tritone4801/chipathon-2026-A44-SAR-ADC/README.md

# Chipathon 2026 Team A44 8-bit SAR ADC

This repository contains the Team A44 8-bit, 2 MS/s, 3.3 V fully differential
capacitive SAR ADC design, its layouts, and its simulation results.

## DEF-aligned layout integration

The repository-root layout selected by `info.yaml` and `lvs_config.json` is
the `A44_A` project-slot top:

- [A44_A GDSII layout](gds/A44_A.gds)
- [A44_A integrated DEF](layout/def/A44_A.def)
- [A44_A LEF abstract](layout/lef/A44_A.lef)
- [Current layout files and physical checks](verification/a44_current_driven_pg_20260908)
- [Layout update record](layout/CHANGELOG.md)
- [Component layouts](gds/components)
- [Machine-readable current layout bindings](layout/CURRENT_LAYOUT.json)
- [Layout catalog and integration views](layout/README.md)

`A44_A` uses the official DEF origin `(0, 0)` and 1110-by-1110 um outline. Its
89 logical pins and 127 Metal2 pin shapes retain the official DEF locations:
85 logical pins are on the west edge and the four analog pins are on the north
edge. The 1000-by-1000 um SAR ADC CORE remains a child at `(55, 55)`.

## Current DRIVER_R2 layout implementation

The selected files are the local `DRIVER_R2` current-driven PG repair built on
the published VMP3/Q2 analog-ESD snapshot. It retains the MIM M5 coverFT and
earlier parent PG changes, then adds 209 metal rectangles and 1,924 ordinary
via cuts at the TOP, CORE and comparator owner levels. The interface, circuit
reference, DEF and LEF are unchanged. Current GDS files and saved views are
listed in [CURRENT_LAYOUT.json](layout/CURRENT_LAYOUT.json).

The [current publication and physical-check records](verification/a44_current_driven_pg_20260908),
[preserved VMP3 records](verification/a44_mslot_pg_20260905),
[Q2 analog ESD circuit](verification/a44_q2_analog_esd) and
[layout update record](layout/CHANGELOG.md) provide the corresponding files.

## Preserved earlier cap x1/3 baseline

The earlier cap x1/3 engineering baseline is preserved in the
[cap x1/3 CDAC package](verification/a44_cdac_cap_x1div3). It changes the C1
and dummy MIM multiplier from 18 to 6 while retaining the multiplier-18
reference switches, multiplier-8 sampling TG, comparator,
drivers, and SAR logic inherited from the W5P29 circuit.

The earlier package contains:

- [the cap x1/3 circuit delta](verification/a44_cdac_cap_x1div3/01_CURRENT_CIRCUIT_FILES);
- [R8/M6 east and west CDAC layouts](verification/a44_cdac_cap_x1div3/02_LAYOUT);
- [the earlier final-integration GDS and DRC/LVS records](verification/a44_cdac_cap_x1div3/02_LAYOUT/final_integration);
- [the official-DEF-aligned A44_A top and interface records](verification/a44_def_alignment);
- [structured acquisition, offset, and conversion results](verification/a44_cdac_cap_x1div3/03_RESULTS); and
- [the earlier package status](verification/a44_cdac_cap_x1div3/STATUS.json).

The CDAC component layout has zero native and GDS-readback DRC
errors on both sides and unique results for all 12 recorded LVS comparisons.
For the selected final-integration CORE cell, Magic full DRC reports zero
errors and all three hierarchical/flat full-transistor LVS views are unique.
The unified-TOP conversion records include `FAIL_FORMAL_MIN2`, where the second
MIN2 frame resolves to 0x00 in PEX while ideal and matching schematic resolve
to 0x01. The MIN-MAX-MIN and 0x7F-0x80-0x7F records contain the corresponding
three-frame codes and settling data.

## Preserved W5P29 schematic baseline

The previously published transistor-level schematic baseline is the
[W5P29 unit-transmission-gate-driver schematic package](verification/a44_w5p29_trans_driver/01_CURRENT_CIRCUIT_FILES).
It is additive; the
[original GitHub schematic](verification/a44_r2/01_CURRENT_CIRCUIT_FILES)
remains unchanged. Relative to that original schematic, the current baseline
changes only the following published components, bindings, and sizes:

- **StrongARM comparator:** the input pair changes from M3/M4 at
  W/L = 3.51/0.28 µm, `m=4`, to CMP55_A XCOMP_INPUT_P/N at
  W/L = 55.8/0.28 µm, `m=4`. The published M5/M6 width of 8.2524 µm and
  M7/M11 width of 16.8587 µm are retained.
- **CDAC:** the monolithic `CDAC`, whose
  capacitor multipliers are 1/2/4/8/16/32/64, changes to
  `A44_CDAC_UNIT_TRANS_DRIVER` with explicit
  `A44_C1_SWITCH`/C2/C4/C8/C16/C32/C64 unit hierarchy. Each C1 unit uses the
  6.855-by-6.855 µm MIM capacitor with multiplier 18 and N/P reference
  switches at W/L = 1.56/0.28 µm, `m=18`. Each side has 127 switched units
  plus one dummy unit, approximately 230.72 pF per side.
- **Sampling switch:** `SWITCH_BOOT_SP` changes to `A44_SWITCH_TRANS_TG8`;
  its N device is W/L = 3.11/0.28 µm, `m=8`, and its P device is
  W/L = 6.22/0.28 µm, `m=8`.
- **Digital-control drive:** the direct control connection changes to one
  `A44_CONVERSION_BUFFER` two-stage transistor driver per bit. INV1 N/P widths
  are 2.34/4.67 µm and INV2 N/P widths are 6.22/12.44 µm, all at L = 0.28 µm.
- **Sampling-clock drive:** direct `CLKS` distribution changes to the
  non-inverting C1 two-stage buffer and internal `CLKS_CORE`. Stage-one N/P
  widths are 0.78/1.56 µm and stage-two N/P widths are 3.11/6.22 µm, all at
  L = 0.28 µm.
- **SAR-logic binding:** the generic SS-corner PEX wrapper changes to the R1L
  true-transistor SS-corner PEX core and a header-aware 28-pin wrapper.
  The logic-to-converter/output interface changes from underscore aliases to
  `DCTRLP[7:1]`, `DCTRLN[7:1]`, and `DOUT[7:0]` bracket names.

## Preserved A44_W5P29_UNIT_TRANS_DRIVER electrical results

The following five entries and their order are preserved from the prior W5P29
publication. They describe the multiplier-18 capacitor baseline; current
multiplier-6 CDAC results are listed in the current package above.

| Simulation or execution | Completion | Result summary |
| --- | ---: | --- |
| 100-sample independent Monte Carlo mismatch dynamic simulation at the typical-typical process corner, 3.3 volts, 27 degrees Celsius, using the low differential-input band and steady-state frames 4 through 67 | **100/100** | Audit record: 100/100 hard-dynamic passes and 100/100 SNR-budget passes, with zero protocol, Parseval, or clipping failures; minimum/mean/maximum SNDR is 47.993/48.927/49.890 dB and ENOB is 7.680/7.835/7.995 bit |
| Full 255-transition static transfer-curve simulation | **255/255** | Representative preselected TT seed 98 passed all 255 transitions, with zero missing codes and zero nonmonotonic transitions; maximum absolute DNL is 0.109557 LSB and maximum absolute endpoint-fit INL is 0.133033 LSB |
| Three-corner process-voltage-temperature dynamic simulation using 20 selected Monte Carlo mismatch samples per corner | **60/60** | All 60 paired TT, SS, and FF records passed the system specification with zero protocol failures; mean SNDR is 48.928/46.270/48.760 dB, respectively, with SS as the limiting corner. The selected campaign uses fixed TT behavioral SAR timing |
| Circuit Automatic Characterization Engine package preflight | **Planned** | No CACE package preflight result is included in `PEX_GOLDEN_BASELINE`; the available preflight records describe individual simulation campaigns |
| Quick result-reproduction run | **Planned** | No quick result-reproduction run corresponding to this entry is included in `PEX_GOLDEN_BASELINE`; the folder instead contains audited 100-sample dynamic, full-static, selected three-corner 20-sample, and 100-sample offset packages |

Historical typical-corner results reproduce exactly when their historical
electrical inputs are restored. The current C18 unit converter, TG8 switch,
CMP55_A input pair, control drivers, and C1 clock buffer form a different
electrical baseline with its own result package.

## Preserved revision 2 package and electrical results

The preserved [revision 2 resized-circuit simulation package](verification/a44_r2)
contains:

- its revision 2 Xschem, SPICE, and RTL circuit files;
- completed dynamic, static, and PVT simulation
  results;
- CACE and simulation tooling;
- one-click launchers and method documentation.

All simulations planned for that preserved revision 2 package were executed;
the hard-dynamic results record failures at seeds 65, 68, and 141.

See [Team A44 revision 2 progress and performance](docs/A44_SAR_ADC_R2_PROGRESS_AND_PERFORMANCE.md)
for the complete methods, numerical results, and result locations.

The current project tracker is available at
[Team A44 project tracker, revision 2](docs/A44_SAR_ADC_Project_Tracker_20260728_R2.xlsx).

| Simulation or execution | Completion | Result summary |
| --- | ---: | --- |
| 200-sample Monte Carlo mismatch dynamic simulation at the typical-typical process corner, 3.3 volts, 27 degrees Celsius, using the low differential-input band and steady-state frames 4 through 67 | 200/200 | 197 hard-dynamic passes; failures at seeds 65, 68, and 141 |
| Full 255-transition static transfer-curve simulation | 6 unique curves | Pass based only on seed 44 at TT, 3.3 V, and 27 °C |
| Three-corner process-voltage-temperature dynamic simulation using 20 selected Monte Carlo mismatch samples per corner | 60/60 | Selected three-corner diagnostic campaign |
| Circuit Automatic Characterization Engine package preflight | 1/1 | Pass; final voltage is 1.250 V |
| Quick result-reproduction run | 130/130 | Pass |

For the full static transfer curve, seed 44 at TT, 3.3 V, and 27 °C is the
reported case. Its maximum
absolute DNL is 0.610351 LSB, its maximum absolute INL is 0.686645 LSB, and it
has no missing codes or reversals. Other TT seeds and the seed-44 SS and FF
corner curves are diagnostic only.

## One-click package entry points

From `verification/a44_r2` on Windows, run the quick result-reproduction flow:

```powershell
.\RUN_QUICK_VERIFY.ps1
```

The full campaign launcher executes every planned dynamic and static
simulation and can be long-running:

```powershell
.\RUN_FULL_CAMPAIGN.ps1
```

To stage and validate the full campaign without dispatching the complete
matrix:

```powershell
docker exec iic-osic-tools_a44_xvnc bash --noprofile --norc -lc "cd /foss/designs/chipathon-2026-A44-SAR-ADC/verification/a44_r2 && make -C 03_CACE_AND_SIMULATION_TOOLS full-dry-run"
```

## Ideal reference model

The earlier ideal SAR ADC flow remains available under
[the ideal reference model](verification/ideal_sar). It provides the ideal
system-level reference implementation and associated simulation flow.
