tritone4801/chipathon-2026-A44-SAR-ADC/verification/a44_r2/02_SIMULATION_RESULTS/05_CACE_GENERATED/reports/cace_job.md

# cace_job

- Description: A44 standalone package CACE 2.9 executable preflight
- PDK: gf180mcuD

## Authorship

- Designer: OpenAI Codex packaging workflow
- Company: None
- Created: 2026-07-28
- Last modified: 2026-07-28
- License: None

## Pins

## Default Conditions

## Symbol

Symbol of cace_job

## Schematic

Schematic of cace_job
