tritone4801/chipathon-2026-A44-SAR-ADC/verification/a44_r2/02_SIMULATION_RESULTS/02_PVT3_MC20_LOW_W4/reports/pvt3_mc20_report_cn.md

# StrongARM 比较器调整尺寸后的三工艺电压温度角动态仿真报告

本报告覆盖典型、慢速和快速三个工艺角；每个工艺角使用 20 个选定的
蒙特卡洛失配样本，共完成 60 个作业。

## 固定方法

- 最大瞬态步长：50 皮秒；
- 信号范围：低差分输入区间；
- 每个作业：68 帧；
- 第 0 至第 3 帧：首次转换和启动诊断；
- 第 4 至第 67 帧：正式稳态频谱统计窗口；
- 数字逻辑保持典型工艺角时序，逻辑电平和接口阈值随各工艺角电源电压缩放；
- 调整尺寸前后的比较使用相同失配种子、工艺角、电容式数模转换器失配样本和事件噪声种子。

## 各工艺角结果

### 典型工艺角、3.3 伏、27 摄氏度

- 硬动态通过数从 14/20 提高到 19/20；
- 信噪预算通过数从 10/20 提高到 18/20；
- 信号噪声失真比的配对中位数变化为正 0.922 分贝；
- 有效位数的配对中位数变化为正 0.1531 位；
- 首次转换诊断为 20/20。

### 慢速工艺角、3.0 伏、125 摄氏度

- 硬动态通过数从 18/20 提高到 20/20；
- 信噪预算通过数从 16/20 提高到 19/20；
- 信号噪声失真比的配对中位数变化为负 0.135 分贝；
- 有效位数的配对中位数变化为负 0.0224 位；
- 首次转换诊断为 20/20。

### 快速工艺角、3.6 伏、负 40 摄氏度

- 硬动态通过数从 2/20 提高到 20/20；
- 信噪预算通过数从 1/20 提高到 18/20；
- 信号噪声失真比的配对中位数变化为正 4.756 分贝；
- 有效位数的配对中位数变化为正 0.7900 位；
- 首次转换诊断为 20/20。

## 跨工艺角结果

典型工艺角有 19 个样本通过，其中 19 个样本在慢速和快速工艺角下也继续
通过。另有 1 个样本在非典型工艺角恢复，没有样本因工艺角变化而从通过
变为未通过。

## 结论边界

这 20 个样本是定向选择的尾部、边缘和机制诊断样本，不代表总体良率。
本报告只说明同一固定动态方法下的比较器尺寸变化结果，不形成 200 样本
蒙特卡洛总体、晋级或签核结论。
