tritone4801/chipathon-2026-A44-SAR-ADC/verification/a44_r2/02_SIMULATION_RESULTS/04_CROSS_CAMPAIGN_SUMMARY/reports/FINAL_REPORT_CN.md

# 当前 StrongARM 比较器调整尺寸后的动态与静态仿真汇总

## 结论

所有规定仿真均已执行。动态总体结果明显改善，但 200 样本蒙特卡洛失配
动态仿真仍有 3 个样本未通过硬动态判据，因此当前设计不晋级，也不作签核
声明。

种子 44 在慢速工艺角、3.0 伏、125 摄氏度下的完整静态传输曲线保留为
诊断结果；唯一静态资格判定依据仍是种子 44 在典型工艺角、3.3 伏、
27 摄氏度下的曲线。

## 200 样本蒙特卡洛失配动态仿真

固定条件为典型工艺角、3.3 伏、27 摄氏度、低差分输入区间、50 皮秒
最大瞬态步长，以及第 4 至第 67 帧的正式稳态统计窗口。

- 完整记录：200/200；
- 执行异常：0；
- 硬动态通过：197/200；
- 未通过种子：65、68、141；
- 信号噪声失真比第一、第五、第十百分位和中位数分别为
  46.8729、47.2961、47.4636 和 48.4065 分贝；
- 正式批次墙钟时间：77.29 分钟。

## 三工艺电压温度角动态仿真，每角 20 个选定蒙特卡洛失配样本

| 工艺角与工作条件 | 硬动态通过 | 信噪预算通过 | 信号噪声失真比中位数 | 配对中位数变化 |
| --- | ---: | ---: | ---: | ---: |
| 典型工艺角、3.3 伏、27 摄氏度 | 19/20 | 18/20 | 48.4048 分贝 | 正 0.9217 分贝 |
| 慢速工艺角、3.0 伏、125 摄氏度 | 20/20 | 19/20 | 48.3026 分贝 | 负 0.1346 分贝 |
| 快速工艺角、3.6 伏、负 40 摄氏度 | 20/20 | 18/20 | 48.6010 分贝 | 正 4.7556 分贝 |

全部 60 个作业和 60 个首次转换诊断均完成。正式批次墙钟时间为
22.01 分钟。这些样本用于工艺角诊断，不能外推生产良率。

## 完整 255 个码间转换静态传输曲线仿真

| 工艺角与工作条件 | 种子 | 状态 | 最大绝对微分非线性 | 最大绝对积分非线性 | 缺失码 | 反转 |
| --- | ---: | --- | ---: | ---: | ---: | ---: |
| 典型工艺角、3.3 伏、27 摄氏度 | 44 | 通过，唯一资格依据 | 0.6104 个最低有效位 | 0.6866 个最低有效位 | 0 | 0 |
| 典型工艺角、3.3 伏、27 摄氏度 | 116 | 仅诊断 | 0.4226 个最低有效位 | 0.3580 个最低有效位 | 0 | 0 |
| 典型工艺角、3.3 伏、27 摄氏度 | 180 | 仅诊断 | 0.4695 个最低有效位 | 0.4519 个最低有效位 | 0 | 0 |
| 典型工艺角、3.3 伏、27 摄氏度 | 106 | 仅诊断 | 0.1467 个最低有效位 | 0.0939 个最低有效位 | 0 | 0 |
| 慢速工艺角、3.0 伏、125 摄氏度 | 44 | 仅诊断 | 1.4963 个最低有效位 | 1.5726 个最低有效位 | 1 | 1 |
| 快速工艺角、3.6 伏、负 40 摄氏度 | 44 | 仅诊断 | 0.3288 个最低有效位 | 0.4168 个最低有效位 | 0 | 0 |

共计算 6 条唯一曲线和 1530 个码间转换。种子 44 的典型工艺角曲线只
计算一次，并在两个结果视图中复用。

## 声明边界

- 200 样本蒙特卡洛失配动态仿真只覆盖固定的典型工艺角和低差分输入区间；
- 三工艺电压温度角动态仿真使用定向选择的诊断样本，不能外推生产良率；
- 完整静态仿真是确定性的种子与工艺角传输曲线；
- 不作版图、寄生提取、硅片、生产良率、流片或签核声明。
