tritone4801/chipathon-2026-A44-SAR-ADC/verification/a44_r2/02_SIMULATION_RESULTS/05_CACE_GENERATED/reports/cace_job_schematic.md

# CACE Summary for cace_job

**netlist source**: schematic

| Parameter | Tool | Result | Min Limit  |  Min Value | Typ Target |  Typ Value | Max Limit  |  Max Value |  Status  |
| :--- | :--- | :--- | ---: | ---: | ---: | ---: | ---: | ---: | :---: |
| A44 package CACE and ngspice preflight | ngspice | final_v | 1.249 | 1.25 | | | 1.251 | 1.25 | Pass ✅ |

## Plots
