tritone4801/chipathon-2026-A44-SAR-ADC/verification/a44_r2/02_SIMULATION_RESULTS/01_MC200_TT_LOW_W4/source_snapshot/prior_model_audits/comparator_noise_probability_report.md

# Comparator Noise Probability Report

- Generated UTC: `2026-07-01T23:57:59+00:00`
- Production design files modified: `none`

- Imported status: `PASS_SAR_EFFECTIVE_NOISE_SENSITIVITY_NOT_NATIVE_TRANSIENT_NOISE`
- Source directory: `D:\PICO\SAR_SUM_process_typicality_20260701_initial_gate\reports`

Claim boundary: The existing noise result is SAR-effective sensitivity, not native transient-noise decision-probability signoff.
