tritone4801/chipathon-2026-A44-SAR-ADC/verification/a44_r2/02_SIMULATION_RESULTS/01_MC200_TT_LOW_W4/references/fixed50_41_compact/reports/A44_MC200_FIXED50PS_NONREPRO_SUBSET_RERUN_REPORT_CN.md

# A44 200 样本蒙特卡洛失配仿真固定 50 ps 不可复现子集复现实验报告

## 1. 任务与固定条件

本次任务只复现此前 200 样本蒙特卡洛失配仿真结果中被判定为不一致或不可复现的部分，并与后期单独 10 样本蒙特卡洛失配仿真、早期 200 样本蒙特卡洛失配仿真及第 7 版 200 样本蒙特卡洛失配仿真对照。仿真条件在执行前冻结：

- 目标并集：41 个 seed-band 记录，41 个唯一 seed
- `maxstep = 50 ps`
- `solver_profile = ROBUST_GEAR`
- `NFFT = 64`
- 每个目标独立进程运行，最多 4 个并发 ngspice

目标并集来自三类标记：

| 标记来源 | 记录数 |
|---|---:|
| 早期 200 样本蒙特卡洛失配仿真与 V7 的 LOW 输出码不一致 | 33 |
| 后期 10 样本蒙特卡洛失配仿真与 V7 输出码不一致 | 6 |
| 极低尾部历史输出码未被 V7 复现 | 17 |

三类之间有重叠，因此并集为 41，不是 56。

## 2. 执行完整性

仿真于 2026-07-25 完成，执行状态为 `PASS_FIXED50_EXECUTION`：

- 41/41 目标记录有效
- 2624/2624 帧输出码存在
- 全部记录确认为 50 ps、`ROBUST_GEAR`
- 所有噪声输入一致性状态匹配
- 无 timeout、无仿真中止
- 最大并发 ngspice 数为 4
- 实际执行时间 752.992 s，约 12 分 33 秒

执行使用固定 50 ps 和独立进程 fallback。

## 3. 与各历史结果的整记录对照

“整记录一致”要求该 seed-band 的 64 帧输出码完全相同。

| 参考数据 | 可比记录 | 整记录一致 | 整记录不同 | 相同帧 | 不同帧 |
|---|---:|---:|---:|---:|---:|
| 早期 200 样本蒙特卡洛失配仿真 | 34 | 9 | 25 | 2149 | 27 |
| version 7 200-sample Monte Carlo mismatch simulation | 41 | 24 | 17 | 2607 | 17 |
| version 10 10-sample Monte Carlo mismatch simulation | 5 | 5 | 0 | 320 | 0 |
| version 11 10-sample Monte Carlo mismatch simulation | 4 | 4 | 0 | 256 | 0 |

V10 与 V11 有 1 个重叠目标，因此后期 10 样本蒙特卡洛失配仿真实际覆盖 8 个唯一目标；这 8 个目标全部与本次固定 50 ps 结果整记录一致。

## 4. 各类争议的归类结果

### 4.1 早期 200 样本蒙特卡洛失配仿真与 V7 的 33 个 LOW 分歧

- 本次固定 50 ps 结果与早期 200 样本蒙特卡洛失配仿真一致：9
- 与第 7 版 200 样本蒙特卡洛失配仿真一致：24
- 落入第三种整记录结果：0
- 其中具有后期 10 样本蒙特卡洛失配仿真参考的 6 个，全部与后期 10 样本蒙特卡洛失配仿真一致

这说明本次结果仍在两个历史分支间分化，但没有生成第三个完整输出流。

### 4.2 后期 10 样本蒙特卡洛失配仿真与 V7 的 6 个分歧

- 与后期 10 样本蒙特卡洛失配仿真一致：6/6
- 与 V7 一致：0/6

因此，在固定 50 ps、`ROBUST_GEAR` 条件下，原先的 6 个 10 样本蒙特卡洛失配仿真/V7 分歧明确落在后期 10 样本蒙特卡洛失配仿真一侧。

### 4.3 极低尾部的 17 个历史未复现记录

- 17/17 的指定争议帧与 R1 单独回放输出码一致
- 0/17 与 V7 正式结果中对应帧一致
- 相对 V7，每个记录恰好只有 1 帧不同，共 17 个不同帧
- 其中 6 个目标没有完整的早期 200 样本蒙特卡洛失配仿真/后期 10 样本蒙特卡洛失配仿真记录可作整记录参考，但其指定帧仍与 R1 回放一致

因此，本实验确认了“R1 回放分支”可在统一固定 50 ps 条件下再次复现；它没有复现 V7 中这 17 个极低尾部正式输出码。

## 5. maxstep 与求解器配置的解释力

针对早期 200 样本蒙特卡洛失配仿真与 V7 的 33 个 LOW 分歧，按早期运行配置分组：

| 早期配置 | 记录数 | 本次匹配早期 | 本次匹配 V7 |
|---|---:|---:|---:|
| 50 ps + DEFAULT | 6 | 0 | 6 |
| 50 ps + ROBUST_GEAR | 10 | 5 | 5 |
| 100 ps + DEFAULT | 17 | 4 | 13 |

据此可得：

1. 从早期的 50 ps + DEFAULT 改为固定的 50 ps + `ROBUST_GEAR`，6 个目标全部转到 V7 侧，说明求解器配置会影响分支。
2. 从 100 ps + DEFAULT 改为固定的 50 ps + `ROBUST_GEAR`，多数目标转到 V7 侧，但仍有 4 个保持早期侧。
3. 即便早期已经是相同的 50 ps + `ROBUST_GEAR`，10 个目标仍然 5/5 分裂。

因此，`maxstep` 和求解器配置具有影响，但不足以单独解释全部历史不一致。仅把 maxstep 固定为 50 ps，不能把所有目标收敛到唯一历史结果，也不能据此指定某一份历史 200 样本蒙特卡洛失配仿真为唯一“真值”。

## 6. 结论

- 本次 41 个目标的固定 50 ps 复现执行完整、数据有效。
- 后期 10 样本蒙特卡洛失配仿真的全部 8 个唯一可比目标均被精确复现。
- 原 6 个 10 样本蒙特卡洛失配仿真/V7 分歧全部支持后期 10 样本蒙特卡洛失配仿真分支。
- 17 个极低尾部指定帧全部支持 R1 回放分支，而不支持 V7 正式分支。
- 33 个早期 200 样本蒙特卡洛失配仿真/V7 LOW 分歧仍分为 9 个早期侧和 24 个 V7 侧；固定 50 ps 不是充分归因变量。

## 7. 非声明

本实验只覆盖冻结的 41 个争议 seed-band 记录，未重跑完整 200-seed × 2-band 200 样本蒙特卡洛失配仿真。因此：

- 不声明完整 200 样本蒙特卡洛失配仿真重新完成；
- 不重算或替代完整 200 样本蒙特卡洛失配仿真的 P10/P5/P1 动态性能；
- 不声明良率、极低尾部统计或 signoff 已关闭；
- 不把本次定向复现结果外推为所有 seed、band 或仿真配置的确定性结论。
