tritone4801/chipathon-2026-A44-SAR-ADC/layout/images/A44_SAR_ADC_CDAC_E_390X399P7.png

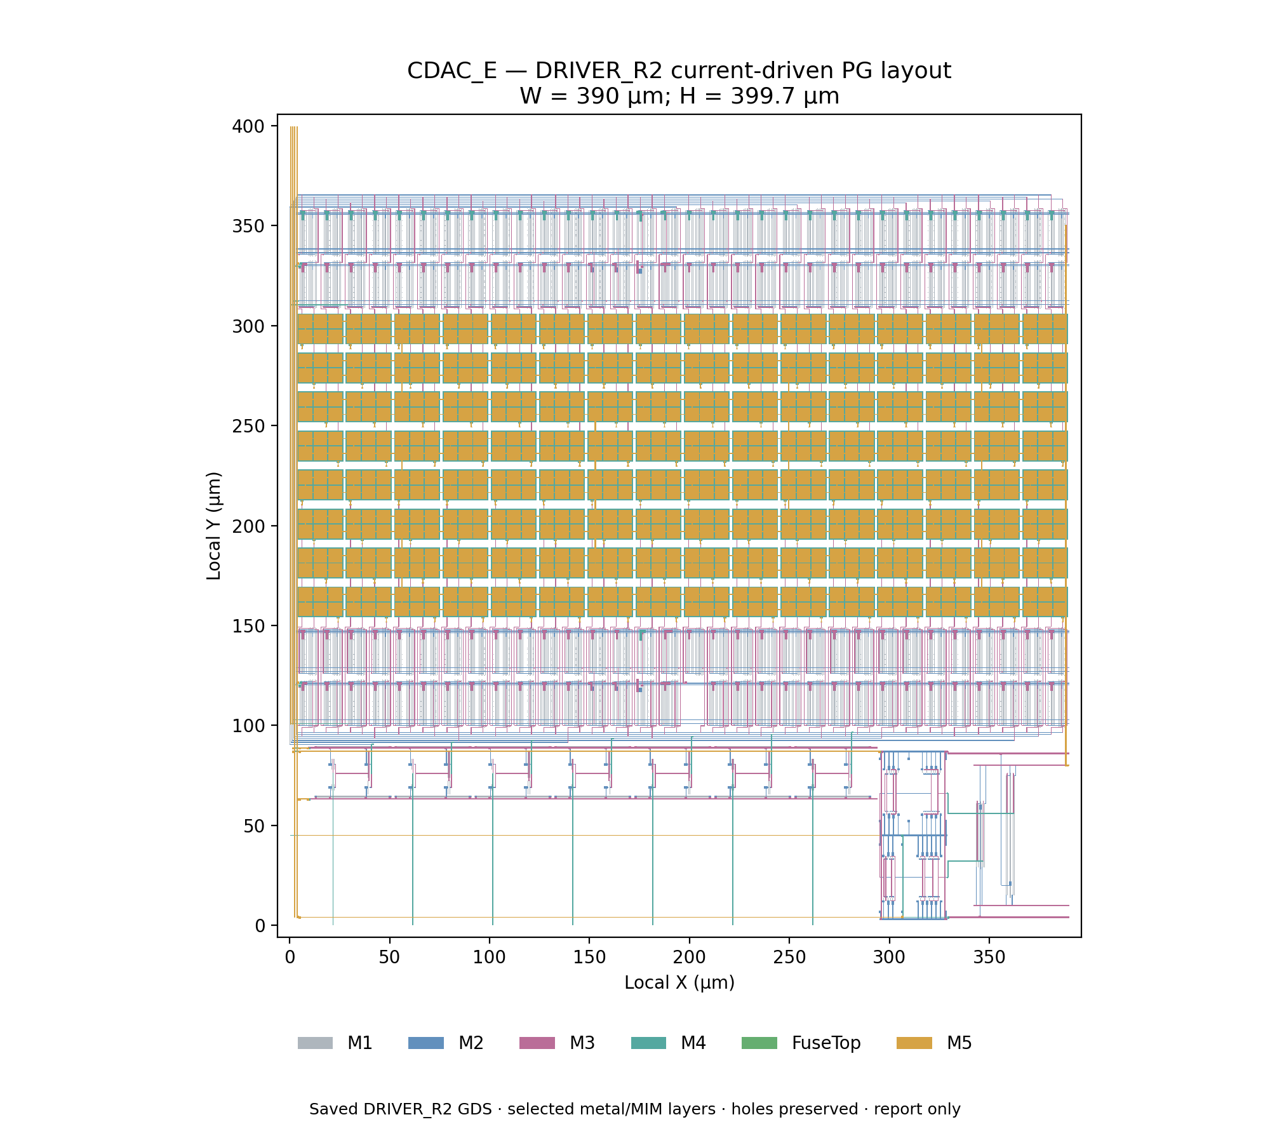
layout/images/A44_SAR_ADC_CDAC_E_390X399P7.png
