tritone4801/chipathon-2026-A44-SAR-ADC/layout/images/A44_SAR_ADC_CORE_1000.png

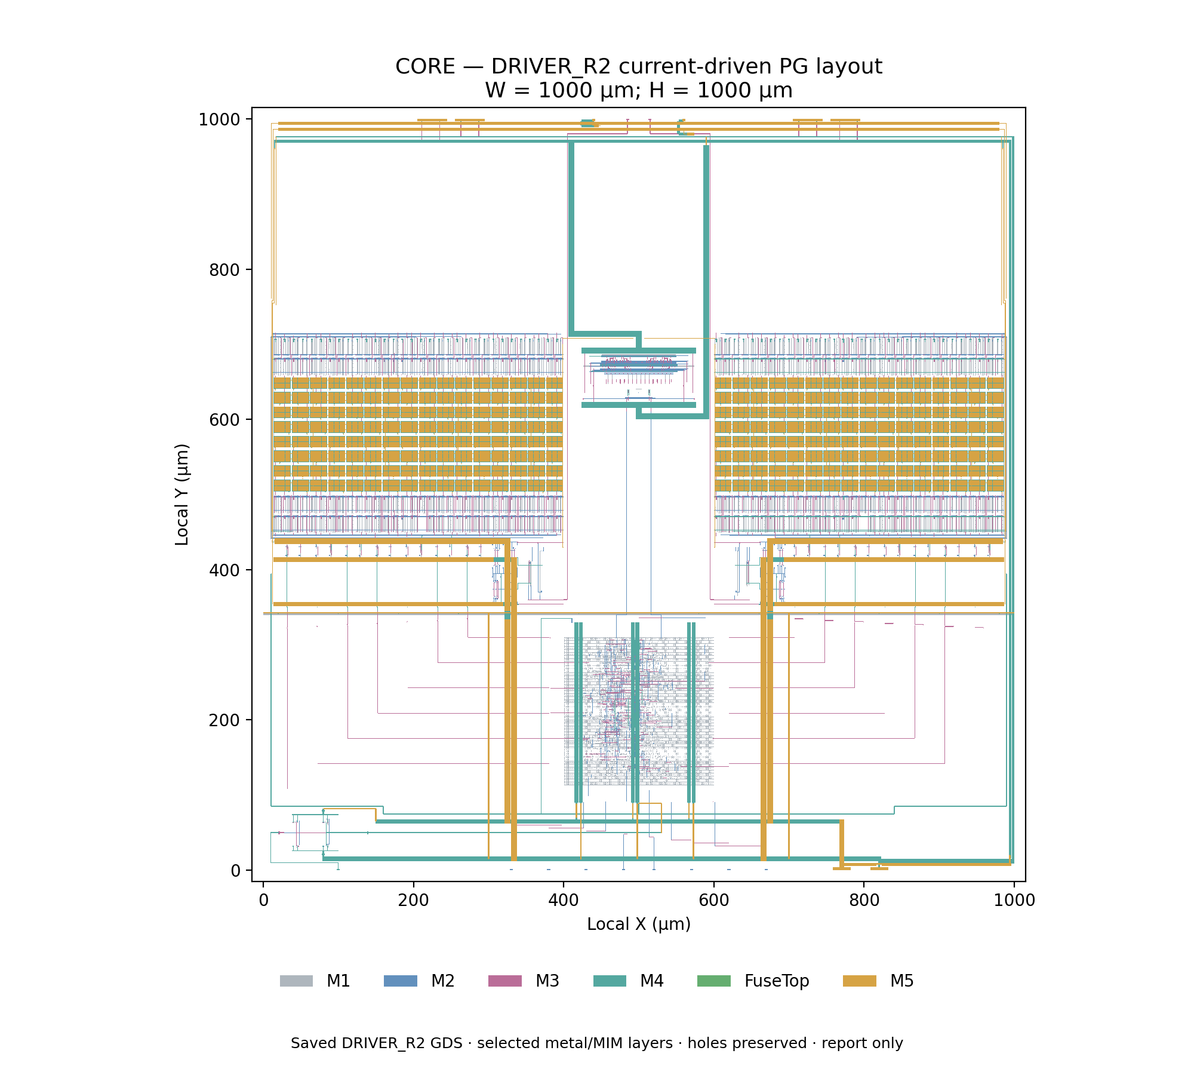
layout/images/A44_SAR_ADC_CORE_1000.png
