tritone4801/chipathon-2026-A44-SAR-ADC/layout/images/current_driven_pg_20260908/A44_SAR_ADC_CDAC_W_390X399P7.png

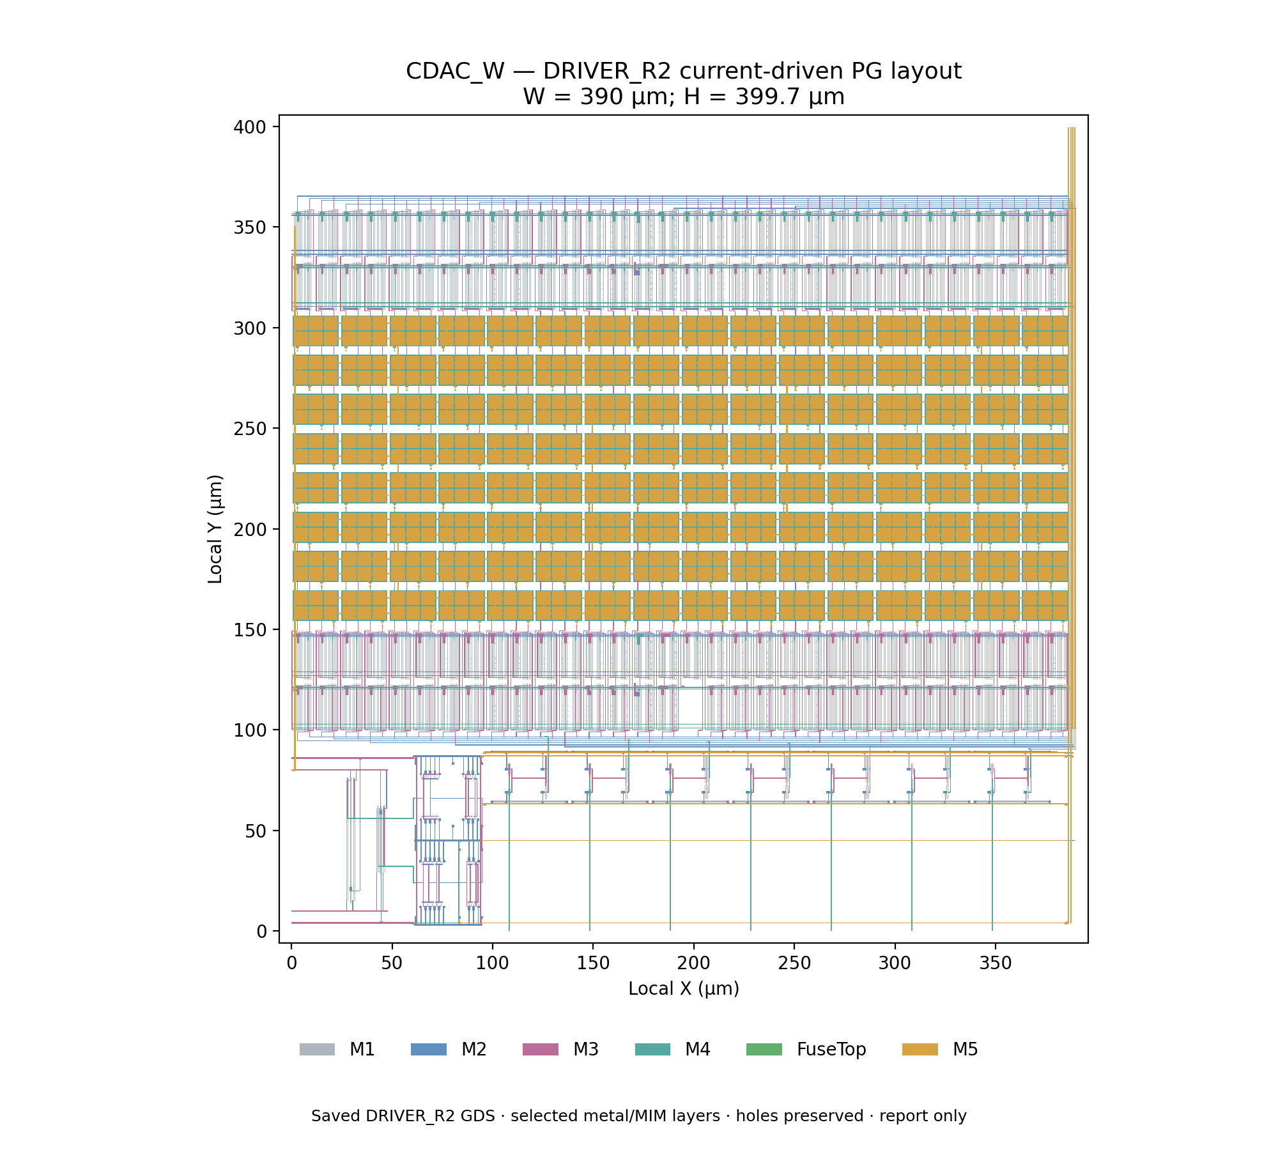
layout/images/current_driven_pg_20260908/A44_SAR_ADC_CDAC_W_390X399P7.png
