tritone4801/chipathon-2026-A44-SAR-ADC/layout/images/current_driven_pg_20260908/A44_SAR_ADC_SAR_LOGIC_240X240.png

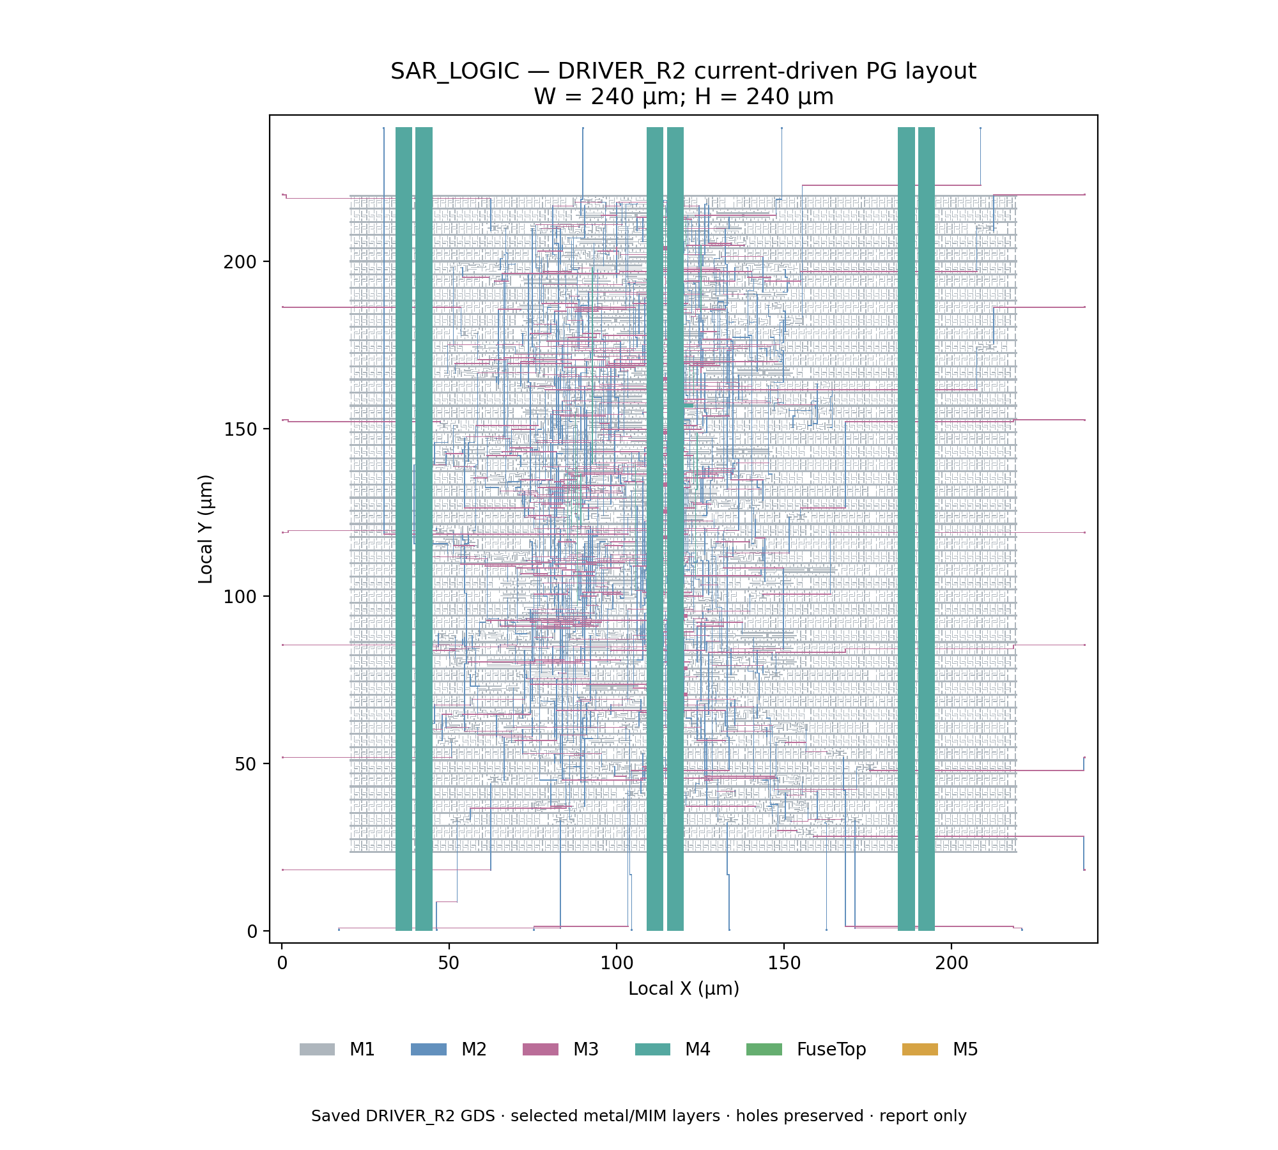
layout/images/current_driven_pg_20260908/A44_SAR_ADC_SAR_LOGIC_240X240.png
