tritone4801/chipathon-2026-A44-SAR-ADC/layout/images/mslot_pg_20260905/A44_SAR_ADC_CDAC_W_390X399P7.png

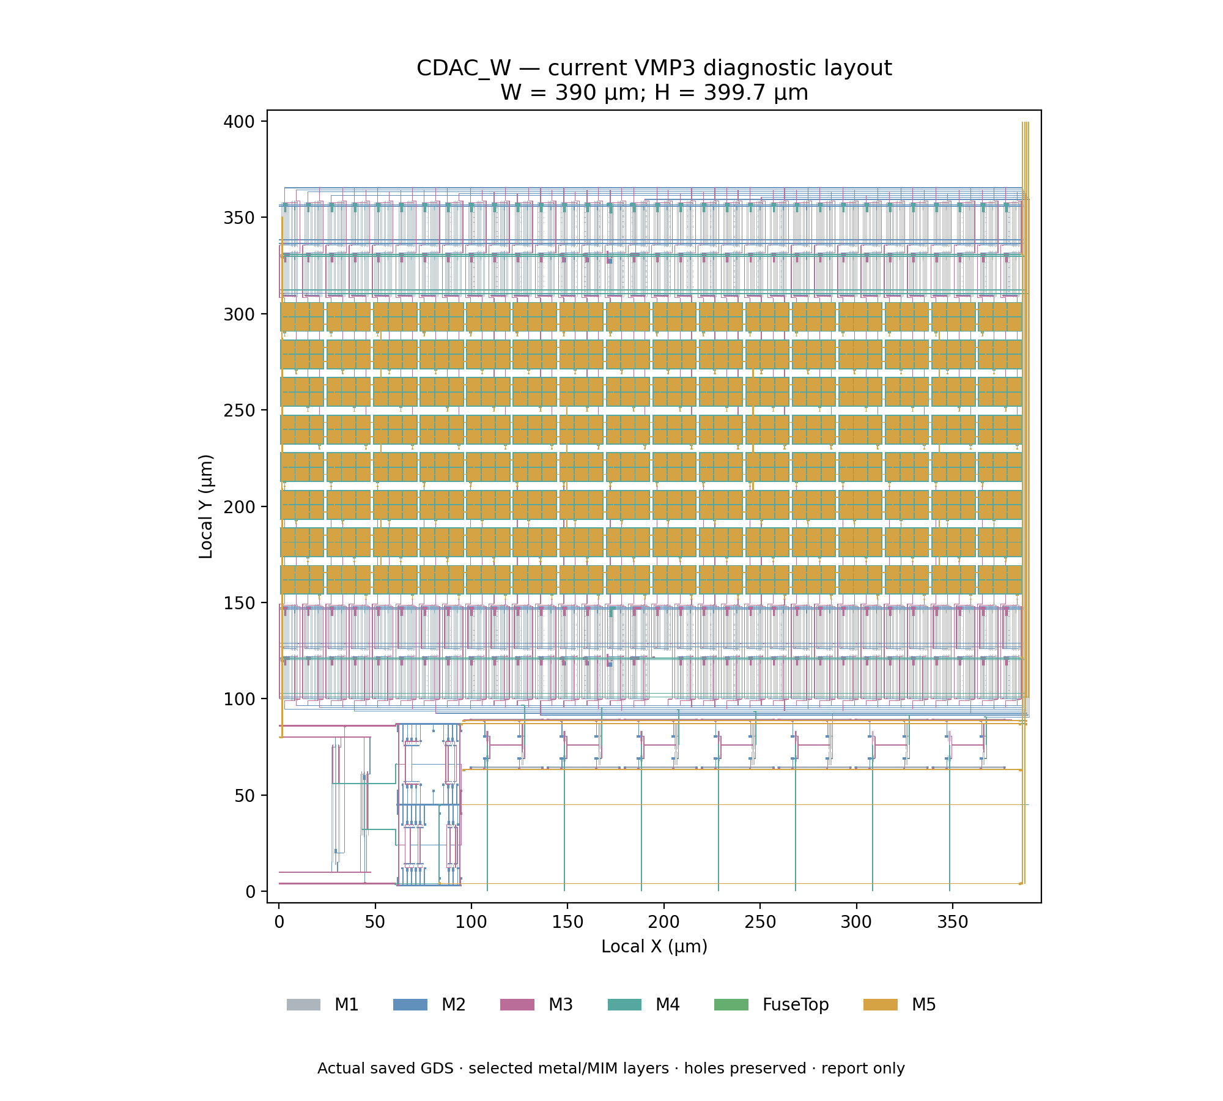
layout/images/mslot_pg_20260905/A44_SAR_ADC_CDAC_W_390X399P7.png
