tritone4801/chipathon-2026-A44-SAR-ADC/layout/images/mslot_pg_20260905/A44_SAR_ADC_CLKS_BUFFER_120X60.png

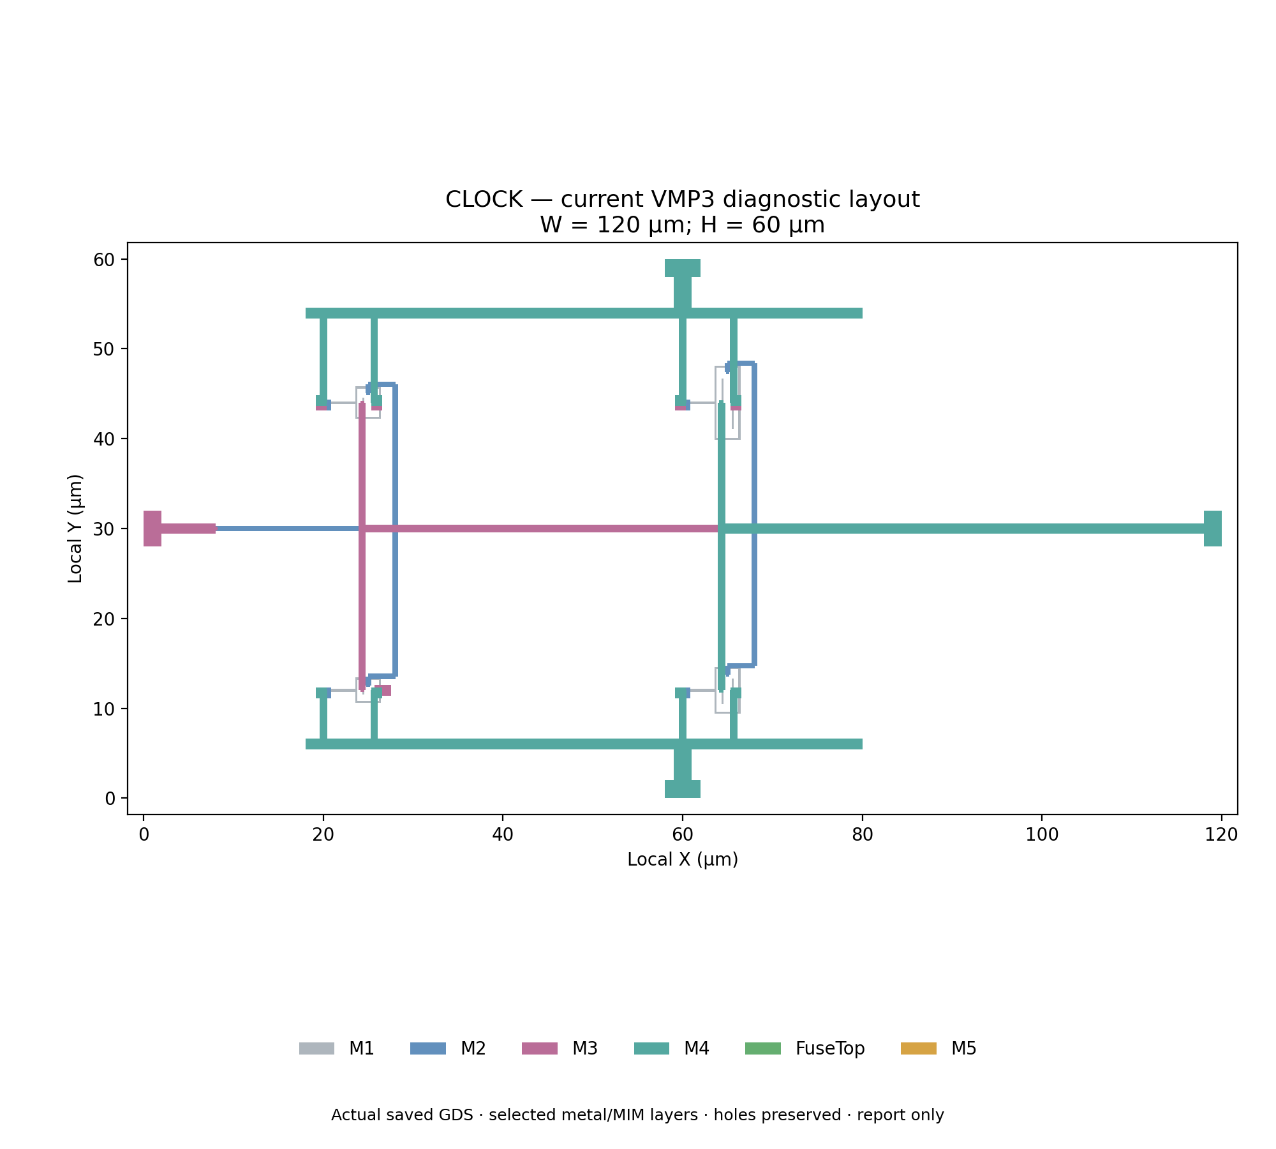
layout/images/mslot_pg_20260905/A44_SAR_ADC_CLKS_BUFFER_120X60.png
