tritone4801/chipathon-2026-A44-SAR-ADC/layout/images/mslot_pg_20260905/A44_SAR_ADC_CORE_1000.png

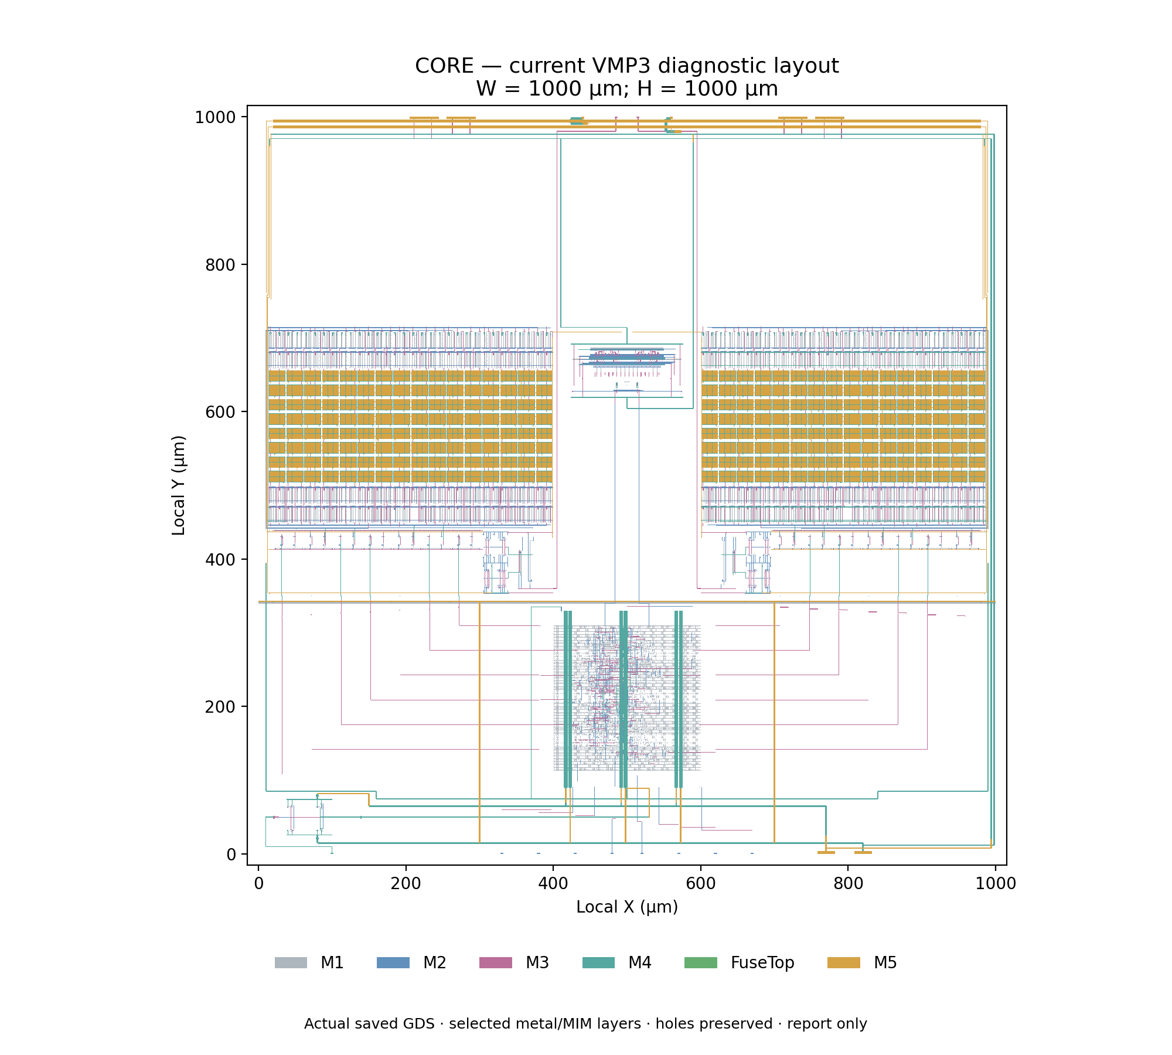
layout/images/mslot_pg_20260905/A44_SAR_ADC_CORE_1000.png
