tritone4801/chipathon-2026-A44-SAR-ADC/layout/images/q2_analog_esd_20260903/A44_ANALOG_ESD_ROUTES.png

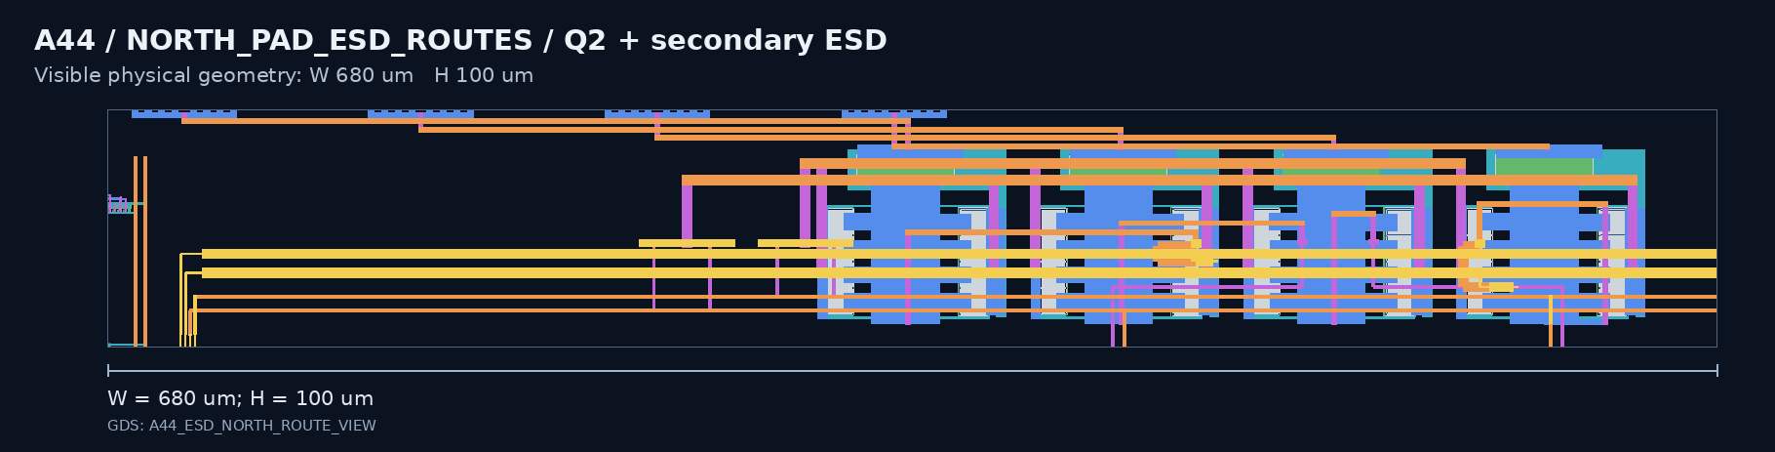
layout/images/q2_analog_esd_20260903/A44_ANALOG_ESD_ROUTES.png
