tritone4801/chipathon-2026-A44-SAR-ADC/layout/images/q2_analog_esd_20260903/io_secondary_5p0.png

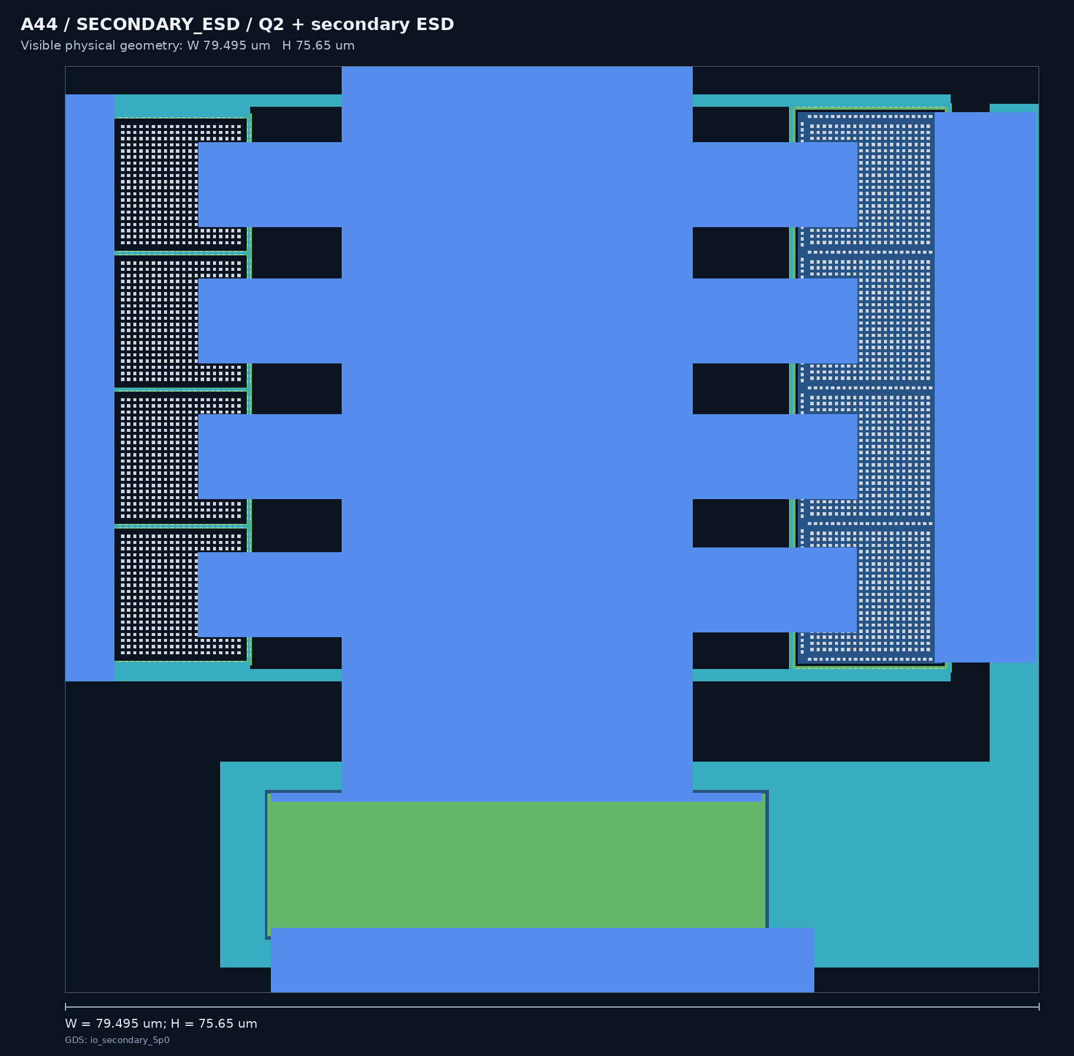
layout/images/q2_analog_esd_20260903/io_secondary_5p0.png
