tritone4801/chipathon-2026-A44-SAR-ADC/verification/a44_r2/02_SIMULATION_RESULTS/02_PVT3_MC20_LOW_W4/plots/pvt3_mc20_representative_spectra.png

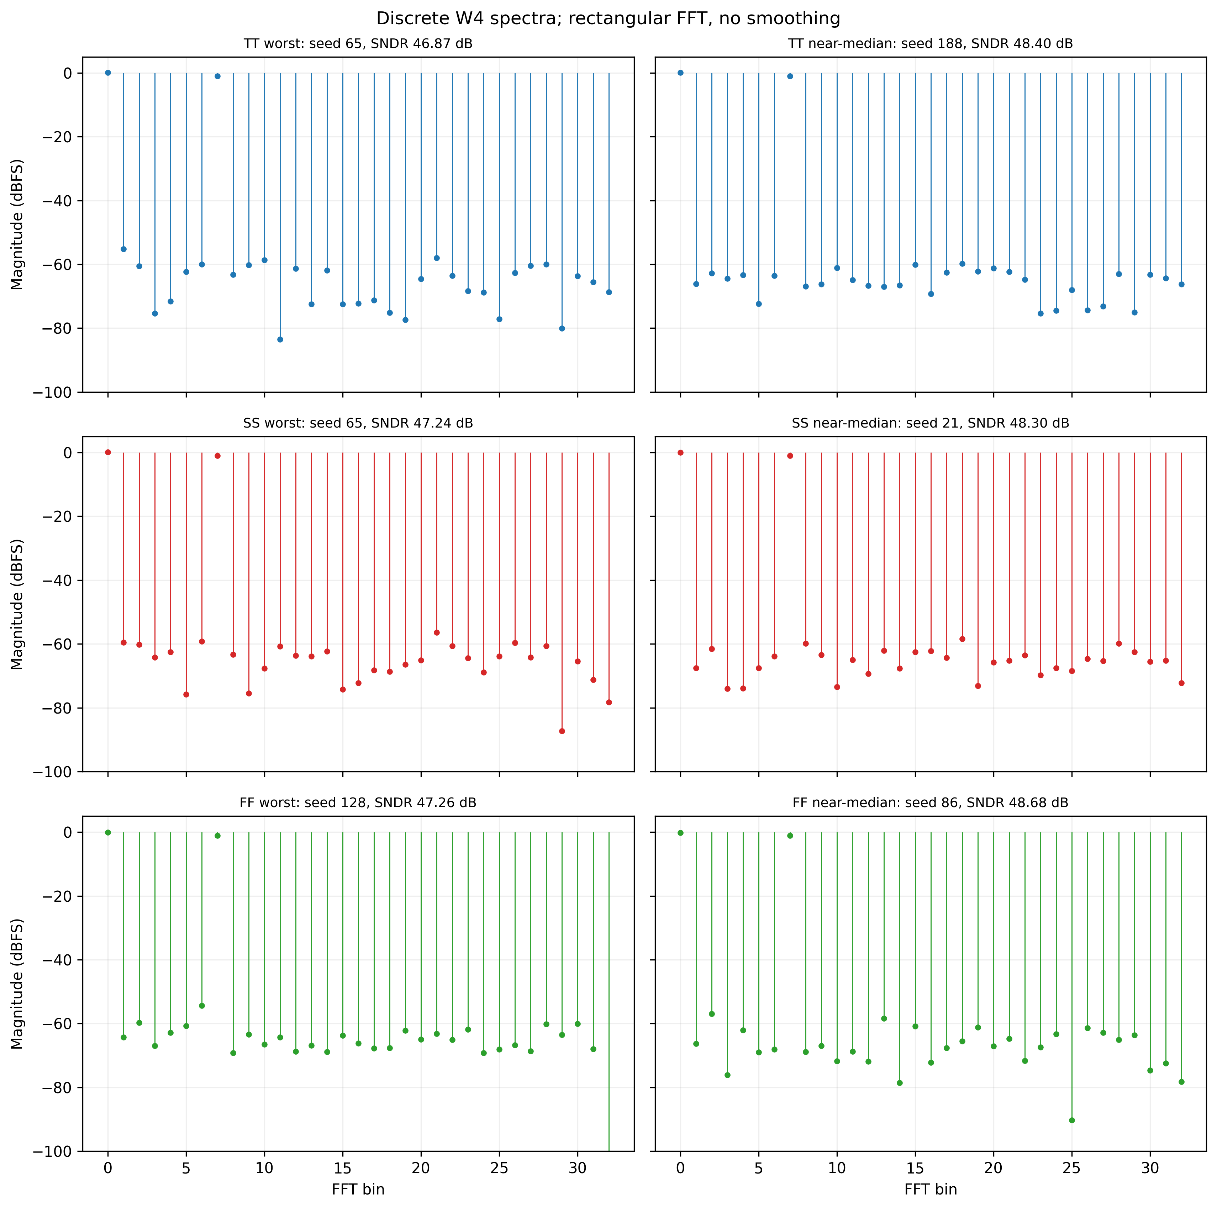
verification/a44_r2/02_SIMULATION_RESULTS/02_PVT3_MC20_LOW_W4/plots/pvt3_mc20_representative_spectra.png
