tritone4801/chipathon-2026-A44-SAR-ADC/verification/ideal_sar/results/plots/adc_quantization_error_spectrum_near_nyquist.png

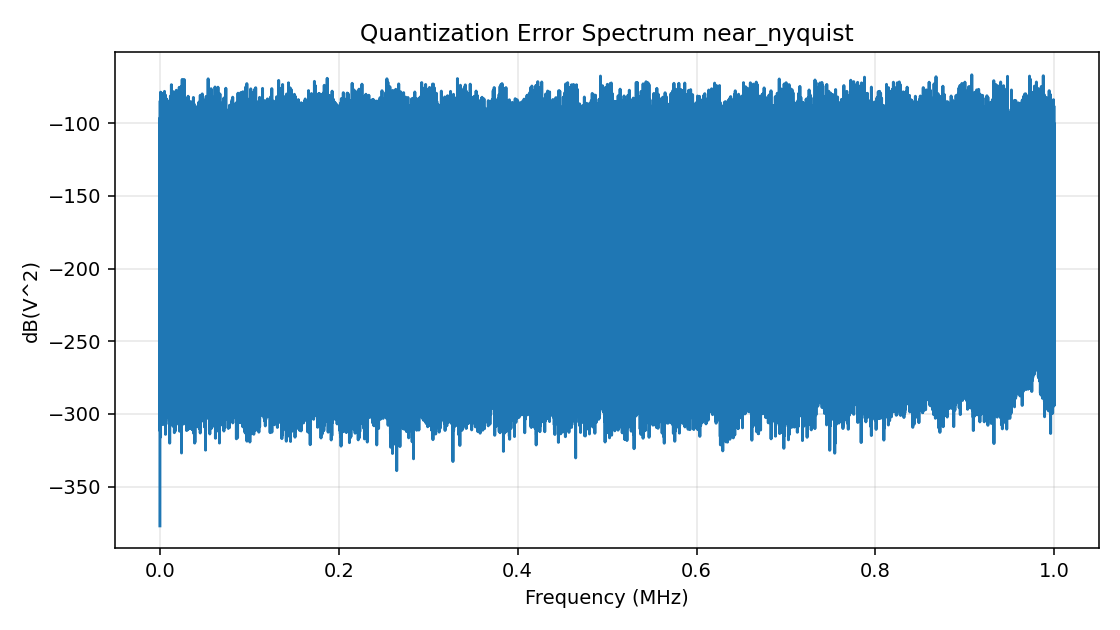
verification/ideal_sar/results/plots/adc_quantization_error_spectrum_near_nyquist.png
