tritone4801/chipathon-2026-A44-SAR-ADC/layout/images/q2_prefill_20260903/A44_SIX_COMPONENT_CATALOG.png

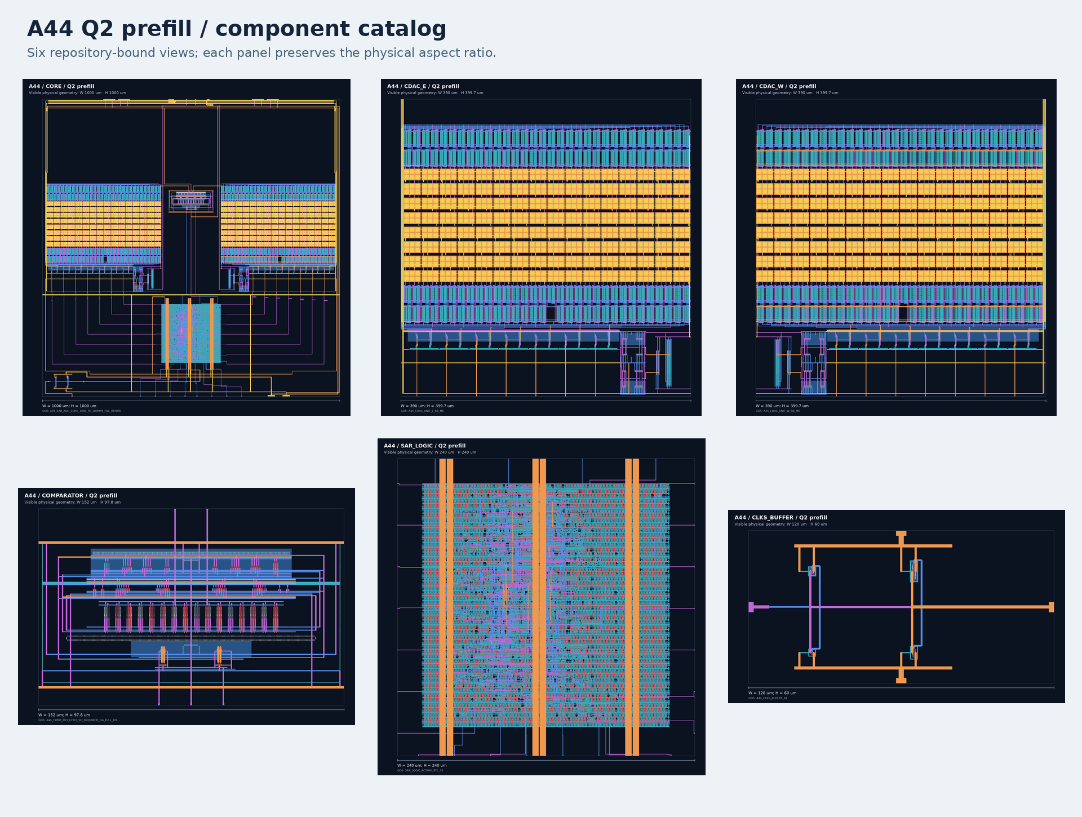
layout/images/q2_prefill_20260903/A44_SIX_COMPONENT_CATALOG.png
