tritone4801/chipathon-2026-A44-SAR-ADC/verification/a44_r2/02_SIMULATION_RESULTS/03_FULL255_STATIC/cases/S044_FF/references/historical_selection/static_mc200_reconstructed_summary.csv

mismatch_seed | sampler_offset_v | sampler_gain_negative | sampler_gain_positive | sampler_asymmetry_ppm | sampler_fit_rms_v | correction_offset_v | correction_vicm_slope_scaled_v | correction_settling_scale_v | correction_major_fit_max_error_lsb | correction_major_fit_rms_error_lsb | offset_lsb | gain_error_ppm | endpoint_lsb_v | minimum_code_width_lsb | missing_code_count | max_abs_dnl_lsb | max_abs_inl_endpoint_lsb | max_abs_inl_best_fit_lsb | worst_width_lower_code | worst_dnl_lower_transition | worst_inl_transition | static_risk_score | reconstructed_spec_status | cohort_residual_recalibrated
1 | 1.0196276058194913e-05 | 0.9999997187787143 | 0.9999990124791491 | -0.7063000132237282 | 1.755080678976236e-06 | -0.0014946245524099274 | -0.00603923505501917 | 1.0565306525111784e-05 | 0.005432267001369366 | 0.0030967193767179016 | 0.023504504144214292 | -1362.556924356384 | 0.013263153540848392 | 0.8449186531125571 | 0 | 0.2708838426398843 | 0.22810188692807565 | 0.22857637848017726 | 191 | 192 | 192 | 0.2708838426398843 | PASS | True
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
