tritone4801/chipathon-2026-A44-SAR-ADC/verification/a44_mslot_pg_20260905/README.md

# A44 MIM coverFT and PG layout files

This directory contains the existing physical-check records associated with
the saved VMP3 `A44_A` GDS published in the repository.

- [GDS DRC/LVS records](reports/GDS_DRC_LVS)
- [Public KLayout records](reports/PUBLIC_KLAYOUT)
- [DEF interface comparison](reports/DEF_INTERFACE_AUDIT.json)
- [Cell geometry comparison](reports/ALL_CELL_READBACK.json)
- [Mask comparison](reports/ALL_MASK_READBACK.json)
- [Capacitor and rail invariants](reports/PROTECTED_CAPACITOR_AND_RAIL_INVARIANTS.json)
- [Existing image bindings](IMAGE_BINDING.json)

The reports retain their original contents, including paths from the capture
environment. Current repository filenames are listed in
[CURRENT_LAYOUT.json](../../layout/CURRENT_LAYOUT.json).
