tritone4801/chipathon-2026-A44-SAR-ADC/verification/a44_cdac_cap_x1div3/00_CONTRACT/README.md

# Contract and coverage

- [`BASELINE_STATUS.json`](BASELINE_STATUS.json) is the source baseline's
  current working-status record.
- [`CONFIRMED_SIMULATION_METHODS.json`](CONFIRMED_SIMULATION_METHODS.json)
  freezes the input fixture, acquisition criterion, transient method, and
  result classifications.
- [`SIMULATION_COVERAGE_CURRENT_VS_OLD.csv`](SIMULATION_COVERAGE_CURRENT_VS_OLD.csv)
  separates completed current-capacitor work from historical results and
  remaining coverage.

These files are copied from the named baseline and retain its recorded values
and classifications.
