tritone4801/chipathon-2026-A44-SAR-ADC/verification/ideal_sar/results/README.md

# Ideal SAR ADC Results Map

This document is the review index for `verification/ideal_sar/results/`.
It follows the result-file requirements from
`D:\PICO\CODEX_IDEAL_SAR_ADC_TESTBENCH_VALIDATION.md` and points every
summary claim back to generated CSV, JSON, log, raw-data, or plot artifacts.
It does not introduce new measurements; the source of truth remains the
machine-readable result files.

## Status Snapshot

- Decision: `GO - testbench validated for schematic phase`.
- Authoritative full run: `logs/run_all_container.log`, ending with
  `go_no_go: GO` and `EXIT_CODE=0`.
- Final report: `../report/ideal_sar_adc_testbench_validation.md`.
- Single configuration source: `../config/sar_adc.yaml`.
- Machine-readable summaries: `metrics.json` and `csv/metrics.csv`.
- Coverage matrix: `csv/coverage_matrix.csv`, all rows PASS after report
  regeneration.
- Current result inventory is regenerated by `run_all.py all`; the dynamic
  subset includes timestamped input/output CSV, dBFS spectrum CSV, and figures
  for both canonical tones.

## Scope and Limits

The result package validates the ideal ADC/DAC/SAR testbench only. It confirms
that the measurement harness gives ideal results for a known-correct model and
detects injected bad models. It does not claim GF180 transistor-level sampler,
CDAC, comparator, reference, clock, layout parasitic, or SAR ADC power
performance. The power result is only a measurement-chain self-test.

The repository keeps the primary summary CSV at `results/csv/metrics.csv`
instead of `results/metrics.csv` so that all CSV files stay in one subdirectory.
This is the documented layout adjustment allowed by the execution
specification. `metrics.json` stays at the result root.

## Result Directory Map

| Path | Purpose | Primary consumer |
|---|---|---|
| `metrics.json` | Structured summary for all stages, tool versions, GO status, and derived constants. | Report builder and reviewers. |
| `csv/metrics.csv` | Main metric table with the required schema and local report-helper columns. | Summary table, signoff review. |
| `csv/coverage_matrix.csv` | Requirement-by-requirement PASS/FAIL coverage mapping. | Document completeness review. |
| `csv/*.csv` | Independent CSV data for functional, timing, static, dynamic, DAC, power-harness, fault-injection, and repeatability tests. | Metric drilldown. |
| `csv/adc_input_output_time_*.csv` | Timestamped representative input/output rows for the `0.8823529411764706` FS-peak canonical tones, equivalent to the frozen `3.0 Vpp,diff` input. Columns include VINP/VINN, sampled `v_diff`, EOC_INT-updated code, hex code, ideal-DAC output voltage, reconstruction, quantization error in V and LSB, CLKS falling sample marker, and EOC_INT. The official waveform comparison method is sampled input versus `ideal_DAC(DOUT)` reconstructed from EOC_INT-updated DOUT. | Time-domain waveform review. |
| `csv/adc_dac_reconstruction_low_frequency.csv` | Low-frequency-only sampled-input, EOC_INT-updated DOUT, and ideal-DAC reconstruction rows. This is the preferred visual comparison view because it makes the `x[n]` to `ideal_DAC(DOUT)` pairing clear. | DAC reconstruction visual review. |
| `csv/adc_output_spectrum_*.csv` | One-sided coherent FFT bin table in dBFS for the canonical tones, with fundamental, folded harmonics, largest spur, and noise classifications. | Spectrum review. |
| `csv/dynamic_points/*.csv` | One CSV per amplitude/frequency/phase dynamic sweep point. | SQNR/SQDR/SQNDR validation. |
| `logs/*.log` | Preflight, ngspice, cocotb, power proxy, and full-container execution logs. | Tool and command records. |
| `plots/*.png` | Automatically generated figures for independent performance metrics, input/output waveforms, output-code waveforms, and output spectra. | Report figures and visual review. |
| `raw/*` | Raw dynamic output codes, quantization-error samples, cocotb XML, and power-proxy waveform. | Re-analysis and spot checks. |

## Key Metrics

| Category | Metric | Requirement or ideal expectation | Measured | Status | Result files |
|---|---|---:|---:|---|---|
| Preflight | External core tools | `ngspice` + cocotb + HDL simulator available | `True` | PASS | `csv/preflight_tools.csv`, `logs/run_all_container.log` |
| Static | DNL | `< +/-1 LSB` project, `<=0.01 LSB` ideal | `2.6867397195928788e-14 LSB` | PASS | `csv/static_dnl.csv`, `plots/dnl.png` |
| Static | Endpoint INL | `< +/-1.5 LSB` project, `<=0.01 LSB` ideal | `0.0 LSB` | PASS | `csv/static_inl.csv`, `plots/inl_endpoint_bestfit.png` |
| Static | Quantization error RMS | `1/sqrt(12) LSB` | `0.2888729004379287 LSB` | PASS | `raw/quantization_error_lsb.csv`, `plots/quantization_error_histogram.png` |
| Dynamic | SNDR worst | `>=44 dB`, theory `48.83284675354814 dB` at 3.0 Vpp,diff | `48.80429130384699 dB` | PASS | `csv/dynamic_metrics.csv`, `plots/adc_sndr_summary.png` |
| Dynamic | ENOB worst | `>=7.0 bit`, about `7.8 bit` ideal at -1.09 dBFS | `7.81466632954269 bit` | PASS | `csv/dynamic_metrics.csv`, `plots/adc_enob_summary.png` |
| Dynamic | SQNR total TD baseline | `0.8823529411764706` FS coherent tones, theory `48.83284675354814 dB` | `48.78590230327425 dB` | PASS | `csv/dynamic_metrics.csv`, `plots/adc_sqnr_total_time_domain_summary.png` |
| Dynamic | SQNR spectral baseline | `0.8823529411764706` FS coherent tones, theory `48.83284675354814 dB` | `48.88579228818422 dB` | PASS | `csv/dynamic_metrics.csv`, `plots/adc_sqnr_spectral_summary.png` |
| Dynamic | SQDR baseline | `0.8823529411764706` FS coherent tones, folded harmonic distortion metric | `66.11119264111058 dB` | PASS | `csv/dynamic_metrics.csv`, `plots/adc_sqdr_summary.png` |
| Dynamic | SQNDR baseline | SQNR/SQDR power closure at `0.8823529411764706` FS | `48.80429130384699 dB` | PASS | `csv/dynamic_metrics.csv`, `plots/adc_sqndr_summary.png` |
| Dynamic | SQNR total TD sweep worst | 5 amplitudes x 2 frequencies x 3 phases, down to 0.0625 FS | `25.314368453600782 dB` | PASS | `csv/dynamic_sqnr_sqdr_sweep.csv`, `plots/adc_sqnr_vs_amplitude.png` |
| Dynamic | SQDR sweep worst | 5 amplitudes x 2 frequencies x 3 phases, down to 0.0625 FS | `31.690836409855493 dB` | PASS | `csv/dynamic_sqnr_sqdr_sweep.csv`, `plots/adc_sqdr_vs_amplitude.png` |
| Dynamic | Input/output time waveform | `0.8823529411764706` FS canonical tones, k=997 and k=32113, phase 0.37 rad | generated | PASS | `plots/adc_input_output_time_low_frequency.png`, `plots/adc_input_output_time_near_nyquist.png`, `csv/adc_input_output_time_*.csv` |
| DAC | Low-frequency reconstruction waveform | official input/output comparison through ideal DAC(DOUT), low-frequency input | generated | PASS | `plots/adc_dac_reconstruction_low_frequency.png`, `csv/adc_dac_reconstruction_low_frequency.csv` |
| Dynamic | Output spectrum | `0.8823529411764706` FS canonical tones, one-sided dBFS FFT, M=65536, no window | generated | PASS | `plots/adc_fft_low_frequency.png`, `plots/adc_fft_near_nyquist.png`, `csv/adc_output_spectrum_*.csv` |
| Dynamic | Direct/SAR/oracle agreement | `<=0.5 dB` model delta | `0.0 dB` | PASS | `csv/dynamic_sqnr_sqdr_sweep.csv`, `csv/dynamic_points/` |
| DAC | DAC DNL | `<=0.01 LSB` ideal | `2.6867397195928788e-14 LSB` | PASS | `csv/dac_transfer.csv`, `plots/dac_dnl.png` |
| Timing | Sample rate | `2 MS/s` | `2000000.0 Hz` | PASS | `csv/timing_budget.csv` |
| Functional | Direct/SAR/oracle vectors | exact code agreement | `25` summary vectors, plus exhaustive edge data | PASS | `csv/functional_vectors.csv` and related functional CSV files |
| Fault Injection | Negative controls | all injected faults detected | `13` faults | PASS | `csv/fault_injection_results.csv`, `plots/fault_injection_status.png` |
| External | ngspice smoke | must run for GO | `PASS` | PASS | `logs/ngspice_smoke.log` |
| External | cocotb smoke | must run for GO | `PASS` | PASS | `logs/cocotb_smoke.log`, `raw/cocotb_results.xml` |

The sweep-worst SQNR/SQDR rows are method-coverage stress points over small
amplitudes and phases. They are intentionally lower than the configured
`0.8823529411764706` FS baseline
and are not used as the project full-scale SNDR target condition.

## Measurement Basis

- Differential input convention: `v_diff = VINP - VINN`.
- Waveform input/output comparison convention: use `ideal_DAC(DOUT)` as the ADC output waveform, updated at internal `EOC_INT` and compared with the corresponding sampled input `x[n]`.
- Legal ideal differential range: `-1.70 V <= v_diff <= +1.70 V`.
- Full differential peak-to-peak range: `VFS_diff_pp = 3.4 V`.
- `LSB_diff = VFS_diff_pp / 2^8 = 3.4 V / 256 = 13.28125 mV`.
- Straight-binary ideal quantizer:
  `code = floor((v_diff - v_min)/LSB)`, saturated to `0..255`.
- Transition DAC:
  `V_DAC_threshold(code) = v_min + code*LSB`.
- Reconstruction DAC:
  `V_DAC_center(code) = v_min + (code + 0.5)*LSB`.
- Ideal dynamic plausibility:
  `SNR_ideal = 6.02*N + 1.76 + 20*log10(A_FS_peak)`.
- ENOB conversion:
  `ENOB = (SNDR - 1.76)/6.02`.
- DNL:
  transition width divided by ideal LSB, minus one.
- Endpoint INL:
  cumulative transition error after endpoint gain/offset anchoring.
- Coherent FFT dynamic metrics:
  fundamental, harmonic, noise, SNDR, SNR, SFDR, THD, SQNR, SQDR, and SQNDR
  are calculated from valid held output codes and independent direct/SAR/oracle
  paths.

## Results by Test Area

| Test area | Requirement mapping | Numerical data | Plots | Logs |
|---|---|---|---|---|
| Preflight and tools | `csv/preflight_tools.csv`, `csv/preflight_python_imports.csv`, `csv/required_input_files.csv` | `metrics.json` / `preflight` | none required | `logs/preflight.log`, `logs/run_all_container.log` |
| Functional and interface | `csv/coverage_matrix.csv` rows `F-*` | `csv/functional_vectors.csv`, `csv/functional_code_centers.csv`, `csv/functional_transition_boundaries.csv`, `csv/functional_overrange_saturation.csv`, `csv/functional_random_equivalence_10000.csv`, `csv/common_mode_invariance.csv`, `csv/dout_latency_stability.csv` | none required | `logs/cocotb_smoke.log` |
| Timing and bit trials | `csv/coverage_matrix.csv` rows `T-*` | `csv/timing_budget.csv`, `csv/continuous_conversion_accounting_10000.csv`, `csv/sar_bit_trial_trace.csv` | none required | `logs/cocotb_smoke.log` |
| Static ADC linearity | `csv/coverage_matrix.csv` rows `S-*` | `csv/static_transitions.csv`, `csv/static_dnl.csv`, `csv/static_inl.csv`, `raw/quantization_error_lsb.csv` | `plots/transfer_curve.png`, `plots/transition_error.png`, `plots/dnl.png`, `plots/inl_endpoint_bestfit.png`, `plots/quantization_error_histogram.png` | none required |
| Histogram methods | `csv/coverage_matrix.csv` rows `HIST-*` | `csv/histogram_counts.csv`, `csv/histogram_linearity_comparison.csv` | `plots/ramp_histogram.png`, `plots/sine_histogram.png` | none required |
| Dynamic ADC metrics | `csv/coverage_matrix.csv` rows `DYN-*` | `csv/dynamic_metrics.csv`, `csv/dynamic_sqnr_sqdr_sweep.csv`, `csv/dynamic_power_partition.csv`, `csv/adc_input_output_time_*.csv`, `csv/adc_output_spectrum_*.csv`, `csv/dynamic_points/*.csv`, `raw/dynamic_low_frequency_codes.csv`, `raw/dynamic_near_nyquist_codes.csv` | `plots/adc_input_output_time_*.png`, `plots/adc_output_code_time_*.png`, `plots/adc_fft_*.png`, `plots/adc_output_spectrum_*.png`, `plots/adc_*.png`, `plots/spectrum_low_frequency.png`, `plots/spectrum_near_nyquist.png`, `plots/sqnr_sqdr_vs_amplitude.png`, `plots/sndr_enob_vs_frequency.png` | none required |
| DAC/CDAC ideal behavior | `csv/coverage_matrix.csv` rows `DAC-*` | `csv/dac_transfer.csv`, `csv/dac_bit_weights.csv`, `csv/dac_settling_glitch.csv`, `csv/sar_dac_trial_trajectory.csv`, `csv/adc_dac_reconstruction_low_frequency.csv` | `plots/dac_*.png`, `plots/sar_dac_trial_trajectory.png`, `plots/adc_dac_reconstruction_low_frequency.png` | `logs/ngspice_smoke.log` |
| Power measurement chain | `csv/coverage_matrix.csv` row `POWER-01` | `csv/power_harness_selftest.csv`, `raw/power_proxy_waveform.csv` | `plots/power_harness_current.png` | `logs/power_proxy_ngspice.log` |
| Fault injection | `csv/coverage_matrix.csv` row `FI-01` | `csv/fault_injection_results.csv` | `plots/fault_injection_status.png` | none required |
| Repeatability | `csv/coverage_matrix.csv` row `REPEAT-01` | `csv/repeatability_check.csv` | none required | `logs/run_all_container.log` |

## Required Schema Check

`csv/metrics.csv` contains the required columns:

```text
category, metric, variant, condition, project_target, ideal_expected, measured,
unit, tolerance, status, method, model_path, raw_data_path, plot_path, tool,
notes
```

It also contains two local helper columns. They are redundant with existing
required fields and make Markdown summary generation simpler.

## Reproduction Commands

From repository root:

```powershell
python verification\ideal_sar\scripts\run_all.py all
```

Authoritative Chipathon container run:

```powershell
docker run --rm -v "D:/PICO/simple_SAR_ADC_repo:/work" -w /work hpretl/iic-osic-tools:chipathon26 --skip bash -lc "python3 verification/ideal_sar/scripts/run_all.py all; code=$?; echo EXIT_CODE=$code; exit $code"
```

Report-only refresh after documentation updates:

```powershell
python verification\ideal_sar\scripts\run_all.py report
```

## Reviewer Checklist

- Open `logs/run_all_container.log` and confirm `go_no_go: GO` plus
  `EXIT_CODE=0`.
- Open `csv/coverage_matrix.csv` and confirm every row is `PASS`.
- Open `csv/metrics.csv` and confirm every summary metric has a data path and
  status.
- Spot-check at least one static plot, one dynamic plot, one DAC plot, and one
  fault-injection plot against the corresponding CSV.
