tritone4801/chipathon-2026-A44-SAR-ADC/verification/ideal_sar/spice/optional_xschem_views/README.md

# Optional Xschem Views

No Xschem schematic is required for the ideal baseline. This placeholder keeps
the expected directory shape and records that schematic capture is deferred to
the GF180 circuit-level phase.
