tritone4801/chipathon-2026-A44-SAR-ADC/verification/a44_cdac_cap_x1div3/03_RESULTS/acquisition/attempt20/RESULT_CN.md

# attempt20 current LAYOUT acquisition time

- 0.25 LSB acquisition time (GEN plane): `151.934940 ns` (FS_UP).
- PAD plane: `147.009855 ns`; TG plane: `134.548395 ns`.
- GEN-plane sensitivity: 0.5 LSB `136.088515 ns`; 0.1 LSB `172.981330 ns`.
- Versus prior R8/M6 layout `151.832300 ns`: `+0.102640 ns`.
- Versus fixed schematic `134.342218 ns`: `+17.592722 ns`.
- Maxstep check: `COMPLETE`.

Method: fixed A44_SCHEM_ACQ_ESD_LUMPED_RC_GEN50_R1 input model, TT/3.3 V/27 C, bidirectional full-scale long-track step, linear enter-and-remain differential error, GEN as the formal reference plane.

No SHA256 manifest or formal audit was produced.
