tritone4801/chipathon-2026-A44-SAR-ADC/verification/a44_r2/02_SIMULATION_RESULTS/01_MC200_TT_LOW_W4/source_snapshot/prior_model_audits/noise_calibration.md

# Noise Calibration

- Overall Phase G status: `FAIL`
- Comparator calibration: `PASS`
- Sample/CDAC calibration: `PASS`
- Top selected-transition probability: `FAIL`
- Top probability adaptive sampling: `128 conversions/point for every CI-inadequate case`
- Native MOS transient-noise claim: `NO`
