tritone4801/chipathon-2026-A44-SAR-ADC/verification/a44_r2/02_SIMULATION_RESULTS/01_MC200_TT_LOW_W4/source_snapshot/prior_model_audits/solver_profile_equivalence.md

# Solver Profile Equivalence

- Status: `PASS`
- Frames: `64`
- Code mismatches: `0`
- Maximum sampled-input delta: `0.000752941176 LSB`
- Maximum completion-time delta: `30 ps`
- Compared profiles: `DEFAULT 100 ps` versus `ROBUST_GEAR 50 ps`
- Electrical stimulus, mismatch seed, noise seed, event draws, and phase are identical.
