tritone4801/chipathon-2026-A44-SAR-ADC/verification/a44_r2/05_PACKAGE_AUDIT/SOURCE_COPY_AUDIT.csv

package_relative_path | r1_path | r2_path | r1_size_bytes | r2_size_bytes | r1_sha256 | r2_sha256 | status
01_CURRENT_CIRCUIT_FILES/.complete | D:\PICO\A44_SAR_ADC_CURRENT_CACE_REPRODUCIBLE_20260728_R1\00_CURRENT_CIRCUIT_FILES\.complete | D:\PICO\A44_SAR_ADC_CURRENT_CACE_REPRODUCIBLE_20260728_R2\01_CURRENT_CIRCUIT_FILES\.complete | 240 | 240 | c1cd09d2f70f27dc798addd1cd246fd4423c180aa771814d4be4ff156af49e4b | c1cd09d2f70f27dc798addd1cd246fd4423c180aa771814d4be4ff156af49e4b | EXACT_COPY
01_CURRENT_CIRCUIT_FILES/README_CN.md | D:\PICO\A44_SAR_ADC_CURRENT_CACE_REPRODUCIBLE_20260728_R1\00_CURRENT_CIRCUIT_FILES\README_CN.md | D:\PICO\A44_SAR_ADC_CURRENT_CACE_REPRODUCIBLE_20260728_R2\01_CURRENT_CIRCUIT_FILES\README_CN.md | 2615 | 2615 | b2cad58f3de03c70463b9dd3a00ea79079f19f58bc921a7941648b20e3d7a515 | b2cad58f3de03c70463b9dd3a00ea79079f19f58bc921a7941648b20e3d7a515 | EXACT_COPY
01_CURRENT_CIRCUIT_FILES/STATUS.json | D:\PICO\A44_SAR_ADC_CURRENT_CACE_REPRODUCIBLE_20260728_R1\00_CURRENT_CIRCUIT_FILES\STATUS.json | D:\PICO\A44_SAR_ADC_CURRENT_CACE_REPRODUCIBLE_20260728_R2\01_CURRENT_CIRCUIT_FILES\STATUS.json | 537 | 537 | f381a875495ac6f1b8d30660c4cb6a35da9b0bb504249695e281a727c698801b | f381a875495ac6f1b8d30660c4cb6a35da9b0bb504249695e281a727c698801b | EXACT_COPY
01_CURRENT_CIRCUIT_FILES/audits/CURRENT_HIERARCHY_AUDIT.json | D:\PICO\A44_SAR_ADC_CURRENT_CACE_REPRODUCIBLE_20260728_R1\00_CURRENT_CIRCUIT_FILES\audits\CURRENT_HIERARCHY_AUDIT.json | D:\PICO\A44_SAR_ADC_CURRENT_CACE_REPRODUCIBLE_20260728_R2\01_CURRENT_CIRCUIT_FILES\audits\CURRENT_HIERARCHY_AUDIT.json | 2987 | 2987 | 2a60f1e4e1f823aa61b2cb6c7d6ec8456a17641fd5f2ac372255df30a92d58bc | 2a60f1e4e1f823aa61b2cb6c7d6ec8456a17641fd5f2ac372255df30a92d58bc | EXACT_COPY
01_CURRENT_CIRCUIT_FILES/indexes/CURRENT_FILE_INDEX.csv | D:\PICO\A44_SAR_ADC_CURRENT_CACE_REPRODUCIBLE_20260728_R1\00_CURRENT_CIRCUIT_FILES\indexes\CURRENT_FILE_INDEX.csv | D:\PICO\A44_SAR_ADC_CURRENT_CACE_REPRODUCIBLE_20260728_R2\01_CURRENT_CIRCUIT_FILES\indexes\CURRENT_FILE_INDEX.csv | 5896 | 5896 | 77f3fa5e0e5efdcf1c0f8b6bed9ef8eec010664885cc4ead75937092d4e888ae | 77f3fa5e0e5efdcf1c0f8b6bed9ef8eec010664885cc4ead75937092d4e888ae | EXACT_COPY
01_CURRENT_CIRCUIT_FILES/manifests/manifest_audit.json | D:\PICO\A44_SAR_ADC_CURRENT_CACE_REPRODUCIBLE_20260728_R1\00_CURRENT_CIRCUIT_FILES\manifests\manifest_audit.json | D:\PICO\A44_SAR_ADC_CURRENT_CACE_REPRODUCIBLE_20260728_R2\01_CURRENT_CIRCUIT_FILES\manifests\manifest_audit.json | 470 | 470 | c4be9d87f9702b695fb5f19a41eb000055f139fe3f5d95a5a9faa443a25dceae | c4be9d87f9702b695fb5f19a41eb000055f139fe3f5d95a5a9faa443a25dceae | EXACT_COPY
01_CURRENT_CIRCUIT_FILES/manifests/package_manifest_sha256.csv | D:\PICO\A44_SAR_ADC_CURRENT_CACE_REPRODUCIBLE_20260728_R1\00_CURRENT_CIRCUIT_FILES\manifests\package_manifest_sha256.csv | D:\PICO\A44_SAR_ADC_CURRENT_CACE_REPRODUCIBLE_20260728_R2\01_CURRENT_CIRCUIT_FILES\manifests\package_manifest_sha256.csv | 2374 | 2374 | 534542afca9931f86c1d78efd552a597fa0174e5448bd84a66c6253b2905b83b | 534542afca9931f86c1d78efd552a597fa0174e5448bd84a66c6253b2905b83b | EXACT_COPY
01_CURRENT_CIRCUIT_FILES/rtl/sar_logic_async_core_RTL.sv | D:\PICO\A44_SAR_ADC_CURRENT_CACE_REPRODUCIBLE_20260728_R1\00_CURRENT_CIRCUIT_FILES\rtl\sar_logic_async_core_RTL.sv | D:\PICO\A44_SAR_ADC_CURRENT_CACE_REPRODUCIBLE_20260728_R2\01_CURRENT_CIRCUIT_FILES\rtl\sar_logic_async_core_RTL.sv | 7383 | 7383 | be43ce73959afb150e9987401eccf6aecb38c8e29d4ad5b780525b6b5e90afb9 | be43ce73959afb150e9987401eccf6aecb38c8e29d4ad5b780525b6b5e90afb9 | EXACT_COPY
01_CURRENT_CIRCUIT_FILES/spice/SAR_ADC_TOP_FIXED.spice | D:\PICO\A44_SAR_ADC_CURRENT_CACE_REPRODUCIBLE_20260728_R1\00_CURRENT_CIRCUIT_FILES\spice\SAR_ADC_TOP_FIXED.spice | D:\PICO\A44_SAR_ADC_CURRENT_CACE_REPRODUCIBLE_20260728_R2\01_CURRENT_CIRCUIT_FILES\spice\SAR_ADC_TOP_FIXED.spice | 876 | 876 | 275faef84fe26cd85b6ecb62bd0a7c1db050f186b07fb109dc650d82e52843cd | 275faef84fe26cd85b6ecb62bd0a7c1db050f186b07fb109dc650d82e52843cd | EXACT_COPY
01_CURRENT_CIRCUIT_FILES/spice/subckts/CDAC_native_extracted.subckt.spice | D:\PICO\A44_SAR_ADC_CURRENT_CACE_REPRODUCIBLE_20260728_R1\00_CURRENT_CIRCUIT_FILES\spice\subckts\CDAC_native_extracted.subckt.spice | D:\PICO\A44_SAR_ADC_CURRENT_CACE_REPRODUCIBLE_20260728_R2\01_CURRENT_CIRCUIT_FILES\spice\subckts\CDAC_native_extracted.subckt.spice | 4365 | 4365 | 6e98da540b1c765b0dcec4d1e10399142dc37b7f1c21960d289a83f07ec10ada | 6e98da540b1c765b0dcec4d1e10399142dc37b7f1c21960d289a83f07ec10ada | EXACT_COPY
01_CURRENT_CIRCUIT_FILES/spice/subckts/Comparator_StrongARM_extracted.subckt.spice | D:\PICO\A44_SAR_ADC_CURRENT_CACE_REPRODUCIBLE_20260728_R1\00_CURRENT_CIRCUIT_FILES\spice\subckts\Comparator_StrongARM_extracted.subckt.spice | D:\PICO\A44_SAR_ADC_CURRENT_CACE_REPRODUCIBLE_20260728_R2\01_CURRENT_CIRCUIT_FILES\spice\subckts\Comparator_StrongARM_extracted.subckt.spice | 3906 | 3906 | 53f26155df31b8d1f50dd1bc99a17a6530de29233c11faabe63906debd1b5b49 | 53f26155df31b8d1f50dd1bc99a17a6530de29233c11faabe63906debd1b5b49 | EXACT_COPY
01_CURRENT_CIRCUIT_FILES/spice/subckts/SAR_LOGIC_ACTUAL_RTL_SS_pex_core.spice | D:\PICO\A44_SAR_ADC_CURRENT_CACE_REPRODUCIBLE_20260728_R1\00_CURRENT_CIRCUIT_FILES\spice\subckts\SAR_LOGIC_ACTUAL_RTL_SS_pex_core.spice | D:\PICO\A44_SAR_ADC_CURRENT_CACE_REPRODUCIBLE_20260728_R2\01_CURRENT_CIRCUIT_FILES\spice\subckts\SAR_LOGIC_ACTUAL_RTL_SS_pex_core.spice | 5039633 | 5039633 | 0569bde6a86cf8a8e7de1225e427e010672e1b09912f06590ea20275ce8ac7a6 | 0569bde6a86cf8a8e7de1225e427e010672e1b09912f06590ea20275ce8ac7a6 | EXACT_COPY
01_CURRENT_CIRCUIT_FILES/spice/subckts/SAR_LOGIC_ACTUAL_RTL_SS_pex_wrapper_local.spice | D:\PICO\A44_SAR_ADC_CURRENT_CACE_REPRODUCIBLE_20260728_R1\00_CURRENT_CIRCUIT_FILES\spice\subckts\SAR_LOGIC_ACTUAL_RTL_SS_pex_wrapper_local.spice | D:\PICO\A44_SAR_ADC_CURRENT_CACE_REPRODUCIBLE_20260728_R2\01_CURRENT_CIRCUIT_FILES\spice\subckts\SAR_LOGIC_ACTUAL_RTL_SS_pex_wrapper_local.spice | 973 | 973 | ad43f6f9e813ae737c6dcfcd265b39ef34a592ea10982df3fbdad83fb1c56746 | ad43f6f9e813ae737c6dcfcd265b39ef34a592ea10982df3fbdad83fb1c56746 | EXACT_COPY
01_CURRENT_CIRCUIT_FILES/spice/subckts/SWITCH_BOOT_SP_native_extracted.subckt.spice | D:\PICO\A44_SAR_ADC_CURRENT_CACE_REPRODUCIBLE_20260728_R1\00_CURRENT_CIRCUIT_FILES\spice\subckts\SWITCH_BOOT_SP_native_extracted.subckt.spice | D:\PICO\A44_SAR_ADC_CURRENT_CACE_REPRODUCIBLE_20260728_R2\01_CURRENT_CIRCUIT_FILES\spice\subckts\SWITCH_BOOT_SP_native_extracted.subckt.spice | 3195 | 3195 | 3ef9735c56374250575394bbc2dbbf4e33ad4cc4c02af0055205160908e0daf1 | 3ef9735c56374250575394bbc2dbbf4e33ad4cc4c02af0055205160908e0daf1 | EXACT_COPY
01_CURRENT_CIRCUIT_FILES/xschem/A44_CDAC.sym | D:\PICO\A44_SAR_ADC_CURRENT_CACE_REPRODUCIBLE_20260728_R1\00_CURRENT_CIRCUIT_FILES\xschem\A44_CDAC.sym | D:\PICO\A44_SAR_ADC_CURRENT_CACE_REPRODUCIBLE_20260728_R2\01_CURRENT_CIRCUIT_FILES\xschem\A44_CDAC.sym | 1163 | 1163 | 298fa32b7a04b60cae50f3999fcd2b01cc8dfd442b5031e108bb26b268793610 | 298fa32b7a04b60cae50f3999fcd2b01cc8dfd442b5031e108bb26b268793610 | EXACT_COPY
01_CURRENT_CIRCUIT_FILES/xschem/A44_Comparator_StrongARM.sym | D:\PICO\A44_SAR_ADC_CURRENT_CACE_REPRODUCIBLE_20260728_R1\00_CURRENT_CIRCUIT_FILES\xschem\A44_Comparator_StrongARM.sym | D:\PICO\A44_SAR_ADC_CURRENT_CACE_REPRODUCIBLE_20260728_R2\01_CURRENT_CIRCUIT_FILES\xschem\A44_Comparator_StrongARM.sym | 1278 | 1278 | 36ea29c9789f2221cf798bb270ebaea509ba9249c717107de825a549e64975a7 | 36ea29c9789f2221cf798bb270ebaea509ba9249c717107de825a549e64975a7 | EXACT_COPY
01_CURRENT_CIRCUIT_FILES/xschem/A44_SAR_ADC_TOP_FIXED.sym | D:\PICO\A44_SAR_ADC_CURRENT_CACE_REPRODUCIBLE_20260728_R1\00_CURRENT_CIRCUIT_FILES\xschem\A44_SAR_ADC_TOP_FIXED.sym | D:\PICO\A44_SAR_ADC_CURRENT_CACE_REPRODUCIBLE_20260728_R2\01_CURRENT_CIRCUIT_FILES\xschem\A44_SAR_ADC_TOP_FIXED.sym | 1390 | 1390 | 0df74804ce8f8072022dd2c7b9faec716ba4241a2f7812e1e1eb75294c031658 | 0df74804ce8f8072022dd2c7b9faec716ba4241a2f7812e1e1eb75294c031658 | EXACT_COPY
01_CURRENT_CIRCUIT_FILES/xschem/A44_SAR_LOGIC_ACTUAL_RTL_REPAIR.sym | D:\PICO\A44_SAR_ADC_CURRENT_CACE_REPRODUCIBLE_20260728_R1\00_CURRENT_CIRCUIT_FILES\xschem\A44_SAR_LOGIC_ACTUAL_RTL_REPAIR.sym | D:\PICO\A44_SAR_ADC_CURRENT_CACE_REPRODUCIBLE_20260728_R2\01_CURRENT_CIRCUIT_FILES\xschem\A44_SAR_LOGIC_ACTUAL_RTL_REPAIR.sym | 1620 | 1620 | bac415a04de0840d1b2a5dd7ee9276a46155b93f48daeda26061a41c000f081a | bac415a04de0840d1b2a5dd7ee9276a46155b93f48daeda26061a41c000f081a | EXACT_COPY
01_CURRENT_CIRCUIT_FILES/xschem/A44_SWITCH_BOOT_SP.sym | D:\PICO\A44_SAR_ADC_CURRENT_CACE_REPRODUCIBLE_20260728_R1\00_CURRENT_CIRCUIT_FILES\xschem\A44_SWITCH_BOOT_SP.sym | D:\PICO\A44_SAR_ADC_CURRENT_CACE_REPRODUCIBLE_20260728_R2\01_CURRENT_CIRCUIT_FILES\xschem\A44_SWITCH_BOOT_SP.sym | 879 | 879 | efb864a4d610f61630507d1c76896422c76e0a7ef0d142847ae7f1a0eb105e8a | efb864a4d610f61630507d1c76896422c76e0a7ef0d142847ae7f1a0eb105e8a | EXACT_COPY
01_CURRENT_CIRCUIT_FILES/xschem/CDAC.sch | D:\PICO\A44_SAR_ADC_CURRENT_CACE_REPRODUCIBLE_20260728_R1\00_CURRENT_CIRCUIT_FILES\xschem\CDAC.sch | D:\PICO\A44_SAR_ADC_CURRENT_CACE_REPRODUCIBLE_20260728_R2\01_CURRENT_CIRCUIT_FILES\xschem\CDAC.sch | 12170 | 12170 | 1a6e64de5aac177fead165d0909c0ac6bd5bec25921db54894a21b91a3b01de6 | 1a6e64de5aac177fead165d0909c0ac6bd5bec25921db54894a21b91a3b01de6 | EXACT_COPY
01_CURRENT_CIRCUIT_FILES/xschem/Comparator_StrongARM.sch | D:\PICO\A44_SAR_ADC_CURRENT_CACE_REPRODUCIBLE_20260728_R1\00_CURRENT_CIRCUIT_FILES\xschem\Comparator_StrongARM.sch | D:\PICO\A44_SAR_ADC_CURRENT_CACE_REPRODUCIBLE_20260728_R2\01_CURRENT_CIRCUIT_FILES\xschem\Comparator_StrongARM.sch | 9342 | 9342 | 20e713782714df7d063eef39b79e82f492775cf2fc71beb8895e871b7deeec5a | 20e713782714df7d063eef39b79e82f492775cf2fc71beb8895e871b7deeec5a | EXACT_COPY
01_CURRENT_CIRCUIT_FILES/xschem/SAR_ADC_TOP_FIXED.sch | D:\PICO\A44_SAR_ADC_CURRENT_CACE_REPRODUCIBLE_20260728_R1\00_CURRENT_CIRCUIT_FILES\xschem\SAR_ADC_TOP_FIXED.sch | D:\PICO\A44_SAR_ADC_CURRENT_CACE_REPRODUCIBLE_20260728_R2\01_CURRENT_CIRCUIT_FILES\xschem\SAR_ADC_TOP_FIXED.sch | 3752 | 3752 | 04f8ffe6b0624cf8dbec3405f0cde5bbebc3000304c467cd46179fd5f8addc71 | 04f8ffe6b0624cf8dbec3405f0cde5bbebc3000304c467cd46179fd5f8addc71 | EXACT_COPY
01_CURRENT_CIRCUIT_FILES/xschem/SWITCH_BOOT_SP.sch | D:\PICO\A44_SAR_ADC_CURRENT_CACE_REPRODUCIBLE_20260728_R1\00_CURRENT_CIRCUIT_FILES\xschem\SWITCH_BOOT_SP.sch | D:\PICO\A44_SAR_ADC_CURRENT_CACE_REPRODUCIBLE_20260728_R2\01_CURRENT_CIRCUIT_FILES\xschem\SWITCH_BOOT_SP.sch | 7925 | 7925 | 4049b886e976ed1e8b0afd8c5b8a349a7c287cd335a4ffe6cb064897fd7227fd | 4049b886e976ed1e8b0afd8c5b8a349a7c287cd335a4ffe6cb064897fd7227fd | EXACT_COPY
01_CURRENT_CIRCUIT_FILES/xschem/xschemrc | D:\PICO\A44_SAR_ADC_CURRENT_CACE_REPRODUCIBLE_20260728_R1\00_CURRENT_CIRCUIT_FILES\xschem\xschemrc | D:\PICO\A44_SAR_ADC_CURRENT_CACE_REPRODUCIBLE_20260728_R2\01_CURRENT_CIRCUIT_FILES\xschem\xschemrc | 160 | 160 | 52296681d15582a28f27b54643f5258c8cb9967818cd4abe1d99be16091aecba | 52296681d15582a28f27b54643f5258c8cb9967818cd4abe1d99be16091aecba | EXACT_COPY
02_SIMULATION_RESULTS/01_MC200_TT_LOW_W4/config/cdac_mismatch_model.yaml | D:\PICO\A44_SAR_ADC_CURRENT_CACE_REPRODUCIBLE_20260728_R1\01_MC200_TT_LOW_W4\config\cdac_mismatch_model.yaml | D:\PICO\A44_SAR_ADC_CURRENT_CACE_REPRODUCIBLE_20260728_R2\02_SIMULATION_RESULTS\01_MC200_TT_LOW_W4\config\cdac_mismatch_model.yaml | 2700 | 2700 | 6e15822f9689ea72feb9bbe86b9146dec7ddbe282d37503a5eeb42f81a75e968 | 6e15822f9689ea72feb9bbe86b9146dec7ddbe282d37503a5eeb42f81a75e968 | EXACT_COPY
02_SIMULATION_RESULTS/01_MC200_TT_LOW_W4/config/current_mc200_contract.json | D:\PICO\A44_SAR_ADC_CURRENT_CACE_REPRODUCIBLE_20260728_R1\01_MC200_TT_LOW_W4\config\current_mc200_contract.json | D:\PICO\A44_SAR_ADC_CURRENT_CACE_REPRODUCIBLE_20260728_R2\02_SIMULATION_RESULTS\01_MC200_TT_LOW_W4\config\current_mc200_contract.json | 1342 | 1342 | 87af10dd3788c5fdc99929540458fff9ca7ba8f90de84e912426c0e24beb4e2e | 87af10dd3788c5fdc99929540458fff9ca7ba8f90de84e912426c0e24beb4e2e | EXACT_COPY
02_SIMULATION_RESULTS/01_MC200_TT_LOW_W4/config/environment_fingerprint.json | D:\PICO\A44_SAR_ADC_CURRENT_CACE_REPRODUCIBLE_20260728_R1\01_MC200_TT_LOW_W4\config\environment_fingerprint.json | D:\PICO\A44_SAR_ADC_CURRENT_CACE_REPRODUCIBLE_20260728_R2\02_SIMULATION_RESULTS\01_MC200_TT_LOW_W4\config\environment_fingerprint.json | 1262 | 1262 | a642893359807a3b20b044ceb583178b92f73467979130270194a549c5ce4872 | a642893359807a3b20b044ceb583178b92f73467979130270194a549c5ce4872 | EXACT_COPY
02_SIMULATION_RESULTS/01_MC200_TT_LOW_W4/config/fast64_v2_contract.json | D:\PICO\A44_SAR_ADC_CURRENT_CACE_REPRODUCIBLE_20260728_R1\01_MC200_TT_LOW_W4\config\fast64_v2_contract.json | D:\PICO\A44_SAR_ADC_CURRENT_CACE_REPRODUCIBLE_20260728_R2\02_SIMULATION_RESULTS\01_MC200_TT_LOW_W4\config\fast64_v2_contract.json | 2381 | 2381 | a6b092e268deee02de5c1627a2de35aba03909418bdbc9a000c54a1746ff2f46 | a6b092e268deee02de5c1627a2de35aba03909418bdbc9a000c54a1746ff2f46 | EXACT_COPY
02_SIMULATION_RESULTS/01_MC200_TT_LOW_W4/config/frozen_dynamic_config.yaml | D:\PICO\A44_SAR_ADC_CURRENT_CACE_REPRODUCIBLE_20260728_R1\01_MC200_TT_LOW_W4\config\frozen_dynamic_config.yaml | D:\PICO\A44_SAR_ADC_CURRENT_CACE_REPRODUCIBLE_20260728_R2\02_SIMULATION_RESULTS\01_MC200_TT_LOW_W4\config\frozen_dynamic_config.yaml | 2348 | 2348 | 2b7efb9bed89d0aed87472185a96eb1bfd8172273be22cee89594815e6fdc007 | 2b7efb9bed89d0aed87472185a96eb1bfd8172273be22cee89594815e6fdc007 | EXACT_COPY
02_SIMULATION_RESULTS/01_MC200_TT_LOW_W4/config/mc200_low_w4_contract.json | D:\PICO\A44_SAR_ADC_CURRENT_CACE_REPRODUCIBLE_20260728_R1\01_MC200_TT_LOW_W4\config\mc200_low_w4_contract.json | D:\PICO\A44_SAR_ADC_CURRENT_CACE_REPRODUCIBLE_20260728_R2\02_SIMULATION_RESULTS\01_MC200_TT_LOW_W4\config\mc200_low_w4_contract.json | 8767 | 8767 | ac23afe991f3da98959e9fcb459fd905065e22e382485ca4d702644092117fcd | ac23afe991f3da98959e9fcb459fd905065e22e382485ca4d702644092117fcd | EXACT_COPY
02_SIMULATION_RESULTS/01_MC200_TT_LOW_W4/config/mc200_low_w4_plot_resolved_ranges.json | D:\PICO\A44_SAR_ADC_CURRENT_CACE_REPRODUCIBLE_20260728_R1\01_MC200_TT_LOW_W4\config\mc200_low_w4_plot_resolved_ranges.json | D:\PICO\A44_SAR_ADC_CURRENT_CACE_REPRODUCIBLE_20260728_R2\02_SIMULATION_RESULTS\01_MC200_TT_LOW_W4\config\mc200_low_w4_plot_resolved_ranges.json | 507 | 507 | 1fe556596d60ac74112481ab9616830e54626213a20ebe335d3c459add18136d | 1fe556596d60ac74112481ab9616830e54626213a20ebe335d3c459add18136d | EXACT_COPY
02_SIMULATION_RESULTS/01_MC200_TT_LOW_W4/config/mc_seeds.csv | D:\PICO\A44_SAR_ADC_CURRENT_CACE_REPRODUCIBLE_20260728_R1\01_MC200_TT_LOW_W4\config\mc_seeds.csv | D:\PICO\A44_SAR_ADC_CURRENT_CACE_REPRODUCIBLE_20260728_R2\02_SIMULATION_RESULTS\01_MC200_TT_LOW_W4\config\mc_seeds.csv | 5812 | 5812 | 6f2a0f43608ca4198a2d20dba34d1a239a7c9e3cf6ed80fc9a864aa5d4e9543d | 6f2a0f43608ca4198a2d20dba34d1a239a7c9e3cf6ed80fc9a864aa5d4e9543d | EXACT_COPY
02_SIMULATION_RESULTS/01_MC200_TT_LOW_W4/config/ngspice_userinit/.spiceinit | D:\PICO\A44_SAR_ADC_CURRENT_CACE_REPRODUCIBLE_20260728_R1\01_MC200_TT_LOW_W4\config\ngspice_userinit\.spiceinit | D:\PICO\A44_SAR_ADC_CURRENT_CACE_REPRODUCIBLE_20260728_R2\02_SIMULATION_RESULTS\01_MC200_TT_LOW_W4\config\ngspice_userinit\.spiceinit | 154 | 154 | e4fedb09e98dc2f3df539fe215df79f4977d8fb3f7bcdd61c606d8bb90da1325 | e4fedb09e98dc2f3df539fe215df79f4977d8fb3f7bcdd61c606d8bb90da1325 | EXACT_COPY
02_SIMULATION_RESULTS/01_MC200_TT_LOW_W4/config/noise_model.yaml | D:\PICO\A44_SAR_ADC_CURRENT_CACE_REPRODUCIBLE_20260728_R1\01_MC200_TT_LOW_W4\config\noise_model.yaml | D:\PICO\A44_SAR_ADC_CURRENT_CACE_REPRODUCIBLE_20260728_R2\02_SIMULATION_RESULTS\01_MC200_TT_LOW_W4\config\noise_model.yaml | 2679 | 2679 | 5e96592de86c239db9334c98f5c5d4d4c6b000eece41673de3c58ab148897f6e | 5e96592de86c239db9334c98f5c5d4d4c6b000eece41673de3c58ab148897f6e | EXACT_COPY
02_SIMULATION_RESULTS/01_MC200_TT_LOW_W4/config/noise_seeds.csv | D:\PICO\A44_SAR_ADC_CURRENT_CACE_REPRODUCIBLE_20260728_R1\01_MC200_TT_LOW_W4\config\noise_seeds.csv | D:\PICO\A44_SAR_ADC_CURRENT_CACE_REPRODUCIBLE_20260728_R2\02_SIMULATION_RESULTS\01_MC200_TT_LOW_W4\config\noise_seeds.csv | 6515 | 6515 | bf1af85899e04ff8f19016ac8d8d7f86f0fd1781bcf3feb4245b1d27f42b0112 | bf1af85899e04ff8f19016ac8d8d7f86f0fd1781bcf3feb4245b1d27f42b0112 | EXACT_COPY
02_SIMULATION_RESULTS/01_MC200_TT_LOW_W4/config/plot_contract.json | D:\PICO\A44_SAR_ADC_CURRENT_CACE_REPRODUCIBLE_20260728_R1\01_MC200_TT_LOW_W4\config\plot_contract.json | D:\PICO\A44_SAR_ADC_CURRENT_CACE_REPRODUCIBLE_20260728_R2\02_SIMULATION_RESULTS\01_MC200_TT_LOW_W4\config\plot_contract.json | 2798 | 2798 | 404c6c93d79a903aca609fd6f5fd873c73cb3a2150b240f5763d61a1684c98e7 | 404c6c93d79a903aca609fd6f5fd873c73cb3a2150b240f5763d61a1684c98e7 | EXACT_COPY
02_SIMULATION_RESULTS/01_MC200_TT_LOW_W4/config/plot_style.yaml | D:\PICO\A44_SAR_ADC_CURRENT_CACE_REPRODUCIBLE_20260728_R1\01_MC200_TT_LOW_W4\config\plot_style.yaml | D:\PICO\A44_SAR_ADC_CURRENT_CACE_REPRODUCIBLE_20260728_R2\02_SIMULATION_RESULTS\01_MC200_TT_LOW_W4\config\plot_style.yaml | 216 | 216 | 6ad9e1aa57f508075547673cbee45c9af9c2d86742f804e8045631cffa7ff676 | 6ad9e1aa57f508075547673cbee45c9af9c2d86742f804e8045631cffa7ff676 | EXACT_COPY
02_SIMULATION_RESULTS/01_MC200_TT_LOW_W4/config/source_load_model.yaml | D:\PICO\A44_SAR_ADC_CURRENT_CACE_REPRODUCIBLE_20260728_R1\01_MC200_TT_LOW_W4\config\source_load_model.yaml | D:\PICO\A44_SAR_ADC_CURRENT_CACE_REPRODUCIBLE_20260728_R2\02_SIMULATION_RESULTS\01_MC200_TT_LOW_W4\config\source_load_model.yaml | 1012 | 1012 | c0609a942035182d8978082ff0e67285fafcf9126b04dd712ba67f8ab14da2a5 | c0609a942035182d8978082ff0e67285fafcf9126b04dd712ba67f8ab14da2a5 | EXACT_COPY
02_SIMULATION_RESULTS/01_MC200_TT_LOW_W4/config/timing_tt_3p3_27c.json | D:\PICO\A44_SAR_ADC_CURRENT_CACE_REPRODUCIBLE_20260728_R1\01_MC200_TT_LOW_W4\config\timing_tt_3p3_27c.json | D:\PICO\A44_SAR_ADC_CURRENT_CACE_REPRODUCIBLE_20260728_R2\02_SIMULATION_RESULTS\01_MC200_TT_LOW_W4\config\timing_tt_3p3_27c.json | 1664 | 1664 | b47114c90c2ea957e3f5f80eaeb2dd04e344646d29d49eb5fb8811273790ebee | b47114c90c2ea957e3f5f80eaeb2dd04e344646d29d49eb5fb8811273790ebee | EXACT_COPY
02_SIMULATION_RESULTS/01_MC200_TT_LOW_W4/csv/cdac_mismatch_weights.csv | D:\PICO\A44_SAR_ADC_CURRENT_CACE_REPRODUCIBLE_20260728_R1\01_MC200_TT_LOW_W4\csv\cdac_mismatch_weights.csv | D:\PICO\A44_SAR_ADC_CURRENT_CACE_REPRODUCIBLE_20260728_R2\02_SIMULATION_RESULTS\01_MC200_TT_LOW_W4\csv\cdac_mismatch_weights.csv | 549745 | 549745 | db6195e8cf650819603c0aba6e7d08d6bb03830e512a598fbe05699bfa36b824 | db6195e8cf650819603c0aba6e7d08d6bb03830e512a598fbe05699bfa36b824 | EXACT_COPY
02_SIMULATION_RESULTS/01_MC200_TT_LOW_W4/csv/codes_all_13600.csv | D:\PICO\A44_SAR_ADC_CURRENT_CACE_REPRODUCIBLE_20260728_R1\01_MC200_TT_LOW_W4\csv\codes_all_13600.csv | D:\PICO\A44_SAR_ADC_CURRENT_CACE_REPRODUCIBLE_20260728_R2\02_SIMULATION_RESULTS\01_MC200_TT_LOW_W4\csv\codes_all_13600.csv | 4800985 | 4800985 | d98c00ade9e955ca7861ed9f409c82e5069620885446426c6ebc20943769e11d | d98c00ade9e955ca7861ed9f409c82e5069620885446426c6ebc20943769e11d | EXACT_COPY
02_SIMULATION_RESULTS/01_MC200_TT_LOW_W4/csv/codes_fft_retained_12800.csv | D:\PICO\A44_SAR_ADC_CURRENT_CACE_REPRODUCIBLE_20260728_R1\01_MC200_TT_LOW_W4\csv\codes_fft_retained_12800.csv | D:\PICO\A44_SAR_ADC_CURRENT_CACE_REPRODUCIBLE_20260728_R2\02_SIMULATION_RESULTS\01_MC200_TT_LOW_W4\csv\codes_fft_retained_12800.csv | 4522932 | 4522932 | 73e7fc9fe837a807ae020fb3fce77ba03edd81c19bc1de2c823a1486593f2d00 | 73e7fc9fe837a807ae020fb3fce77ba03edd81c19bc1de2c823a1486593f2d00 | EXACT_COPY
02_SIMULATION_RESULTS/01_MC200_TT_LOW_W4/csv/first_conversion_path_1600.csv | D:\PICO\A44_SAR_ADC_CURRENT_CACE_REPRODUCIBLE_20260728_R1\01_MC200_TT_LOW_W4\csv\first_conversion_path_1600.csv | D:\PICO\A44_SAR_ADC_CURRENT_CACE_REPRODUCIBLE_20260728_R2\02_SIMULATION_RESULTS\01_MC200_TT_LOW_W4\csv\first_conversion_path_1600.csv | 981911 | 981911 | bd4ae93883b0067e92b1d04d801d52df478812d21ffa185b3865fa9915783075 | bd4ae93883b0067e92b1d04d801d52df478812d21ffa185b3865fa9915783075 | EXACT_COPY
02_SIMULATION_RESULTS/01_MC200_TT_LOW_W4/csv/job_codes/MC200_CMP_XM5_XM6_W8P2524_XM7_XM11_W16P8587_S001_LOW_W4.csv | D:\PICO\A44_SAR_ADC_CURRENT_CACE_REPRODUCIBLE_20260728_R1\01_MC200_TT_LOW_W4\csv\job_codes\MC200_CMP_XM5_XM6_W8P2524_XM7_XM11_W16P8587_S001_LOW_W4.csv | D:\PICO\A44_SAR_ADC_CURRENT_CACE_REPRODUCIBLE_20260728_R2\02_SIMULATION_RESULTS\01_MC200_TT_LOW_W4\csv\job_codes\MC200_CMP_XM5_XM6_W8P2524_XM7_XM11_W16P8587_S001_LOW_W4.csv | 24196 | 24196 | 782bc5f5781a70bb8e686833378128166631ddf302ad67ea1dc92f8df2fd8f32 | 782bc5f5781a70bb8e686833378128166631ddf302ad67ea1dc92f8df2fd8f32 | EXACT_COPY
02_SIMULATION_RESULTS/01_MC200_TT_LOW_W4/csv/job_codes/MC200_CMP_XM5_XM6_W8P2524_XM7_XM11_W16P8587_S002_LOW_W4.csv | D:\PICO\A44_SAR_ADC_CURRENT_CACE_REPRODUCIBLE_20260728_R1\01_MC200_TT_LOW_W4\csv\job_codes\MC200_CMP_XM5_XM6_W8P2524_XM7_XM11_W16P8587_S002_LOW_W4.csv | D:\PICO\A44_SAR_ADC_CURRENT_CACE_REPRODUCIBLE_20260728_R2\02_SIMULATION_RESULTS\01_MC200_TT_LOW_W4\csv\job_codes\MC200_CMP_XM5_XM6_W8P2524_XM7_XM11_W16P8587_S002_LOW_W4.csv | 24184 | 24184 | 3206903252b3786023826dac7031edfc8c7af13113cdcf6c17b6fea744e3d351 | 3206903252b3786023826dac7031edfc8c7af13113cdcf6c17b6fea744e3d351 | EXACT_COPY
02_SIMULATION_RESULTS/01_MC200_TT_LOW_W4/csv/job_codes/MC200_CMP_XM5_XM6_W8P2524_XM7_XM11_W16P8587_S003_LOW_W4.csv | D:\PICO\A44_SAR_ADC_CURRENT_CACE_REPRODUCIBLE_20260728_R1\01_MC200_TT_LOW_W4\csv\job_codes\MC200_CMP_XM5_XM6_W8P2524_XM7_XM11_W16P8587_S003_LOW_W4.csv | D:\PICO\A44_SAR_ADC_CURRENT_CACE_REPRODUCIBLE_20260728_R2\02_SIMULATION_RESULTS\01_MC200_TT_LOW_W4\csv\job_codes\MC200_CMP_XM5_XM6_W8P2524_XM7_XM11_W16P8587_S003_LOW_W4.csv | 24182 | 24182 | 98d8a5bf35222c2def78fd3b37780b867f5c916c8b9a730dc38fe4542a9a4b5a | 98d8a5bf35222c2def78fd3b37780b867f5c916c8b9a730dc38fe4542a9a4b5a | EXACT_COPY
02_SIMULATION_RESULTS/01_MC200_TT_LOW_W4/csv/job_codes/MC200_CMP_XM5_XM6_W8P2524_XM7_XM11_W16P8587_S004_LOW_W4.csv | D:\PICO\A44_SAR_ADC_CURRENT_CACE_REPRODUCIBLE_20260728_R1\01_MC200_TT_LOW_W4\csv\job_codes\MC200_CMP_XM5_XM6_W8P2524_XM7_XM11_W16P8587_S004_LOW_W4.csv | D:\PICO\A44_SAR_ADC_CURRENT_CACE_REPRODUCIBLE_20260728_R2\02_SIMULATION_RESULTS\01_MC200_TT_LOW_W4\csv\job_codes\MC200_CMP_XM5_XM6_W8P2524_XM7_XM11_W16P8587_S004_LOW_W4.csv | 24196 | 24196 | 1a34f1f66c43b89b26b0d8f9d16d948fbdd915fd2621a76f7a1d31a21c4a0d00 | 1a34f1f66c43b89b26b0d8f9d16d948fbdd915fd2621a76f7a1d31a21c4a0d00 | EXACT_COPY
02_SIMULATION_RESULTS/01_MC200_TT_LOW_W4/csv/job_codes/MC200_CMP_XM5_XM6_W8P2524_XM7_XM11_W16P8587_S005_LOW_W4.csv | D:\PICO\A44_SAR_ADC_CURRENT_CACE_REPRODUCIBLE_20260728_R1\01_MC200_TT_LOW_W4\csv\job_codes\MC200_CMP_XM5_XM6_W8P2524_XM7_XM11_W16P8587_S005_LOW_W4.csv | D:\PICO\A44_SAR_ADC_CURRENT_CACE_REPRODUCIBLE_20260728_R2\02_SIMULATION_RESULTS\01_MC200_TT_LOW_W4\csv\job_codes\MC200_CMP_XM5_XM6_W8P2524_XM7_XM11_W16P8587_S005_LOW_W4.csv | 24175 | 24175 | d50deab48fc94d264ac3d3f642364c1a4699840f190c19b5f20fca861a5a8410 | d50deab48fc94d264ac3d3f642364c1a4699840f190c19b5f20fca861a5a8410 | EXACT_COPY
02_SIMULATION_RESULTS/01_MC200_TT_LOW_W4/csv/job_codes/MC200_CMP_XM5_XM6_W8P2524_XM7_XM11_W16P8587_S006_LOW_W4.csv | D:\PICO\A44_SAR_ADC_CURRENT_CACE_REPRODUCIBLE_20260728_R1\01_MC200_TT_LOW_W4\csv\job_codes\MC200_CMP_XM5_XM6_W8P2524_XM7_XM11_W16P8587_S006_LOW_W4.csv | D:\PICO\A44_SAR_ADC_CURRENT_CACE_REPRODUCIBLE_20260728_R2\02_SIMULATION_RESULTS\01_MC200_TT_LOW_W4\csv\job_codes\MC200_CMP_XM5_XM6_W8P2524_XM7_XM11_W16P8587_S006_LOW_W4.csv | 24184 | 24184 | 3740b4465e0692d6ec7bc272e3dfcefe21399f5703d96e8cf9b1294db6d12d42 | 3740b4465e0692d6ec7bc272e3dfcefe21399f5703d96e8cf9b1294db6d12d42 | EXACT_COPY
02_SIMULATION_RESULTS/01_MC200_TT_LOW_W4/csv/job_codes/MC200_CMP_XM5_XM6_W8P2524_XM7_XM11_W16P8587_S007_LOW_W4.csv | D:\PICO\A44_SAR_ADC_CURRENT_CACE_REPRODUCIBLE_20260728_R1\01_MC200_TT_LOW_W4\csv\job_codes\MC200_CMP_XM5_XM6_W8P2524_XM7_XM11_W16P8587_S007_LOW_W4.csv | D:\PICO\A44_SAR_ADC_CURRENT_CACE_REPRODUCIBLE_20260728_R2\02_SIMULATION_RESULTS\01_MC200_TT_LOW_W4\csv\job_codes\MC200_CMP_XM5_XM6_W8P2524_XM7_XM11_W16P8587_S007_LOW_W4.csv | 24177 | 24177 | 14f725195501436cf1302a3293d6b1eb565c86948145b547021675e002887716 | 14f725195501436cf1302a3293d6b1eb565c86948145b547021675e002887716 | EXACT_COPY
02_SIMULATION_RESULTS/01_MC200_TT_LOW_W4/csv/job_codes/MC200_CMP_XM5_XM6_W8P2524_XM7_XM11_W16P8587_S008_LOW_W4.csv | D:\PICO\A44_SAR_ADC_CURRENT_CACE_REPRODUCIBLE_20260728_R1\01_MC200_TT_LOW_W4\csv\job_codes\MC200_CMP_XM5_XM6_W8P2524_XM7_XM11_W16P8587_S008_LOW_W4.csv | D:\PICO\A44_SAR_ADC_CURRENT_CACE_REPRODUCIBLE_20260728_R2\02_SIMULATION_RESULTS\01_MC200_TT_LOW_W4\csv\job_codes\MC200_CMP_XM5_XM6_W8P2524_XM7_XM11_W16P8587_S008_LOW_W4.csv | 24177 | 24177 | 8549b0f38fd3f03bae9261c376f36d757e2848be5cdea9d764b3a8eed5f1e54d | 8549b0f38fd3f03bae9261c376f36d757e2848be5cdea9d764b3a8eed5f1e54d | EXACT_COPY
02_SIMULATION_RESULTS/01_MC200_TT_LOW_W4/csv/job_codes/MC200_CMP_XM5_XM6_W8P2524_XM7_XM11_W16P8587_S009_LOW_W4.csv | D:\PICO\A44_SAR_ADC_CURRENT_CACE_REPRODUCIBLE_20260728_R1\01_MC200_TT_LOW_W4\csv\job_codes\MC200_CMP_XM5_XM6_W8P2524_XM7_XM11_W16P8587_S009_LOW_W4.csv | D:\PICO\A44_SAR_ADC_CURRENT_CACE_REPRODUCIBLE_20260728_R2\02_SIMULATION_RESULTS\01_MC200_TT_LOW_W4\csv\job_codes\MC200_CMP_XM5_XM6_W8P2524_XM7_XM11_W16P8587_S009_LOW_W4.csv | 24189 | 24189 | 15d0bfb474d6901c7218ca319d4532ad0adda9d7b11d51e6af1ccdfca02908b7 | 15d0bfb474d6901c7218ca319d4532ad0adda9d7b11d51e6af1ccdfca02908b7 | EXACT_COPY
02_SIMULATION_RESULTS/01_MC200_TT_LOW_W4/csv/job_codes/MC200_CMP_XM5_XM6_W8P2524_XM7_XM11_W16P8587_S010_LOW_W4.csv | D:\PICO\A44_SAR_ADC_CURRENT_CACE_REPRODUCIBLE_20260728_R1\01_MC200_TT_LOW_W4\csv\job_codes\MC200_CMP_XM5_XM6_W8P2524_XM7_XM11_W16P8587_S010_LOW_W4.csv | D:\PICO\A44_SAR_ADC_CURRENT_CACE_REPRODUCIBLE_20260728_R2\02_SIMULATION_RESULTS\01_MC200_TT_LOW_W4\csv\job_codes\MC200_CMP_XM5_XM6_W8P2524_XM7_XM11_W16P8587_S010_LOW_W4.csv | 24234 | 24234 | a27d68dbd515a6f5ee6446efa887dcc91a7cf5233d5e9f5d7a9997704d1eb75c | a27d68dbd515a6f5ee6446efa887dcc91a7cf5233d5e9f5d7a9997704d1eb75c | EXACT_COPY
02_SIMULATION_RESULTS/01_MC200_TT_LOW_W4/csv/job_codes/MC200_CMP_XM5_XM6_W8P2524_XM7_XM11_W16P8587_S011_LOW_W4.csv | D:\PICO\A44_SAR_ADC_CURRENT_CACE_REPRODUCIBLE_20260728_R1\01_MC200_TT_LOW_W4\csv\job_codes\MC200_CMP_XM5_XM6_W8P2524_XM7_XM11_W16P8587_S011_LOW_W4.csv | D:\PICO\A44_SAR_ADC_CURRENT_CACE_REPRODUCIBLE_20260728_R2\02_SIMULATION_RESULTS\01_MC200_TT_LOW_W4\csv\job_codes\MC200_CMP_XM5_XM6_W8P2524_XM7_XM11_W16P8587_S011_LOW_W4.csv | 24243 | 24243 | d74c2cf244f934bad7f2994f033c733a8f5c3f6275a14681fc8587da3a2332a4 | d74c2cf244f934bad7f2994f033c733a8f5c3f6275a14681fc8587da3a2332a4 | EXACT_COPY
02_SIMULATION_RESULTS/01_MC200_TT_LOW_W4/csv/job_codes/MC200_CMP_XM5_XM6_W8P2524_XM7_XM11_W16P8587_S012_LOW_W4.csv | D:\PICO\A44_SAR_ADC_CURRENT_CACE_REPRODUCIBLE_20260728_R1\01_MC200_TT_LOW_W4\csv\job_codes\MC200_CMP_XM5_XM6_W8P2524_XM7_XM11_W16P8587_S012_LOW_W4.csv | D:\PICO\A44_SAR_ADC_CURRENT_CACE_REPRODUCIBLE_20260728_R2\02_SIMULATION_RESULTS\01_MC200_TT_LOW_W4\csv\job_codes\MC200_CMP_XM5_XM6_W8P2524_XM7_XM11_W16P8587_S012_LOW_W4.csv | 24255 | 24255 | 2f73b170dc1ea678810be05da1b8ffb4faf50f49537d4d21775403d6c05a06c9 | 2f73b170dc1ea678810be05da1b8ffb4faf50f49537d4d21775403d6c05a06c9 | EXACT_COPY
02_SIMULATION_RESULTS/01_MC200_TT_LOW_W4/csv/job_codes/MC200_CMP_XM5_XM6_W8P2524_XM7_XM11_W16P8587_S013_LOW_W4.csv | D:\PICO\A44_SAR_ADC_CURRENT_CACE_REPRODUCIBLE_20260728_R1\01_MC200_TT_LOW_W4\csv\job_codes\MC200_CMP_XM5_XM6_W8P2524_XM7_XM11_W16P8587_S013_LOW_W4.csv | D:\PICO\A44_SAR_ADC_CURRENT_CACE_REPRODUCIBLE_20260728_R2\02_SIMULATION_RESULTS\01_MC200_TT_LOW_W4\csv\job_codes\MC200_CMP_XM5_XM6_W8P2524_XM7_XM11_W16P8587_S013_LOW_W4.csv | 24252 | 24252 | 28703bd8d1cd18f6f5fc07a4ee4d4d32fef7a3303bac99431f84d2df63ca26c8 | 28703bd8d1cd18f6f5fc07a4ee4d4d32fef7a3303bac99431f84d2df63ca26c8 | EXACT_COPY
02_SIMULATION_RESULTS/01_MC200_TT_LOW_W4/csv/job_codes/MC200_CMP_XM5_XM6_W8P2524_XM7_XM11_W16P8587_S014_LOW_W4.csv | D:\PICO\A44_SAR_ADC_CURRENT_CACE_REPRODUCIBLE_20260728_R1\01_MC200_TT_LOW_W4\csv\job_codes\MC200_CMP_XM5_XM6_W8P2524_XM7_XM11_W16P8587_S014_LOW_W4.csv | D:\PICO\A44_SAR_ADC_CURRENT_CACE_REPRODUCIBLE_20260728_R2\02_SIMULATION_RESULTS\01_MC200_TT_LOW_W4\csv\job_codes\MC200_CMP_XM5_XM6_W8P2524_XM7_XM11_W16P8587_S014_LOW_W4.csv | 24249 | 24249 | 449291c642219a0226af510db51abc724ab893041d6841057f6315725963f4b0 | 449291c642219a0226af510db51abc724ab893041d6841057f6315725963f4b0 | EXACT_COPY
02_SIMULATION_RESULTS/01_MC200_TT_LOW_W4/csv/job_codes/MC200_CMP_XM5_XM6_W8P2524_XM7_XM11_W16P8587_S015_LOW_W4.csv | D:\PICO\A44_SAR_ADC_CURRENT_CACE_REPRODUCIBLE_20260728_R1\01_MC200_TT_LOW_W4\csv\job_codes\MC200_CMP_XM5_XM6_W8P2524_XM7_XM11_W16P8587_S015_LOW_W4.csv | D:\PICO\A44_SAR_ADC_CURRENT_CACE_REPRODUCIBLE_20260728_R2\02_SIMULATION_RESULTS\01_MC200_TT_LOW_W4\csv\job_codes\MC200_CMP_XM5_XM6_W8P2524_XM7_XM11_W16P8587_S015_LOW_W4.csv | 24255 | 24255 | 35b32d1abe21df97068856155d895578e681b74f217414476015f069adb36bea | 35b32d1abe21df97068856155d895578e681b74f217414476015f069adb36bea | EXACT_COPY
02_SIMULATION_RESULTS/01_MC200_TT_LOW_W4/csv/job_codes/MC200_CMP_XM5_XM6_W8P2524_XM7_XM11_W16P8587_S016_LOW_W4.csv | D:\PICO\A44_SAR_ADC_CURRENT_CACE_REPRODUCIBLE_20260728_R1\01_MC200_TT_LOW_W4\csv\job_codes\MC200_CMP_XM5_XM6_W8P2524_XM7_XM11_W16P8587_S016_LOW_W4.csv | D:\PICO\A44_SAR_ADC_CURRENT_CACE_REPRODUCIBLE_20260728_R2\02_SIMULATION_RESULTS\01_MC200_TT_LOW_W4\csv\job_codes\MC200_CMP_XM5_XM6_W8P2524_XM7_XM11_W16P8587_S016_LOW_W4.csv | 24239 | 24239 | 7fcbe467dcf1d494b388bd215ee2ec5b51dac2607b3d847a8eda7cb70f507b97 | 7fcbe467dcf1d494b388bd215ee2ec5b51dac2607b3d847a8eda7cb70f507b97 | EXACT_COPY
02_SIMULATION_RESULTS/01_MC200_TT_LOW_W4/csv/job_codes/MC200_CMP_XM5_XM6_W8P2524_XM7_XM11_W16P8587_S017_LOW_W4.csv | D:\PICO\A44_SAR_ADC_CURRENT_CACE_REPRODUCIBLE_20260728_R1\01_MC200_TT_LOW_W4\csv\job_codes\MC200_CMP_XM5_XM6_W8P2524_XM7_XM11_W16P8587_S017_LOW_W4.csv | D:\PICO\A44_SAR_ADC_CURRENT_CACE_REPRODUCIBLE_20260728_R2\02_SIMULATION_RESULTS\01_MC200_TT_LOW_W4\csv\job_codes\MC200_CMP_XM5_XM6_W8P2524_XM7_XM11_W16P8587_S017_LOW_W4.csv | 24258 | 24258 | 79c37a57d9c1f78f5a578ebca270ab13161ff1eeb4f38032b75d2f7b97faea7a | 79c37a57d9c1f78f5a578ebca270ab13161ff1eeb4f38032b75d2f7b97faea7a | EXACT_COPY
02_SIMULATION_RESULTS/01_MC200_TT_LOW_W4/csv/job_codes/MC200_CMP_XM5_XM6_W8P2524_XM7_XM11_W16P8587_S018_LOW_W4.csv | D:\PICO\A44_SAR_ADC_CURRENT_CACE_REPRODUCIBLE_20260728_R1\01_MC200_TT_LOW_W4\csv\job_codes\MC200_CMP_XM5_XM6_W8P2524_XM7_XM11_W16P8587_S018_LOW_W4.csv | D:\PICO\A44_SAR_ADC_CURRENT_CACE_REPRODUCIBLE_20260728_R2\02_SIMULATION_RESULTS\01_MC200_TT_LOW_W4\csv\job_codes\MC200_CMP_XM5_XM6_W8P2524_XM7_XM11_W16P8587_S018_LOW_W4.csv | 24252 | 24252 | a64a61c8d3c61858789ad284c601d19a3e9ae02bd14cbb9106b9f8e4cc0ea96b | a64a61c8d3c61858789ad284c601d19a3e9ae02bd14cbb9106b9f8e4cc0ea96b | EXACT_COPY
02_SIMULATION_RESULTS/01_MC200_TT_LOW_W4/csv/job_codes/MC200_CMP_XM5_XM6_W8P2524_XM7_XM11_W16P8587_S019_LOW_W4.csv | D:\PICO\A44_SAR_ADC_CURRENT_CACE_REPRODUCIBLE_20260728_R1\01_MC200_TT_LOW_W4\csv\job_codes\MC200_CMP_XM5_XM6_W8P2524_XM7_XM11_W16P8587_S019_LOW_W4.csv | D:\PICO\A44_SAR_ADC_CURRENT_CACE_REPRODUCIBLE_20260728_R2\02_SIMULATION_RESULTS\01_MC200_TT_LOW_W4\csv\job_codes\MC200_CMP_XM5_XM6_W8P2524_XM7_XM11_W16P8587_S019_LOW_W4.csv | 24250 | 24250 | 5c4e1289cc86f388006eaf8771b9be639b749ed800e2a73b1ae492ae22cd1b21 | 5c4e1289cc86f388006eaf8771b9be639b749ed800e2a73b1ae492ae22cd1b21 | EXACT_COPY
02_SIMULATION_RESULTS/01_MC200_TT_LOW_W4/csv/job_codes/MC200_CMP_XM5_XM6_W8P2524_XM7_XM11_W16P8587_S020_LOW_W4.csv | D:\PICO\A44_SAR_ADC_CURRENT_CACE_REPRODUCIBLE_20260728_R1\01_MC200_TT_LOW_W4\csv\job_codes\MC200_CMP_XM5_XM6_W8P2524_XM7_XM11_W16P8587_S020_LOW_W4.csv | D:\PICO\A44_SAR_ADC_CURRENT_CACE_REPRODUCIBLE_20260728_R2\02_SIMULATION_RESULTS\01_MC200_TT_LOW_W4\csv\job_codes\MC200_CMP_XM5_XM6_W8P2524_XM7_XM11_W16P8587_S020_LOW_W4.csv | 24259 | 24259 | 1e5cfd0123c99ce704b3dc6539c0074cf5d75da8f03375b9a44162a957da3846 | 1e5cfd0123c99ce704b3dc6539c0074cf5d75da8f03375b9a44162a957da3846 | EXACT_COPY
02_SIMULATION_RESULTS/01_MC200_TT_LOW_W4/csv/job_codes/MC200_CMP_XM5_XM6_W8P2524_XM7_XM11_W16P8587_S021_LOW_W4.csv | D:\PICO\A44_SAR_ADC_CURRENT_CACE_REPRODUCIBLE_20260728_R1\01_MC200_TT_LOW_W4\csv\job_codes\MC200_CMP_XM5_XM6_W8P2524_XM7_XM11_W16P8587_S021_LOW_W4.csv | D:\PICO\A44_SAR_ADC_CURRENT_CACE_REPRODUCIBLE_20260728_R2\02_SIMULATION_RESULTS\01_MC200_TT_LOW_W4\csv\job_codes\MC200_CMP_XM5_XM6_W8P2524_XM7_XM11_W16P8587_S021_LOW_W4.csv | 24255 | 24255 | 753403a45b242155bc3569cab53d3b20e43d23cd54de19a112dca540807a5ae3 | 753403a45b242155bc3569cab53d3b20e43d23cd54de19a112dca540807a5ae3 | EXACT_COPY
02_SIMULATION_RESULTS/01_MC200_TT_LOW_W4/csv/job_codes/MC200_CMP_XM5_XM6_W8P2524_XM7_XM11_W16P8587_S022_LOW_W4.csv | D:\PICO\A44_SAR_ADC_CURRENT_CACE_REPRODUCIBLE_20260728_R1\01_MC200_TT_LOW_W4\csv\job_codes\MC200_CMP_XM5_XM6_W8P2524_XM7_XM11_W16P8587_S022_LOW_W4.csv | D:\PICO\A44_SAR_ADC_CURRENT_CACE_REPRODUCIBLE_20260728_R2\02_SIMULATION_RESULTS\01_MC200_TT_LOW_W4\csv\job_codes\MC200_CMP_XM5_XM6_W8P2524_XM7_XM11_W16P8587_S022_LOW_W4.csv | 24251 | 24251 | 0f528f3e1a9b6820a693978fa3e34d26fbe095d9cb363df07357a448763771b4 | 0f528f3e1a9b6820a693978fa3e34d26fbe095d9cb363df07357a448763771b4 | EXACT_COPY
02_SIMULATION_RESULTS/01_MC200_TT_LOW_W4/csv/job_codes/MC200_CMP_XM5_XM6_W8P2524_XM7_XM11_W16P8587_S023_LOW_W4.csv | D:\PICO\A44_SAR_ADC_CURRENT_CACE_REPRODUCIBLE_20260728_R1\01_MC200_TT_LOW_W4\csv\job_codes\MC200_CMP_XM5_XM6_W8P2524_XM7_XM11_W16P8587_S023_LOW_W4.csv | D:\PICO\A44_SAR_ADC_CURRENT_CACE_REPRODUCIBLE_20260728_R2\02_SIMULATION_RESULTS\01_MC200_TT_LOW_W4\csv\job_codes\MC200_CMP_XM5_XM6_W8P2524_XM7_XM11_W16P8587_S023_LOW_W4.csv | 24254 | 24254 | b2f48cbd085bff6648a818f99fabb5fa5fe55dd5228b41b02fb345030f798ec0 | b2f48cbd085bff6648a818f99fabb5fa5fe55dd5228b41b02fb345030f798ec0 | EXACT_COPY
02_SIMULATION_RESULTS/01_MC200_TT_LOW_W4/csv/job_codes/MC200_CMP_XM5_XM6_W8P2524_XM7_XM11_W16P8587_S024_LOW_W4.csv | D:\PICO\A44_SAR_ADC_CURRENT_CACE_REPRODUCIBLE_20260728_R1\01_MC200_TT_LOW_W4\csv\job_codes\MC200_CMP_XM5_XM6_W8P2524_XM7_XM11_W16P8587_S024_LOW_W4.csv | D:\PICO\A44_SAR_ADC_CURRENT_CACE_REPRODUCIBLE_20260728_R2\02_SIMULATION_RESULTS\01_MC200_TT_LOW_W4\csv\job_codes\MC200_CMP_XM5_XM6_W8P2524_XM7_XM11_W16P8587_S024_LOW_W4.csv | 24258 | 24258 | 04a846adbde6a813937a00e3d419aeee8f7875d9f9e9035f9acd4c0a30852330 | 04a846adbde6a813937a00e3d419aeee8f7875d9f9e9035f9acd4c0a30852330 | EXACT_COPY
02_SIMULATION_RESULTS/01_MC200_TT_LOW_W4/csv/job_codes/MC200_CMP_XM5_XM6_W8P2524_XM7_XM11_W16P8587_S025_LOW_W4.csv | D:\PICO\A44_SAR_ADC_CURRENT_CACE_REPRODUCIBLE_20260728_R1\01_MC200_TT_LOW_W4\csv\job_codes\MC200_CMP_XM5_XM6_W8P2524_XM7_XM11_W16P8587_S025_LOW_W4.csv | D:\PICO\A44_SAR_ADC_CURRENT_CACE_REPRODUCIBLE_20260728_R2\02_SIMULATION_RESULTS\01_MC200_TT_LOW_W4\csv\job_codes\MC200_CMP_XM5_XM6_W8P2524_XM7_XM11_W16P8587_S025_LOW_W4.csv | 24251 | 24251 | cb9080c2f8c49b0e075cfbea4bf13e57f8644751d0f288e886b3f8b0b8f8b29a | cb9080c2f8c49b0e075cfbea4bf13e57f8644751d0f288e886b3f8b0b8f8b29a | EXACT_COPY
02_SIMULATION_RESULTS/01_MC200_TT_LOW_W4/csv/job_codes/MC200_CMP_XM5_XM6_W8P2524_XM7_XM11_W16P8587_S026_LOW_W4.csv | D:\PICO\A44_SAR_ADC_CURRENT_CACE_REPRODUCIBLE_20260728_R1\01_MC200_TT_LOW_W4\csv\job_codes\MC200_CMP_XM5_XM6_W8P2524_XM7_XM11_W16P8587_S026_LOW_W4.csv | D:\PICO\A44_SAR_ADC_CURRENT_CACE_REPRODUCIBLE_20260728_R2\02_SIMULATION_RESULTS\01_MC200_TT_LOW_W4\csv\job_codes\MC200_CMP_XM5_XM6_W8P2524_XM7_XM11_W16P8587_S026_LOW_W4.csv | 24258 | 24258 | 57f069a2866b0779297de5039f968159f8590997c3c2003f965ae551969c7b1e | 57f069a2866b0779297de5039f968159f8590997c3c2003f965ae551969c7b1e | EXACT_COPY
02_SIMULATION_RESULTS/01_MC200_TT_LOW_W4/csv/job_codes/MC200_CMP_XM5_XM6_W8P2524_XM7_XM11_W16P8587_S027_LOW_W4.csv | D:\PICO\A44_SAR_ADC_CURRENT_CACE_REPRODUCIBLE_20260728_R1\01_MC200_TT_LOW_W4\csv\job_codes\MC200_CMP_XM5_XM6_W8P2524_XM7_XM11_W16P8587_S027_LOW_W4.csv | D:\PICO\A44_SAR_ADC_CURRENT_CACE_REPRODUCIBLE_20260728_R2\02_SIMULATION_RESULTS\01_MC200_TT_LOW_W4\csv\job_codes\MC200_CMP_XM5_XM6_W8P2524_XM7_XM11_W16P8587_S027_LOW_W4.csv | 24249 | 24249 | 489ecb3f5bc5ce7a3699133bd9135b0c95f1a6787ad39bff68470fc4da55f6ab | 489ecb3f5bc5ce7a3699133bd9135b0c95f1a6787ad39bff68470fc4da55f6ab | EXACT_COPY
02_SIMULATION_RESULTS/01_MC200_TT_LOW_W4/csv/job_codes/MC200_CMP_XM5_XM6_W8P2524_XM7_XM11_W16P8587_S028_LOW_W4.csv | D:\PICO\A44_SAR_ADC_CURRENT_CACE_REPRODUCIBLE_20260728_R1\01_MC200_TT_LOW_W4\csv\job_codes\MC200_CMP_XM5_XM6_W8P2524_XM7_XM11_W16P8587_S028_LOW_W4.csv | D:\PICO\A44_SAR_ADC_CURRENT_CACE_REPRODUCIBLE_20260728_R2\02_SIMULATION_RESULTS\01_MC200_TT_LOW_W4\csv\job_codes\MC200_CMP_XM5_XM6_W8P2524_XM7_XM11_W16P8587_S028_LOW_W4.csv | 24244 | 24244 | 58c32b0e2b51ef11cf888625c2018f99f87d7a837f2ba8aa35ddc9eb3d92142c | 58c32b0e2b51ef11cf888625c2018f99f87d7a837f2ba8aa35ddc9eb3d92142c | EXACT_COPY
02_SIMULATION_RESULTS/01_MC200_TT_LOW_W4/csv/job_codes/MC200_CMP_XM5_XM6_W8P2524_XM7_XM11_W16P8587_S029_LOW_W4.csv | D:\PICO\A44_SAR_ADC_CURRENT_CACE_REPRODUCIBLE_20260728_R1\01_MC200_TT_LOW_W4\csv\job_codes\MC200_CMP_XM5_XM6_W8P2524_XM7_XM11_W16P8587_S029_LOW_W4.csv | D:\PICO\A44_SAR_ADC_CURRENT_CACE_REPRODUCIBLE_20260728_R2\02_SIMULATION_RESULTS\01_MC200_TT_LOW_W4\csv\job_codes\MC200_CMP_XM5_XM6_W8P2524_XM7_XM11_W16P8587_S029_LOW_W4.csv | 24258 | 24258 | e3929fee880ae1bdedb8175d18642ba9fadb19d3456a3ee7af3cad7ae6bcd7fe | e3929fee880ae1bdedb8175d18642ba9fadb19d3456a3ee7af3cad7ae6bcd7fe | EXACT_COPY
02_SIMULATION_RESULTS/01_MC200_TT_LOW_W4/csv/job_codes/MC200_CMP_XM5_XM6_W8P2524_XM7_XM11_W16P8587_S030_LOW_W4.csv | D:\PICO\A44_SAR_ADC_CURRENT_CACE_REPRODUCIBLE_20260728_R1\01_MC200_TT_LOW_W4\csv\job_codes\MC200_CMP_XM5_XM6_W8P2524_XM7_XM11_W16P8587_S030_LOW_W4.csv | D:\PICO\A44_SAR_ADC_CURRENT_CACE_REPRODUCIBLE_20260728_R2\02_SIMULATION_RESULTS\01_MC200_TT_LOW_W4\csv\job_codes\MC200_CMP_XM5_XM6_W8P2524_XM7_XM11_W16P8587_S030_LOW_W4.csv | 24257 | 24257 | 9ef623ec8c02da155560e7fd1776b61ae1bff8987849f3aa4975e68721acd9cd | 9ef623ec8c02da155560e7fd1776b61ae1bff8987849f3aa4975e68721acd9cd | EXACT_COPY
02_SIMULATION_RESULTS/01_MC200_TT_LOW_W4/csv/job_codes/MC200_CMP_XM5_XM6_W8P2524_XM7_XM11_W16P8587_S031_LOW_W4.csv | D:\PICO\A44_SAR_ADC_CURRENT_CACE_REPRODUCIBLE_20260728_R1\01_MC200_TT_LOW_W4\csv\job_codes\MC200_CMP_XM5_XM6_W8P2524_XM7_XM11_W16P8587_S031_LOW_W4.csv | D:\PICO\A44_SAR_ADC_CURRENT_CACE_REPRODUCIBLE_20260728_R2\02_SIMULATION_RESULTS\01_MC200_TT_LOW_W4\csv\job_codes\MC200_CMP_XM5_XM6_W8P2524_XM7_XM11_W16P8587_S031_LOW_W4.csv | 24264 | 24264 | 5fcd64aa752199e7392bd4ac87b44948f0f9d6eb698f5117a4eb4806bb40c779 | 5fcd64aa752199e7392bd4ac87b44948f0f9d6eb698f5117a4eb4806bb40c779 | EXACT_COPY
02_SIMULATION_RESULTS/01_MC200_TT_LOW_W4/csv/job_codes/MC200_CMP_XM5_XM6_W8P2524_XM7_XM11_W16P8587_S032_LOW_W4.csv | D:\PICO\A44_SAR_ADC_CURRENT_CACE_REPRODUCIBLE_20260728_R1\01_MC200_TT_LOW_W4\csv\job_codes\MC200_CMP_XM5_XM6_W8P2524_XM7_XM11_W16P8587_S032_LOW_W4.csv | D:\PICO\A44_SAR_ADC_CURRENT_CACE_REPRODUCIBLE_20260728_R2\02_SIMULATION_RESULTS\01_MC200_TT_LOW_W4\csv\job_codes\MC200_CMP_XM5_XM6_W8P2524_XM7_XM11_W16P8587_S032_LOW_W4.csv | 24249 | 24249 | df858fe5b610209ef99252fbe9c76c038b1ab54fd3df9b7a904a94de33316b3f | df858fe5b610209ef99252fbe9c76c038b1ab54fd3df9b7a904a94de33316b3f | EXACT_COPY
02_SIMULATION_RESULTS/01_MC200_TT_LOW_W4/csv/job_codes/MC200_CMP_XM5_XM6_W8P2524_XM7_XM11_W16P8587_S033_LOW_W4.csv | D:\PICO\A44_SAR_ADC_CURRENT_CACE_REPRODUCIBLE_20260728_R1\01_MC200_TT_LOW_W4\csv\job_codes\MC200_CMP_XM5_XM6_W8P2524_XM7_XM11_W16P8587_S033_LOW_W4.csv | D:\PICO\A44_SAR_ADC_CURRENT_CACE_REPRODUCIBLE_20260728_R2\02_SIMULATION_RESULTS\01_MC200_TT_LOW_W4\csv\job_codes\MC200_CMP_XM5_XM6_W8P2524_XM7_XM11_W16P8587_S033_LOW_W4.csv | 24245 | 24245 | 281a89fc60d3acc10c6be69ba06a365aeeeda504474c8f8fecefca0803d49513 | 281a89fc60d3acc10c6be69ba06a365aeeeda504474c8f8fecefca0803d49513 | EXACT_COPY
02_SIMULATION_RESULTS/01_MC200_TT_LOW_W4/csv/job_codes/MC200_CMP_XM5_XM6_W8P2524_XM7_XM11_W16P8587_S034_LOW_W4.csv | D:\PICO\A44_SAR_ADC_CURRENT_CACE_REPRODUCIBLE_20260728_R1\01_MC200_TT_LOW_W4\csv\job_codes\MC200_CMP_XM5_XM6_W8P2524_XM7_XM11_W16P8587_S034_LOW_W4.csv | D:\PICO\A44_SAR_ADC_CURRENT_CACE_REPRODUCIBLE_20260728_R2\02_SIMULATION_RESULTS\01_MC200_TT_LOW_W4\csv\job_codes\MC200_CMP_XM5_XM6_W8P2524_XM7_XM11_W16P8587_S034_LOW_W4.csv | 24240 | 24240 | 09c4bb32a7e1bc08267b695a4d77f4688817c3e57b05987e5a8765eff29142ca | 09c4bb32a7e1bc08267b695a4d77f4688817c3e57b05987e5a8765eff29142ca | EXACT_COPY
02_SIMULATION_RESULTS/01_MC200_TT_LOW_W4/csv/job_codes/MC200_CMP_XM5_XM6_W8P2524_XM7_XM11_W16P8587_S035_LOW_W4.csv | D:\PICO\A44_SAR_ADC_CURRENT_CACE_REPRODUCIBLE_20260728_R1\01_MC200_TT_LOW_W4\csv\job_codes\MC200_CMP_XM5_XM6_W8P2524_XM7_XM11_W16P8587_S035_LOW_W4.csv | D:\PICO\A44_SAR_ADC_CURRENT_CACE_REPRODUCIBLE_20260728_R2\02_SIMULATION_RESULTS\01_MC200_TT_LOW_W4\csv\job_codes\MC200_CMP_XM5_XM6_W8P2524_XM7_XM11_W16P8587_S035_LOW_W4.csv | 24258 | 24258 | c2b0164a9bf4f5009b4ec2dce6ee58bc15b9f0f467be8a7cedd176e544a533b6 | c2b0164a9bf4f5009b4ec2dce6ee58bc15b9f0f467be8a7cedd176e544a533b6 | EXACT_COPY
02_SIMULATION_RESULTS/01_MC200_TT_LOW_W4/csv/job_codes/MC200_CMP_XM5_XM6_W8P2524_XM7_XM11_W16P8587_S036_LOW_W4.csv | D:\PICO\A44_SAR_ADC_CURRENT_CACE_REPRODUCIBLE_20260728_R1\01_MC200_TT_LOW_W4\csv\job_codes\MC200_CMP_XM5_XM6_W8P2524_XM7_XM11_W16P8587_S036_LOW_W4.csv | D:\PICO\A44_SAR_ADC_CURRENT_CACE_REPRODUCIBLE_20260728_R2\02_SIMULATION_RESULTS\01_MC200_TT_LOW_W4\csv\job_codes\MC200_CMP_XM5_XM6_W8P2524_XM7_XM11_W16P8587_S036_LOW_W4.csv | 24261 | 24261 | 5e4f157aaaa9cd8e4682f5c5c665f6633857974d81e6ff6ad7e50fdd906bb3e4 | 5e4f157aaaa9cd8e4682f5c5c665f6633857974d81e6ff6ad7e50fdd906bb3e4 | EXACT_COPY
02_SIMULATION_RESULTS/01_MC200_TT_LOW_W4/csv/job_codes/MC200_CMP_XM5_XM6_W8P2524_XM7_XM11_W16P8587_S037_LOW_W4.csv | D:\PICO\A44_SAR_ADC_CURRENT_CACE_REPRODUCIBLE_20260728_R1\01_MC200_TT_LOW_W4\csv\job_codes\MC200_CMP_XM5_XM6_W8P2524_XM7_XM11_W16P8587_S037_LOW_W4.csv | D:\PICO\A44_SAR_ADC_CURRENT_CACE_REPRODUCIBLE_20260728_R2\02_SIMULATION_RESULTS\01_MC200_TT_LOW_W4\csv\job_codes\MC200_CMP_XM5_XM6_W8P2524_XM7_XM11_W16P8587_S037_LOW_W4.csv | 24252 | 24252 | 319c382e38b7c539e7e2a442461df3f4bdb1f8ecc619d87677c2846259a5f3a2 | 319c382e38b7c539e7e2a442461df3f4bdb1f8ecc619d87677c2846259a5f3a2 | EXACT_COPY
02_SIMULATION_RESULTS/01_MC200_TT_LOW_W4/csv/job_codes/MC200_CMP_XM5_XM6_W8P2524_XM7_XM11_W16P8587_S038_LOW_W4.csv | D:\PICO\A44_SAR_ADC_CURRENT_CACE_REPRODUCIBLE_20260728_R1\01_MC200_TT_LOW_W4\csv\job_codes\MC200_CMP_XM5_XM6_W8P2524_XM7_XM11_W16P8587_S038_LOW_W4.csv | D:\PICO\A44_SAR_ADC_CURRENT_CACE_REPRODUCIBLE_20260728_R2\02_SIMULATION_RESULTS\01_MC200_TT_LOW_W4\csv\job_codes\MC200_CMP_XM5_XM6_W8P2524_XM7_XM11_W16P8587_S038_LOW_W4.csv | 24248 | 24248 | 3e1b80c7589c8c9135a794c620c79c22bad2b2679d8b965e5c3a4016095eb084 | 3e1b80c7589c8c9135a794c620c79c22bad2b2679d8b965e5c3a4016095eb084 | EXACT_COPY
02_SIMULATION_RESULTS/01_MC200_TT_LOW_W4/csv/job_codes/MC200_CMP_XM5_XM6_W8P2524_XM7_XM11_W16P8587_S039_LOW_W4.csv | D:\PICO\A44_SAR_ADC_CURRENT_CACE_REPRODUCIBLE_20260728_R1\01_MC200_TT_LOW_W4\csv\job_codes\MC200_CMP_XM5_XM6_W8P2524_XM7_XM11_W16P8587_S039_LOW_W4.csv | D:\PICO\A44_SAR_ADC_CURRENT_CACE_REPRODUCIBLE_20260728_R2\02_SIMULATION_RESULTS\01_MC200_TT_LOW_W4\csv\job_codes\MC200_CMP_XM5_XM6_W8P2524_XM7_XM11_W16P8587_S039_LOW_W4.csv | 24249 | 24249 | be53cdf73a1d9fd320d730443fc7f7cbf7192f16a12fcfb1fcc496addec79f95 | be53cdf73a1d9fd320d730443fc7f7cbf7192f16a12fcfb1fcc496addec79f95 | EXACT_COPY
02_SIMULATION_RESULTS/01_MC200_TT_LOW_W4/csv/job_codes/MC200_CMP_XM5_XM6_W8P2524_XM7_XM11_W16P8587_S040_LOW_W4.csv | D:\PICO\A44_SAR_ADC_CURRENT_CACE_REPRODUCIBLE_20260728_R1\01_MC200_TT_LOW_W4\csv\job_codes\MC200_CMP_XM5_XM6_W8P2524_XM7_XM11_W16P8587_S040_LOW_W4.csv | D:\PICO\A44_SAR_ADC_CURRENT_CACE_REPRODUCIBLE_20260728_R2\02_SIMULATION_RESULTS\01_MC200_TT_LOW_W4\csv\job_codes\MC200_CMP_XM5_XM6_W8P2524_XM7_XM11_W16P8587_S040_LOW_W4.csv | 24250 | 24250 | 549ab7d6c504d7089c048e4f91bfeae761a7e6ed4a48bf7a8424e76ab3bf94ad | 549ab7d6c504d7089c048e4f91bfeae761a7e6ed4a48bf7a8424e76ab3bf94ad | EXACT_COPY
02_SIMULATION_RESULTS/01_MC200_TT_LOW_W4/csv/job_codes/MC200_CMP_XM5_XM6_W8P2524_XM7_XM11_W16P8587_S041_LOW_W4.csv | D:\PICO\A44_SAR_ADC_CURRENT_CACE_REPRODUCIBLE_20260728_R1\01_MC200_TT_LOW_W4\csv\job_codes\MC200_CMP_XM5_XM6_W8P2524_XM7_XM11_W16P8587_S041_LOW_W4.csv | D:\PICO\A44_SAR_ADC_CURRENT_CACE_REPRODUCIBLE_20260728_R2\02_SIMULATION_RESULTS\01_MC200_TT_LOW_W4\csv\job_codes\MC200_CMP_XM5_XM6_W8P2524_XM7_XM11_W16P8587_S041_LOW_W4.csv | 24254 | 24254 | 7c741378584ace4a79fedc84dd45dcff1ff24487d8effc37ce857c696ea5c1ed | 7c741378584ace4a79fedc84dd45dcff1ff24487d8effc37ce857c696ea5c1ed | EXACT_COPY
02_SIMULATION_RESULTS/01_MC200_TT_LOW_W4/csv/job_codes/MC200_CMP_XM5_XM6_W8P2524_XM7_XM11_W16P8587_S042_LOW_W4.csv | D:\PICO\A44_SAR_ADC_CURRENT_CACE_REPRODUCIBLE_20260728_R1\01_MC200_TT_LOW_W4\csv\job_codes\MC200_CMP_XM5_XM6_W8P2524_XM7_XM11_W16P8587_S042_LOW_W4.csv | D:\PICO\A44_SAR_ADC_CURRENT_CACE_REPRODUCIBLE_20260728_R2\02_SIMULATION_RESULTS\01_MC200_TT_LOW_W4\csv\job_codes\MC200_CMP_XM5_XM6_W8P2524_XM7_XM11_W16P8587_S042_LOW_W4.csv | 24249 | 24249 | 06beea45b033c6545e49fa1c06742c5afa73e1ad65405a450a66744e1d500b74 | 06beea45b033c6545e49fa1c06742c5afa73e1ad65405a450a66744e1d500b74 | EXACT_COPY
02_SIMULATION_RESULTS/01_MC200_TT_LOW_W4/csv/job_codes/MC200_CMP_XM5_XM6_W8P2524_XM7_XM11_W16P8587_S043_LOW_W4.csv | D:\PICO\A44_SAR_ADC_CURRENT_CACE_REPRODUCIBLE_20260728_R1\01_MC200_TT_LOW_W4\csv\job_codes\MC200_CMP_XM5_XM6_W8P2524_XM7_XM11_W16P8587_S043_LOW_W4.csv | D:\PICO\A44_SAR_ADC_CURRENT_CACE_REPRODUCIBLE_20260728_R2\02_SIMULATION_RESULTS\01_MC200_TT_LOW_W4\csv\job_codes\MC200_CMP_XM5_XM6_W8P2524_XM7_XM11_W16P8587_S043_LOW_W4.csv | 24257 | 24257 | 46c6bd2736a07fef8997285aa9282acb65deabbed1f9583709d0249af7ab82d7 | 46c6bd2736a07fef8997285aa9282acb65deabbed1f9583709d0249af7ab82d7 | EXACT_COPY
02_SIMULATION_RESULTS/01_MC200_TT_LOW_W4/csv/job_codes/MC200_CMP_XM5_XM6_W8P2524_XM7_XM11_W16P8587_S044_LOW_W4.csv | D:\PICO\A44_SAR_ADC_CURRENT_CACE_REPRODUCIBLE_20260728_R1\01_MC200_TT_LOW_W4\csv\job_codes\MC200_CMP_XM5_XM6_W8P2524_XM7_XM11_W16P8587_S044_LOW_W4.csv | D:\PICO\A44_SAR_ADC_CURRENT_CACE_REPRODUCIBLE_20260728_R2\02_SIMULATION_RESULTS\01_MC200_TT_LOW_W4\csv\job_codes\MC200_CMP_XM5_XM6_W8P2524_XM7_XM11_W16P8587_S044_LOW_W4.csv | 24258 | 24258 | c8541526442c056441adb744c133dfbffe0ca883db9af7d6c43ef67952159922 | c8541526442c056441adb744c133dfbffe0ca883db9af7d6c43ef67952159922 | EXACT_COPY
02_SIMULATION_RESULTS/01_MC200_TT_LOW_W4/csv/job_codes/MC200_CMP_XM5_XM6_W8P2524_XM7_XM11_W16P8587_S045_LOW_W4.csv | D:\PICO\A44_SAR_ADC_CURRENT_CACE_REPRODUCIBLE_20260728_R1\01_MC200_TT_LOW_W4\csv\job_codes\MC200_CMP_XM5_XM6_W8P2524_XM7_XM11_W16P8587_S045_LOW_W4.csv | D:\PICO\A44_SAR_ADC_CURRENT_CACE_REPRODUCIBLE_20260728_R2\02_SIMULATION_RESULTS\01_MC200_TT_LOW_W4\csv\job_codes\MC200_CMP_XM5_XM6_W8P2524_XM7_XM11_W16P8587_S045_LOW_W4.csv | 24246 | 24246 | 0f49e7313e9002b7225ff58d5630551ba0a3b1916f43b63f132263204fd2153f | 0f49e7313e9002b7225ff58d5630551ba0a3b1916f43b63f132263204fd2153f | EXACT_COPY
02_SIMULATION_RESULTS/01_MC200_TT_LOW_W4/csv/job_codes/MC200_CMP_XM5_XM6_W8P2524_XM7_XM11_W16P8587_S046_LOW_W4.csv | D:\PICO\A44_SAR_ADC_CURRENT_CACE_REPRODUCIBLE_20260728_R1\01_MC200_TT_LOW_W4\csv\job_codes\MC200_CMP_XM5_XM6_W8P2524_XM7_XM11_W16P8587_S046_LOW_W4.csv | D:\PICO\A44_SAR_ADC_CURRENT_CACE_REPRODUCIBLE_20260728_R2\02_SIMULATION_RESULTS\01_MC200_TT_LOW_W4\csv\job_codes\MC200_CMP_XM5_XM6_W8P2524_XM7_XM11_W16P8587_S046_LOW_W4.csv | 24247 | 24247 | 71bb0119e9c4d699a3c0386f58f197632948fe98805822a675c2d803fa150aaf | 71bb0119e9c4d699a3c0386f58f197632948fe98805822a675c2d803fa150aaf | EXACT_COPY
02_SIMULATION_RESULTS/01_MC200_TT_LOW_W4/csv/job_codes/MC200_CMP_XM5_XM6_W8P2524_XM7_XM11_W16P8587_S047_LOW_W4.csv | D:\PICO\A44_SAR_ADC_CURRENT_CACE_REPRODUCIBLE_20260728_R1\01_MC200_TT_LOW_W4\csv\job_codes\MC200_CMP_XM5_XM6_W8P2524_XM7_XM11_W16P8587_S047_LOW_W4.csv | D:\PICO\A44_SAR_ADC_CURRENT_CACE_REPRODUCIBLE_20260728_R2\02_SIMULATION_RESULTS\01_MC200_TT_LOW_W4\csv\job_codes\MC200_CMP_XM5_XM6_W8P2524_XM7_XM11_W16P8587_S047_LOW_W4.csv | 24246 | 24246 | 60624d5613489e3c145214bd19da66698f778b2dc4237f6343d9c3271ebfb4a9 | 60624d5613489e3c145214bd19da66698f778b2dc4237f6343d9c3271ebfb4a9 | EXACT_COPY
02_SIMULATION_RESULTS/01_MC200_TT_LOW_W4/csv/job_codes/MC200_CMP_XM5_XM6_W8P2524_XM7_XM11_W16P8587_S048_LOW_W4.csv | D:\PICO\A44_SAR_ADC_CURRENT_CACE_REPRODUCIBLE_20260728_R1\01_MC200_TT_LOW_W4\csv\job_codes\MC200_CMP_XM5_XM6_W8P2524_XM7_XM11_W16P8587_S048_LOW_W4.csv | D:\PICO\A44_SAR_ADC_CURRENT_CACE_REPRODUCIBLE_20260728_R2\02_SIMULATION_RESULTS\01_MC200_TT_LOW_W4\csv\job_codes\MC200_CMP_XM5_XM6_W8P2524_XM7_XM11_W16P8587_S048_LOW_W4.csv | 24248 | 24248 | b562d914b1a566f97277f2ddcc071a4c9ad99726ea71d162d9e9dfc4b2c4e77a | b562d914b1a566f97277f2ddcc071a4c9ad99726ea71d162d9e9dfc4b2c4e77a | EXACT_COPY
02_SIMULATION_RESULTS/01_MC200_TT_LOW_W4/csv/job_codes/MC200_CMP_XM5_XM6_W8P2524_XM7_XM11_W16P8587_S049_LOW_W4.csv | D:\PICO\A44_SAR_ADC_CURRENT_CACE_REPRODUCIBLE_20260728_R1\01_MC200_TT_LOW_W4\csv\job_codes\MC200_CMP_XM5_XM6_W8P2524_XM7_XM11_W16P8587_S049_LOW_W4.csv | D:\PICO\A44_SAR_ADC_CURRENT_CACE_REPRODUCIBLE_20260728_R2\02_SIMULATION_RESULTS\01_MC200_TT_LOW_W4\csv\job_codes\MC200_CMP_XM5_XM6_W8P2524_XM7_XM11_W16P8587_S049_LOW_W4.csv | 24251 | 24251 | 989c36fe10eb45b92ec6e72e534c77c60aeee8204afdb437328e9b7169f397b3 | 989c36fe10eb45b92ec6e72e534c77c60aeee8204afdb437328e9b7169f397b3 | EXACT_COPY
02_SIMULATION_RESULTS/01_MC200_TT_LOW_W4/csv/job_codes/MC200_CMP_XM5_XM6_W8P2524_XM7_XM11_W16P8587_S050_LOW_W4.csv | D:\PICO\A44_SAR_ADC_CURRENT_CACE_REPRODUCIBLE_20260728_R1\01_MC200_TT_LOW_W4\csv\job_codes\MC200_CMP_XM5_XM6_W8P2524_XM7_XM11_W16P8587_S050_LOW_W4.csv | D:\PICO\A44_SAR_ADC_CURRENT_CACE_REPRODUCIBLE_20260728_R2\02_SIMULATION_RESULTS\01_MC200_TT_LOW_W4\csv\job_codes\MC200_CMP_XM5_XM6_W8P2524_XM7_XM11_W16P8587_S050_LOW_W4.csv | 24249 | 24249 | fc2ba2ceaa6bea1472fa588221f38ca80cf24abbdee0d49138ac8bc8e7c1e561 | fc2ba2ceaa6bea1472fa588221f38ca80cf24abbdee0d49138ac8bc8e7c1e561 | EXACT_COPY
02_SIMULATION_RESULTS/01_MC200_TT_LOW_W4/csv/job_codes/MC200_CMP_XM5_XM6_W8P2524_XM7_XM11_W16P8587_S051_LOW_W4.csv | D:\PICO\A44_SAR_ADC_CURRENT_CACE_REPRODUCIBLE_20260728_R1\01_MC200_TT_LOW_W4\csv\job_codes\MC200_CMP_XM5_XM6_W8P2524_XM7_XM11_W16P8587_S051_LOW_W4.csv | D:\PICO\A44_SAR_ADC_CURRENT_CACE_REPRODUCIBLE_20260728_R2\02_SIMULATION_RESULTS\01_MC200_TT_LOW_W4\csv\job_codes\MC200_CMP_XM5_XM6_W8P2524_XM7_XM11_W16P8587_S051_LOW_W4.csv | 24249 | 24249 | 113635a878cd3e0f26d446d270e225b3d66992bb6efb11a49ce3c54701cf1bf4 | 113635a878cd3e0f26d446d270e225b3d66992bb6efb11a49ce3c54701cf1bf4 | EXACT_COPY
02_SIMULATION_RESULTS/01_MC200_TT_LOW_W4/csv/job_codes/MC200_CMP_XM5_XM6_W8P2524_XM7_XM11_W16P8587_S052_LOW_W4.csv | D:\PICO\A44_SAR_ADC_CURRENT_CACE_REPRODUCIBLE_20260728_R1\01_MC200_TT_LOW_W4\csv\job_codes\MC200_CMP_XM5_XM6_W8P2524_XM7_XM11_W16P8587_S052_LOW_W4.csv | D:\PICO\A44_SAR_ADC_CURRENT_CACE_REPRODUCIBLE_20260728_R2\02_SIMULATION_RESULTS\01_MC200_TT_LOW_W4\csv\job_codes\MC200_CMP_XM5_XM6_W8P2524_XM7_XM11_W16P8587_S052_LOW_W4.csv | 24253 | 24253 | eec83a510102c5b1cfaf957bbdde7daff7a347b39c929e0381943e99adff8295 | eec83a510102c5b1cfaf957bbdde7daff7a347b39c929e0381943e99adff8295 | EXACT_COPY
02_SIMULATION_RESULTS/01_MC200_TT_LOW_W4/csv/job_codes/MC200_CMP_XM5_XM6_W8P2524_XM7_XM11_W16P8587_S053_LOW_W4.csv | D:\PICO\A44_SAR_ADC_CURRENT_CACE_REPRODUCIBLE_20260728_R1\01_MC200_TT_LOW_W4\csv\job_codes\MC200_CMP_XM5_XM6_W8P2524_XM7_XM11_W16P8587_S053_LOW_W4.csv | D:\PICO\A44_SAR_ADC_CURRENT_CACE_REPRODUCIBLE_20260728_R2\02_SIMULATION_RESULTS\01_MC200_TT_LOW_W4\csv\job_codes\MC200_CMP_XM5_XM6_W8P2524_XM7_XM11_W16P8587_S053_LOW_W4.csv | 24258 | 24258 | da379f4e6a4501eb0dd05ecea8dd9c89fbb80017332d394972b17fe6823b6691 | da379f4e6a4501eb0dd05ecea8dd9c89fbb80017332d394972b17fe6823b6691 | EXACT_COPY
02_SIMULATION_RESULTS/01_MC200_TT_LOW_W4/csv/job_codes/MC200_CMP_XM5_XM6_W8P2524_XM7_XM11_W16P8587_S054_LOW_W4.csv | D:\PICO\A44_SAR_ADC_CURRENT_CACE_REPRODUCIBLE_20260728_R1\01_MC200_TT_LOW_W4\csv\job_codes\MC200_CMP_XM5_XM6_W8P2524_XM7_XM11_W16P8587_S054_LOW_W4.csv | D:\PICO\A44_SAR_ADC_CURRENT_CACE_REPRODUCIBLE_20260728_R2\02_SIMULATION_RESULTS\01_MC200_TT_LOW_W4\csv\job_codes\MC200_CMP_XM5_XM6_W8P2524_XM7_XM11_W16P8587_S054_LOW_W4.csv | 24260 | 24260 | 923c8b2a41954e2b148662b740fc0528131cd2e89c747d4ff9a44abcc76df586 | 923c8b2a41954e2b148662b740fc0528131cd2e89c747d4ff9a44abcc76df586 | EXACT_COPY
02_SIMULATION_RESULTS/01_MC200_TT_LOW_W4/csv/job_codes/MC200_CMP_XM5_XM6_W8P2524_XM7_XM11_W16P8587_S055_LOW_W4.csv | D:\PICO\A44_SAR_ADC_CURRENT_CACE_REPRODUCIBLE_20260728_R1\01_MC200_TT_LOW_W4\csv\job_codes\MC200_CMP_XM5_XM6_W8P2524_XM7_XM11_W16P8587_S055_LOW_W4.csv | D:\PICO\A44_SAR_ADC_CURRENT_CACE_REPRODUCIBLE_20260728_R2\02_SIMULATION_RESULTS\01_MC200_TT_LOW_W4\csv\job_codes\MC200_CMP_XM5_XM6_W8P2524_XM7_XM11_W16P8587_S055_LOW_W4.csv | 24258 | 24258 | 8fd978a47cb2b4fb4aed528abbd4764af0a93de56aa63e7de6de94dacf671991 | 8fd978a47cb2b4fb4aed528abbd4764af0a93de56aa63e7de6de94dacf671991 | EXACT_COPY
02_SIMULATION_RESULTS/01_MC200_TT_LOW_W4/csv/job_codes/MC200_CMP_XM5_XM6_W8P2524_XM7_XM11_W16P8587_S056_LOW_W4.csv | D:\PICO\A44_SAR_ADC_CURRENT_CACE_REPRODUCIBLE_20260728_R1\01_MC200_TT_LOW_W4\csv\job_codes\MC200_CMP_XM5_XM6_W8P2524_XM7_XM11_W16P8587_S056_LOW_W4.csv | D:\PICO\A44_SAR_ADC_CURRENT_CACE_REPRODUCIBLE_20260728_R2\02_SIMULATION_RESULTS\01_MC200_TT_LOW_W4\csv\job_codes\MC200_CMP_XM5_XM6_W8P2524_XM7_XM11_W16P8587_S056_LOW_W4.csv | 24261 | 24261 | 66fd22911742bbc672fa7d92c4119bade96c441528508ed8da487de3833fef54 | 66fd22911742bbc672fa7d92c4119bade96c441528508ed8da487de3833fef54 | EXACT_COPY
02_SIMULATION_RESULTS/01_MC200_TT_LOW_W4/csv/job_codes/MC200_CMP_XM5_XM6_W8P2524_XM7_XM11_W16P8587_S057_LOW_W4.csv | D:\PICO\A44_SAR_ADC_CURRENT_CACE_REPRODUCIBLE_20260728_R1\01_MC200_TT_LOW_W4\csv\job_codes\MC200_CMP_XM5_XM6_W8P2524_XM7_XM11_W16P8587_S057_LOW_W4.csv | D:\PICO\A44_SAR_ADC_CURRENT_CACE_REPRODUCIBLE_20260728_R2\02_SIMULATION_RESULTS\01_MC200_TT_LOW_W4\csv\job_codes\MC200_CMP_XM5_XM6_W8P2524_XM7_XM11_W16P8587_S057_LOW_W4.csv | 24249 | 24249 | bb1b924709132b76c90b37cc0acb3532da98361c07d478d98e58fb2df29ac685 | bb1b924709132b76c90b37cc0acb3532da98361c07d478d98e58fb2df29ac685 | EXACT_COPY
02_SIMULATION_RESULTS/01_MC200_TT_LOW_W4/csv/job_codes/MC200_CMP_XM5_XM6_W8P2524_XM7_XM11_W16P8587_S058_LOW_W4.csv | D:\PICO\A44_SAR_ADC_CURRENT_CACE_REPRODUCIBLE_20260728_R1\01_MC200_TT_LOW_W4\csv\job_codes\MC200_CMP_XM5_XM6_W8P2524_XM7_XM11_W16P8587_S058_LOW_W4.csv | D:\PICO\A44_SAR_ADC_CURRENT_CACE_REPRODUCIBLE_20260728_R2\02_SIMULATION_RESULTS\01_MC200_TT_LOW_W4\csv\job_codes\MC200_CMP_XM5_XM6_W8P2524_XM7_XM11_W16P8587_S058_LOW_W4.csv | 24243 | 24243 | dbbe8509e959b9ab39846ed5abe1ae0eae717c0c78720408952a4e0096e8ecbe | dbbe8509e959b9ab39846ed5abe1ae0eae717c0c78720408952a4e0096e8ecbe | EXACT_COPY
02_SIMULATION_RESULTS/01_MC200_TT_LOW_W4/csv/job_codes/MC200_CMP_XM5_XM6_W8P2524_XM7_XM11_W16P8587_S059_LOW_W4.csv | D:\PICO\A44_SAR_ADC_CURRENT_CACE_REPRODUCIBLE_20260728_R1\01_MC200_TT_LOW_W4\csv\job_codes\MC200_CMP_XM5_XM6_W8P2524_XM7_XM11_W16P8587_S059_LOW_W4.csv | D:\PICO\A44_SAR_ADC_CURRENT_CACE_REPRODUCIBLE_20260728_R2\02_SIMULATION_RESULTS\01_MC200_TT_LOW_W4\csv\job_codes\MC200_CMP_XM5_XM6_W8P2524_XM7_XM11_W16P8587_S059_LOW_W4.csv | 24258 | 24258 | fe19f6d00e23591896ee38ff92a17c5ce1471665e31d09e1f7037ca670eeea83 | fe19f6d00e23591896ee38ff92a17c5ce1471665e31d09e1f7037ca670eeea83 | EXACT_COPY
02_SIMULATION_RESULTS/01_MC200_TT_LOW_W4/csv/job_codes/MC200_CMP_XM5_XM6_W8P2524_XM7_XM11_W16P8587_S060_LOW_W4.csv | D:\PICO\A44_SAR_ADC_CURRENT_CACE_REPRODUCIBLE_20260728_R1\01_MC200_TT_LOW_W4\csv\job_codes\MC200_CMP_XM5_XM6_W8P2524_XM7_XM11_W16P8587_S060_LOW_W4.csv | D:\PICO\A44_SAR_ADC_CURRENT_CACE_REPRODUCIBLE_20260728_R2\02_SIMULATION_RESULTS\01_MC200_TT_LOW_W4\csv\job_codes\MC200_CMP_XM5_XM6_W8P2524_XM7_XM11_W16P8587_S060_LOW_W4.csv | 24249 | 24249 | 56a04cee9cd85583438532854ab41243bf3d8761e2573e5f02c87d6d1aaee88b | 56a04cee9cd85583438532854ab41243bf3d8761e2573e5f02c87d6d1aaee88b | EXACT_COPY
02_SIMULATION_RESULTS/01_MC200_TT_LOW_W4/csv/job_codes/MC200_CMP_XM5_XM6_W8P2524_XM7_XM11_W16P8587_S061_LOW_W4.csv | D:\PICO\A44_SAR_ADC_CURRENT_CACE_REPRODUCIBLE_20260728_R1\01_MC200_TT_LOW_W4\csv\job_codes\MC200_CMP_XM5_XM6_W8P2524_XM7_XM11_W16P8587_S061_LOW_W4.csv | D:\PICO\A44_SAR_ADC_CURRENT_CACE_REPRODUCIBLE_20260728_R2\02_SIMULATION_RESULTS\01_MC200_TT_LOW_W4\csv\job_codes\MC200_CMP_XM5_XM6_W8P2524_XM7_XM11_W16P8587_S061_LOW_W4.csv | 24248 | 24248 | c27c7abab36e9702f96fb89c17064f0e114b0a7c0ed50fe8e8764d895f4793be | c27c7abab36e9702f96fb89c17064f0e114b0a7c0ed50fe8e8764d895f4793be | EXACT_COPY
02_SIMULATION_RESULTS/01_MC200_TT_LOW_W4/csv/job_codes/MC200_CMP_XM5_XM6_W8P2524_XM7_XM11_W16P8587_S062_LOW_W4.csv | D:\PICO\A44_SAR_ADC_CURRENT_CACE_REPRODUCIBLE_20260728_R1\01_MC200_TT_LOW_W4\csv\job_codes\MC200_CMP_XM5_XM6_W8P2524_XM7_XM11_W16P8587_S062_LOW_W4.csv | D:\PICO\A44_SAR_ADC_CURRENT_CACE_REPRODUCIBLE_20260728_R2\02_SIMULATION_RESULTS\01_MC200_TT_LOW_W4\csv\job_codes\MC200_CMP_XM5_XM6_W8P2524_XM7_XM11_W16P8587_S062_LOW_W4.csv | 24249 | 24249 | 52741eb2335bbd37faa35afaa9ab5e52e7e54748062504358fe91140bc350885 | 52741eb2335bbd37faa35afaa9ab5e52e7e54748062504358fe91140bc350885 | EXACT_COPY
02_SIMULATION_RESULTS/01_MC200_TT_LOW_W4/csv/job_codes/MC200_CMP_XM5_XM6_W8P2524_XM7_XM11_W16P8587_S063_LOW_W4.csv | D:\PICO\A44_SAR_ADC_CURRENT_CACE_REPRODUCIBLE_20260728_R1\01_MC200_TT_LOW_W4\csv\job_codes\MC200_CMP_XM5_XM6_W8P2524_XM7_XM11_W16P8587_S063_LOW_W4.csv | D:\PICO\A44_SAR_ADC_CURRENT_CACE_REPRODUCIBLE_20260728_R2\02_SIMULATION_RESULTS\01_MC200_TT_LOW_W4\csv\job_codes\MC200_CMP_XM5_XM6_W8P2524_XM7_XM11_W16P8587_S063_LOW_W4.csv | 24260 | 24260 | a183436ee4fbdf3cc8976ed86510691906ac8bad1311e014c2b2ae9887a92dce | a183436ee4fbdf3cc8976ed86510691906ac8bad1311e014c2b2ae9887a92dce | EXACT_COPY
02_SIMULATION_RESULTS/01_MC200_TT_LOW_W4/csv/job_codes/MC200_CMP_XM5_XM6_W8P2524_XM7_XM11_W16P8587_S064_LOW_W4.csv | D:\PICO\A44_SAR_ADC_CURRENT_CACE_REPRODUCIBLE_20260728_R1\01_MC200_TT_LOW_W4\csv\job_codes\MC200_CMP_XM5_XM6_W8P2524_XM7_XM11_W16P8587_S064_LOW_W4.csv | D:\PICO\A44_SAR_ADC_CURRENT_CACE_REPRODUCIBLE_20260728_R2\02_SIMULATION_RESULTS\01_MC200_TT_LOW_W4\csv\job_codes\MC200_CMP_XM5_XM6_W8P2524_XM7_XM11_W16P8587_S064_LOW_W4.csv | 24255 | 24255 | 33cf92c46f64c5221f52d7441f48247c20d337a35f1050999b80054e6a071f69 | 33cf92c46f64c5221f52d7441f48247c20d337a35f1050999b80054e6a071f69 | EXACT_COPY
02_SIMULATION_RESULTS/01_MC200_TT_LOW_W4/csv/job_codes/MC200_CMP_XM5_XM6_W8P2524_XM7_XM11_W16P8587_S065_LOW_W4.csv | D:\PICO\A44_SAR_ADC_CURRENT_CACE_REPRODUCIBLE_20260728_R1\01_MC200_TT_LOW_W4\csv\job_codes\MC200_CMP_XM5_XM6_W8P2524_XM7_XM11_W16P8587_S065_LOW_W4.csv | D:\PICO\A44_SAR_ADC_CURRENT_CACE_REPRODUCIBLE_20260728_R2\02_SIMULATION_RESULTS\01_MC200_TT_LOW_W4\csv\job_codes\MC200_CMP_XM5_XM6_W8P2524_XM7_XM11_W16P8587_S065_LOW_W4.csv | 24246 | 24246 | 7ef627cab0eafbdbe0b6724748344659fe7dab946f248af4b119380ffa544f85 | 7ef627cab0eafbdbe0b6724748344659fe7dab946f248af4b119380ffa544f85 | EXACT_COPY
02_SIMULATION_RESULTS/01_MC200_TT_LOW_W4/csv/job_codes/MC200_CMP_XM5_XM6_W8P2524_XM7_XM11_W16P8587_S066_LOW_W4.csv | D:\PICO\A44_SAR_ADC_CURRENT_CACE_REPRODUCIBLE_20260728_R1\01_MC200_TT_LOW_W4\csv\job_codes\MC200_CMP_XM5_XM6_W8P2524_XM7_XM11_W16P8587_S066_LOW_W4.csv | D:\PICO\A44_SAR_ADC_CURRENT_CACE_REPRODUCIBLE_20260728_R2\02_SIMULATION_RESULTS\01_MC200_TT_LOW_W4\csv\job_codes\MC200_CMP_XM5_XM6_W8P2524_XM7_XM11_W16P8587_S066_LOW_W4.csv | 24249 | 24249 | 5b38d04069feb700433c46bc914cea256e27096cbfa15e2e1f218afa40c368ef | 5b38d04069feb700433c46bc914cea256e27096cbfa15e2e1f218afa40c368ef | EXACT_COPY
02_SIMULATION_RESULTS/01_MC200_TT_LOW_W4/csv/job_codes/MC200_CMP_XM5_XM6_W8P2524_XM7_XM11_W16P8587_S067_LOW_W4.csv | D:\PICO\A44_SAR_ADC_CURRENT_CACE_REPRODUCIBLE_20260728_R1\01_MC200_TT_LOW_W4\csv\job_codes\MC200_CMP_XM5_XM6_W8P2524_XM7_XM11_W16P8587_S067_LOW_W4.csv | D:\PICO\A44_SAR_ADC_CURRENT_CACE_REPRODUCIBLE_20260728_R2\02_SIMULATION_RESULTS\01_MC200_TT_LOW_W4\csv\job_codes\MC200_CMP_XM5_XM6_W8P2524_XM7_XM11_W16P8587_S067_LOW_W4.csv | 24259 | 24259 | 0e6a9c427e1686b98d9e57a971e99629fd8167b37004b6c40cae7143337764c6 | 0e6a9c427e1686b98d9e57a971e99629fd8167b37004b6c40cae7143337764c6 | EXACT_COPY
02_SIMULATION_RESULTS/01_MC200_TT_LOW_W4/csv/job_codes/MC200_CMP_XM5_XM6_W8P2524_XM7_XM11_W16P8587_S068_LOW_W4.csv | D:\PICO\A44_SAR_ADC_CURRENT_CACE_REPRODUCIBLE_20260728_R1\01_MC200_TT_LOW_W4\csv\job_codes\MC200_CMP_XM5_XM6_W8P2524_XM7_XM11_W16P8587_S068_LOW_W4.csv | D:\PICO\A44_SAR_ADC_CURRENT_CACE_REPRODUCIBLE_20260728_R2\02_SIMULATION_RESULTS\01_MC200_TT_LOW_W4\csv\job_codes\MC200_CMP_XM5_XM6_W8P2524_XM7_XM11_W16P8587_S068_LOW_W4.csv | 24246 | 24246 | 12147e58cccffdefa63508ae90fe532b2f12e64a97a50cfb0515389c86c475cd | 12147e58cccffdefa63508ae90fe532b2f12e64a97a50cfb0515389c86c475cd | EXACT_COPY
02_SIMULATION_RESULTS/01_MC200_TT_LOW_W4/csv/job_codes/MC200_CMP_XM5_XM6_W8P2524_XM7_XM11_W16P8587_S069_LOW_W4.csv | D:\PICO\A44_SAR_ADC_CURRENT_CACE_REPRODUCIBLE_20260728_R1\01_MC200_TT_LOW_W4\csv\job_codes\MC200_CMP_XM5_XM6_W8P2524_XM7_XM11_W16P8587_S069_LOW_W4.csv | D:\PICO\A44_SAR_ADC_CURRENT_CACE_REPRODUCIBLE_20260728_R2\02_SIMULATION_RESULTS\01_MC200_TT_LOW_W4\csv\job_codes\MC200_CMP_XM5_XM6_W8P2524_XM7_XM11_W16P8587_S069_LOW_W4.csv | 24243 | 24243 | e362e6a6ad0a606f995524bd8918ec3d1cbec667c443e04ff2f3c8a648ab70b7 | e362e6a6ad0a606f995524bd8918ec3d1cbec667c443e04ff2f3c8a648ab70b7 | EXACT_COPY
02_SIMULATION_RESULTS/01_MC200_TT_LOW_W4/csv/job_codes/MC200_CMP_XM5_XM6_W8P2524_XM7_XM11_W16P8587_S070_LOW_W4.csv | D:\PICO\A44_SAR_ADC_CURRENT_CACE_REPRODUCIBLE_20260728_R1\01_MC200_TT_LOW_W4\csv\job_codes\MC200_CMP_XM5_XM6_W8P2524_XM7_XM11_W16P8587_S070_LOW_W4.csv | D:\PICO\A44_SAR_ADC_CURRENT_CACE_REPRODUCIBLE_20260728_R2\02_SIMULATION_RESULTS\01_MC200_TT_LOW_W4\csv\job_codes\MC200_CMP_XM5_XM6_W8P2524_XM7_XM11_W16P8587_S070_LOW_W4.csv | 24258 | 24258 | 97cff17596b55c35c4d2ac5962461a9df58e74fa0a9853fccfad2b20ead80e48 | 97cff17596b55c35c4d2ac5962461a9df58e74fa0a9853fccfad2b20ead80e48 | EXACT_COPY
02_SIMULATION_RESULTS/01_MC200_TT_LOW_W4/csv/job_codes/MC200_CMP_XM5_XM6_W8P2524_XM7_XM11_W16P8587_S071_LOW_W4.csv | D:\PICO\A44_SAR_ADC_CURRENT_CACE_REPRODUCIBLE_20260728_R1\01_MC200_TT_LOW_W4\csv\job_codes\MC200_CMP_XM5_XM6_W8P2524_XM7_XM11_W16P8587_S071_LOW_W4.csv | D:\PICO\A44_SAR_ADC_CURRENT_CACE_REPRODUCIBLE_20260728_R2\02_SIMULATION_RESULTS\01_MC200_TT_LOW_W4\csv\job_codes\MC200_CMP_XM5_XM6_W8P2524_XM7_XM11_W16P8587_S071_LOW_W4.csv | 24256 | 24256 | 26d11e046370816fb6e49564d824114ec44ae568f48820368c066c4591ebe05d | 26d11e046370816fb6e49564d824114ec44ae568f48820368c066c4591ebe05d | EXACT_COPY
02_SIMULATION_RESULTS/01_MC200_TT_LOW_W4/csv/job_codes/MC200_CMP_XM5_XM6_W8P2524_XM7_XM11_W16P8587_S072_LOW_W4.csv | D:\PICO\A44_SAR_ADC_CURRENT_CACE_REPRODUCIBLE_20260728_R1\01_MC200_TT_LOW_W4\csv\job_codes\MC200_CMP_XM5_XM6_W8P2524_XM7_XM11_W16P8587_S072_LOW_W4.csv | D:\PICO\A44_SAR_ADC_CURRENT_CACE_REPRODUCIBLE_20260728_R2\02_SIMULATION_RESULTS\01_MC200_TT_LOW_W4\csv\job_codes\MC200_CMP_XM5_XM6_W8P2524_XM7_XM11_W16P8587_S072_LOW_W4.csv | 24261 | 24261 | c663fbbff0e6287bcc67cc8cac83ddfd5b8a210339531b50caceb87af3b8bea6 | c663fbbff0e6287bcc67cc8cac83ddfd5b8a210339531b50caceb87af3b8bea6 | EXACT_COPY
02_SIMULATION_RESULTS/01_MC200_TT_LOW_W4/csv/job_codes/MC200_CMP_XM5_XM6_W8P2524_XM7_XM11_W16P8587_S073_LOW_W4.csv | D:\PICO\A44_SAR_ADC_CURRENT_CACE_REPRODUCIBLE_20260728_R1\01_MC200_TT_LOW_W4\csv\job_codes\MC200_CMP_XM5_XM6_W8P2524_XM7_XM11_W16P8587_S073_LOW_W4.csv | D:\PICO\A44_SAR_ADC_CURRENT_CACE_REPRODUCIBLE_20260728_R2\02_SIMULATION_RESULTS\01_MC200_TT_LOW_W4\csv\job_codes\MC200_CMP_XM5_XM6_W8P2524_XM7_XM11_W16P8587_S073_LOW_W4.csv | 24251 | 24251 | 212caff3474a4e16d98f88cc0e2b61df26c0a06c3655beb3c1561a16306449c1 | 212caff3474a4e16d98f88cc0e2b61df26c0a06c3655beb3c1561a16306449c1 | EXACT_COPY
02_SIMULATION_RESULTS/01_MC200_TT_LOW_W4/csv/job_codes/MC200_CMP_XM5_XM6_W8P2524_XM7_XM11_W16P8587_S074_LOW_W4.csv | D:\PICO\A44_SAR_ADC_CURRENT_CACE_REPRODUCIBLE_20260728_R1\01_MC200_TT_LOW_W4\csv\job_codes\MC200_CMP_XM5_XM6_W8P2524_XM7_XM11_W16P8587_S074_LOW_W4.csv | D:\PICO\A44_SAR_ADC_CURRENT_CACE_REPRODUCIBLE_20260728_R2\02_SIMULATION_RESULTS\01_MC200_TT_LOW_W4\csv\job_codes\MC200_CMP_XM5_XM6_W8P2524_XM7_XM11_W16P8587_S074_LOW_W4.csv | 24255 | 24255 | 269cb4541cdd1ff57a18fd9f7ab1d04df02903e35f4ad70a36bf0726ef08ee87 | 269cb4541cdd1ff57a18fd9f7ab1d04df02903e35f4ad70a36bf0726ef08ee87 | EXACT_COPY
02_SIMULATION_RESULTS/01_MC200_TT_LOW_W4/csv/job_codes/MC200_CMP_XM5_XM6_W8P2524_XM7_XM11_W16P8587_S075_LOW_W4.csv | D:\PICO\A44_SAR_ADC_CURRENT_CACE_REPRODUCIBLE_20260728_R1\01_MC200_TT_LOW_W4\csv\job_codes\MC200_CMP_XM5_XM6_W8P2524_XM7_XM11_W16P8587_S075_LOW_W4.csv | D:\PICO\A44_SAR_ADC_CURRENT_CACE_REPRODUCIBLE_20260728_R2\02_SIMULATION_RESULTS\01_MC200_TT_LOW_W4\csv\job_codes\MC200_CMP_XM5_XM6_W8P2524_XM7_XM11_W16P8587_S075_LOW_W4.csv | 24257 | 24257 | 248c39a87dae1610753c3cd86057c56e1226f8c39e7adb17b747263369053b03 | 248c39a87dae1610753c3cd86057c56e1226f8c39e7adb17b747263369053b03 | EXACT_COPY
02_SIMULATION_RESULTS/01_MC200_TT_LOW_W4/csv/job_codes/MC200_CMP_XM5_XM6_W8P2524_XM7_XM11_W16P8587_S076_LOW_W4.csv | D:\PICO\A44_SAR_ADC_CURRENT_CACE_REPRODUCIBLE_20260728_R1\01_MC200_TT_LOW_W4\csv\job_codes\MC200_CMP_XM5_XM6_W8P2524_XM7_XM11_W16P8587_S076_LOW_W4.csv | D:\PICO\A44_SAR_ADC_CURRENT_CACE_REPRODUCIBLE_20260728_R2\02_SIMULATION_RESULTS\01_MC200_TT_LOW_W4\csv\job_codes\MC200_CMP_XM5_XM6_W8P2524_XM7_XM11_W16P8587_S076_LOW_W4.csv | 24250 | 24250 | 03a5b941039339aef9d1908ae3965d4a69b3f60f80ccddca5ed5bb3b1dbb9ef5 | 03a5b941039339aef9d1908ae3965d4a69b3f60f80ccddca5ed5bb3b1dbb9ef5 | EXACT_COPY
02_SIMULATION_RESULTS/01_MC200_TT_LOW_W4/csv/job_codes/MC200_CMP_XM5_XM6_W8P2524_XM7_XM11_W16P8587_S077_LOW_W4.csv | D:\PICO\A44_SAR_ADC_CURRENT_CACE_REPRODUCIBLE_20260728_R1\01_MC200_TT_LOW_W4\csv\job_codes\MC200_CMP_XM5_XM6_W8P2524_XM7_XM11_W16P8587_S077_LOW_W4.csv | D:\PICO\A44_SAR_ADC_CURRENT_CACE_REPRODUCIBLE_20260728_R2\02_SIMULATION_RESULTS\01_MC200_TT_LOW_W4\csv\job_codes\MC200_CMP_XM5_XM6_W8P2524_XM7_XM11_W16P8587_S077_LOW_W4.csv | 24253 | 24253 | e619d16515cb3a809098e5d48f7dfea956bdea716c540fba19a03125c79372ce | e619d16515cb3a809098e5d48f7dfea956bdea716c540fba19a03125c79372ce | EXACT_COPY
02_SIMULATION_RESULTS/01_MC200_TT_LOW_W4/csv/job_codes/MC200_CMP_XM5_XM6_W8P2524_XM7_XM11_W16P8587_S078_LOW_W4.csv | D:\PICO\A44_SAR_ADC_CURRENT_CACE_REPRODUCIBLE_20260728_R1\01_MC200_TT_LOW_W4\csv\job_codes\MC200_CMP_XM5_XM6_W8P2524_XM7_XM11_W16P8587_S078_LOW_W4.csv | D:\PICO\A44_SAR_ADC_CURRENT_CACE_REPRODUCIBLE_20260728_R2\02_SIMULATION_RESULTS\01_MC200_TT_LOW_W4\csv\job_codes\MC200_CMP_XM5_XM6_W8P2524_XM7_XM11_W16P8587_S078_LOW_W4.csv | 24254 | 24254 | 96634235fa7366df83e95618a36cda852581f02563f8ce9e787175161b694192 | 96634235fa7366df83e95618a36cda852581f02563f8ce9e787175161b694192 | EXACT_COPY
02_SIMULATION_RESULTS/01_MC200_TT_LOW_W4/csv/job_codes/MC200_CMP_XM5_XM6_W8P2524_XM7_XM11_W16P8587_S079_LOW_W4.csv | D:\PICO\A44_SAR_ADC_CURRENT_CACE_REPRODUCIBLE_20260728_R1\01_MC200_TT_LOW_W4\csv\job_codes\MC200_CMP_XM5_XM6_W8P2524_XM7_XM11_W16P8587_S079_LOW_W4.csv | D:\PICO\A44_SAR_ADC_CURRENT_CACE_REPRODUCIBLE_20260728_R2\02_SIMULATION_RESULTS\01_MC200_TT_LOW_W4\csv\job_codes\MC200_CMP_XM5_XM6_W8P2524_XM7_XM11_W16P8587_S079_LOW_W4.csv | 24251 | 24251 | c4656d53c808ed6e5c5790d87a463f20a141c46be58b2193eb884879f36c4c2d | c4656d53c808ed6e5c5790d87a463f20a141c46be58b2193eb884879f36c4c2d | EXACT_COPY
02_SIMULATION_RESULTS/01_MC200_TT_LOW_W4/csv/job_codes/MC200_CMP_XM5_XM6_W8P2524_XM7_XM11_W16P8587_S080_LOW_W4.csv | D:\PICO\A44_SAR_ADC_CURRENT_CACE_REPRODUCIBLE_20260728_R1\01_MC200_TT_LOW_W4\csv\job_codes\MC200_CMP_XM5_XM6_W8P2524_XM7_XM11_W16P8587_S080_LOW_W4.csv | D:\PICO\A44_SAR_ADC_CURRENT_CACE_REPRODUCIBLE_20260728_R2\02_SIMULATION_RESULTS\01_MC200_TT_LOW_W4\csv\job_codes\MC200_CMP_XM5_XM6_W8P2524_XM7_XM11_W16P8587_S080_LOW_W4.csv | 24252 | 24252 | 5bcbe2fd4b4c6d90b9130e0beed1de022fd9162abb6e9270ef8ed6657b5d38a6 | 5bcbe2fd4b4c6d90b9130e0beed1de022fd9162abb6e9270ef8ed6657b5d38a6 | EXACT_COPY
02_SIMULATION_RESULTS/01_MC200_TT_LOW_W4/csv/job_codes/MC200_CMP_XM5_XM6_W8P2524_XM7_XM11_W16P8587_S081_LOW_W4.csv | D:\PICO\A44_SAR_ADC_CURRENT_CACE_REPRODUCIBLE_20260728_R1\01_MC200_TT_LOW_W4\csv\job_codes\MC200_CMP_XM5_XM6_W8P2524_XM7_XM11_W16P8587_S081_LOW_W4.csv | D:\PICO\A44_SAR_ADC_CURRENT_CACE_REPRODUCIBLE_20260728_R2\02_SIMULATION_RESULTS\01_MC200_TT_LOW_W4\csv\job_codes\MC200_CMP_XM5_XM6_W8P2524_XM7_XM11_W16P8587_S081_LOW_W4.csv | 24249 | 24249 | 8b9bad035c4bab4eed35b9831fd80d45d4ebfb52196bcb21badc4dfb1d835879 | 8b9bad035c4bab4eed35b9831fd80d45d4ebfb52196bcb21badc4dfb1d835879 | EXACT_COPY
02_SIMULATION_RESULTS/01_MC200_TT_LOW_W4/csv/job_codes/MC200_CMP_XM5_XM6_W8P2524_XM7_XM11_W16P8587_S082_LOW_W4.csv | D:\PICO\A44_SAR_ADC_CURRENT_CACE_REPRODUCIBLE_20260728_R1\01_MC200_TT_LOW_W4\csv\job_codes\MC200_CMP_XM5_XM6_W8P2524_XM7_XM11_W16P8587_S082_LOW_W4.csv | D:\PICO\A44_SAR_ADC_CURRENT_CACE_REPRODUCIBLE_20260728_R2\02_SIMULATION_RESULTS\01_MC200_TT_LOW_W4\csv\job_codes\MC200_CMP_XM5_XM6_W8P2524_XM7_XM11_W16P8587_S082_LOW_W4.csv | 24252 | 24252 | dffdc2a1716dd8df44ff08aa03e7279d3c234593bb699f1c30ccc794a87efc7c | dffdc2a1716dd8df44ff08aa03e7279d3c234593bb699f1c30ccc794a87efc7c | EXACT_COPY
02_SIMULATION_RESULTS/01_MC200_TT_LOW_W4/csv/job_codes/MC200_CMP_XM5_XM6_W8P2524_XM7_XM11_W16P8587_S083_LOW_W4.csv | D:\PICO\A44_SAR_ADC_CURRENT_CACE_REPRODUCIBLE_20260728_R1\01_MC200_TT_LOW_W4\csv\job_codes\MC200_CMP_XM5_XM6_W8P2524_XM7_XM11_W16P8587_S083_LOW_W4.csv | D:\PICO\A44_SAR_ADC_CURRENT_CACE_REPRODUCIBLE_20260728_R2\02_SIMULATION_RESULTS\01_MC200_TT_LOW_W4\csv\job_codes\MC200_CMP_XM5_XM6_W8P2524_XM7_XM11_W16P8587_S083_LOW_W4.csv | 24250 | 24250 | 4df10e86020d932d377a603c11b2560977457654c4caeb85f11bc42b771c3a4d | 4df10e86020d932d377a603c11b2560977457654c4caeb85f11bc42b771c3a4d | EXACT_COPY
02_SIMULATION_RESULTS/01_MC200_TT_LOW_W4/csv/job_codes/MC200_CMP_XM5_XM6_W8P2524_XM7_XM11_W16P8587_S084_LOW_W4.csv | D:\PICO\A44_SAR_ADC_CURRENT_CACE_REPRODUCIBLE_20260728_R1\01_MC200_TT_LOW_W4\csv\job_codes\MC200_CMP_XM5_XM6_W8P2524_XM7_XM11_W16P8587_S084_LOW_W4.csv | D:\PICO\A44_SAR_ADC_CURRENT_CACE_REPRODUCIBLE_20260728_R2\02_SIMULATION_RESULTS\01_MC200_TT_LOW_W4\csv\job_codes\MC200_CMP_XM5_XM6_W8P2524_XM7_XM11_W16P8587_S084_LOW_W4.csv | 24250 | 24250 | e54566d84b480f71588f3a5d69c6c16931208d92692c261e84d581d37671a14c | e54566d84b480f71588f3a5d69c6c16931208d92692c261e84d581d37671a14c | EXACT_COPY
02_SIMULATION_RESULTS/01_MC200_TT_LOW_W4/csv/job_codes/MC200_CMP_XM5_XM6_W8P2524_XM7_XM11_W16P8587_S085_LOW_W4.csv | D:\PICO\A44_SAR_ADC_CURRENT_CACE_REPRODUCIBLE_20260728_R1\01_MC200_TT_LOW_W4\csv\job_codes\MC200_CMP_XM5_XM6_W8P2524_XM7_XM11_W16P8587_S085_LOW_W4.csv | D:\PICO\A44_SAR_ADC_CURRENT_CACE_REPRODUCIBLE_20260728_R2\02_SIMULATION_RESULTS\01_MC200_TT_LOW_W4\csv\job_codes\MC200_CMP_XM5_XM6_W8P2524_XM7_XM11_W16P8587_S085_LOW_W4.csv | 24247 | 24247 | 3b473b24ecbf7bf155c4a9bf559bb536503dbb4a39b2ea7c61368e0ae8a56f42 | 3b473b24ecbf7bf155c4a9bf559bb536503dbb4a39b2ea7c61368e0ae8a56f42 | EXACT_COPY
02_SIMULATION_RESULTS/01_MC200_TT_LOW_W4/csv/job_codes/MC200_CMP_XM5_XM6_W8P2524_XM7_XM11_W16P8587_S086_LOW_W4.csv | D:\PICO\A44_SAR_ADC_CURRENT_CACE_REPRODUCIBLE_20260728_R1\01_MC200_TT_LOW_W4\csv\job_codes\MC200_CMP_XM5_XM6_W8P2524_XM7_XM11_W16P8587_S086_LOW_W4.csv | D:\PICO\A44_SAR_ADC_CURRENT_CACE_REPRODUCIBLE_20260728_R2\02_SIMULATION_RESULTS\01_MC200_TT_LOW_W4\csv\job_codes\MC200_CMP_XM5_XM6_W8P2524_XM7_XM11_W16P8587_S086_LOW_W4.csv | 24249 | 24249 | 9bd228ba7723850b5cd54cb4a999000b7e179f19df22385e28f22e316c40d3a6 | 9bd228ba7723850b5cd54cb4a999000b7e179f19df22385e28f22e316c40d3a6 | EXACT_COPY
02_SIMULATION_RESULTS/01_MC200_TT_LOW_W4/csv/job_codes/MC200_CMP_XM5_XM6_W8P2524_XM7_XM11_W16P8587_S087_LOW_W4.csv | D:\PICO\A44_SAR_ADC_CURRENT_CACE_REPRODUCIBLE_20260728_R1\01_MC200_TT_LOW_W4\csv\job_codes\MC200_CMP_XM5_XM6_W8P2524_XM7_XM11_W16P8587_S087_LOW_W4.csv | D:\PICO\A44_SAR_ADC_CURRENT_CACE_REPRODUCIBLE_20260728_R2\02_SIMULATION_RESULTS\01_MC200_TT_LOW_W4\csv\job_codes\MC200_CMP_XM5_XM6_W8P2524_XM7_XM11_W16P8587_S087_LOW_W4.csv | 24254 | 24254 | 793675317ca82ae5996f38e7e464bfd200bcd19f484a905450c94ca190c7a634 | 793675317ca82ae5996f38e7e464bfd200bcd19f484a905450c94ca190c7a634 | EXACT_COPY
02_SIMULATION_RESULTS/01_MC200_TT_LOW_W4/csv/job_codes/MC200_CMP_XM5_XM6_W8P2524_XM7_XM11_W16P8587_S088_LOW_W4.csv | D:\PICO\A44_SAR_ADC_CURRENT_CACE_REPRODUCIBLE_20260728_R1\01_MC200_TT_LOW_W4\csv\job_codes\MC200_CMP_XM5_XM6_W8P2524_XM7_XM11_W16P8587_S088_LOW_W4.csv | D:\PICO\A44_SAR_ADC_CURRENT_CACE_REPRODUCIBLE_20260728_R2\02_SIMULATION_RESULTS\01_MC200_TT_LOW_W4\csv\job_codes\MC200_CMP_XM5_XM6_W8P2524_XM7_XM11_W16P8587_S088_LOW_W4.csv | 24258 | 24258 | f4aaf86483c19cb4992b96030dfb09bf1b62274c471e7d54c8aca207b258f54f | f4aaf86483c19cb4992b96030dfb09bf1b62274c471e7d54c8aca207b258f54f | EXACT_COPY
02_SIMULATION_RESULTS/01_MC200_TT_LOW_W4/csv/job_codes/MC200_CMP_XM5_XM6_W8P2524_XM7_XM11_W16P8587_S089_LOW_W4.csv | D:\PICO\A44_SAR_ADC_CURRENT_CACE_REPRODUCIBLE_20260728_R1\01_MC200_TT_LOW_W4\csv\job_codes\MC200_CMP_XM5_XM6_W8P2524_XM7_XM11_W16P8587_S089_LOW_W4.csv | D:\PICO\A44_SAR_ADC_CURRENT_CACE_REPRODUCIBLE_20260728_R2\02_SIMULATION_RESULTS\01_MC200_TT_LOW_W4\csv\job_codes\MC200_CMP_XM5_XM6_W8P2524_XM7_XM11_W16P8587_S089_LOW_W4.csv | 24246 | 24246 | cc3df2dacdb76957246fcc5ac9966e860abcf6d0e2b14e011572a87a051466ed | cc3df2dacdb76957246fcc5ac9966e860abcf6d0e2b14e011572a87a051466ed | EXACT_COPY
02_SIMULATION_RESULTS/01_MC200_TT_LOW_W4/csv/job_codes/MC200_CMP_XM5_XM6_W8P2524_XM7_XM11_W16P8587_S090_LOW_W4.csv | D:\PICO\A44_SAR_ADC_CURRENT_CACE_REPRODUCIBLE_20260728_R1\01_MC200_TT_LOW_W4\csv\job_codes\MC200_CMP_XM5_XM6_W8P2524_XM7_XM11_W16P8587_S090_LOW_W4.csv | D:\PICO\A44_SAR_ADC_CURRENT_CACE_REPRODUCIBLE_20260728_R2\02_SIMULATION_RESULTS\01_MC200_TT_LOW_W4\csv\job_codes\MC200_CMP_XM5_XM6_W8P2524_XM7_XM11_W16P8587_S090_LOW_W4.csv | 24239 | 24239 | ed355e8a67adfe0cf6f4d36d890370545b820585a7cbd3672e259821518e5109 | ed355e8a67adfe0cf6f4d36d890370545b820585a7cbd3672e259821518e5109 | EXACT_COPY
02_SIMULATION_RESULTS/01_MC200_TT_LOW_W4/csv/job_codes/MC200_CMP_XM5_XM6_W8P2524_XM7_XM11_W16P8587_S091_LOW_W4.csv | D:\PICO\A44_SAR_ADC_CURRENT_CACE_REPRODUCIBLE_20260728_R1\01_MC200_TT_LOW_W4\csv\job_codes\MC200_CMP_XM5_XM6_W8P2524_XM7_XM11_W16P8587_S091_LOW_W4.csv | D:\PICO\A44_SAR_ADC_CURRENT_CACE_REPRODUCIBLE_20260728_R2\02_SIMULATION_RESULTS\01_MC200_TT_LOW_W4\csv\job_codes\MC200_CMP_XM5_XM6_W8P2524_XM7_XM11_W16P8587_S091_LOW_W4.csv | 24245 | 24245 | 9aa303aa29466e78ba1b0bc52f7a23ff1717b09f181617323c186fcf455b449c | 9aa303aa29466e78ba1b0bc52f7a23ff1717b09f181617323c186fcf455b449c | EXACT_COPY
02_SIMULATION_RESULTS/01_MC200_TT_LOW_W4/csv/job_codes/MC200_CMP_XM5_XM6_W8P2524_XM7_XM11_W16P8587_S092_LOW_W4.csv | D:\PICO\A44_SAR_ADC_CURRENT_CACE_REPRODUCIBLE_20260728_R1\01_MC200_TT_LOW_W4\csv\job_codes\MC200_CMP_XM5_XM6_W8P2524_XM7_XM11_W16P8587_S092_LOW_W4.csv | D:\PICO\A44_SAR_ADC_CURRENT_CACE_REPRODUCIBLE_20260728_R2\02_SIMULATION_RESULTS\01_MC200_TT_LOW_W4\csv\job_codes\MC200_CMP_XM5_XM6_W8P2524_XM7_XM11_W16P8587_S092_LOW_W4.csv | 24256 | 24256 | 3fa5c0a43dc911d0e2688a3d31e77e5f6ab58d093c1cae0a9c33d171665d5542 | 3fa5c0a43dc911d0e2688a3d31e77e5f6ab58d093c1cae0a9c33d171665d5542 | EXACT_COPY
02_SIMULATION_RESULTS/01_MC200_TT_LOW_W4/csv/job_codes/MC200_CMP_XM5_XM6_W8P2524_XM7_XM11_W16P8587_S093_LOW_W4.csv | D:\PICO\A44_SAR_ADC_CURRENT_CACE_REPRODUCIBLE_20260728_R1\01_MC200_TT_LOW_W4\csv\job_codes\MC200_CMP_XM5_XM6_W8P2524_XM7_XM11_W16P8587_S093_LOW_W4.csv | D:\PICO\A44_SAR_ADC_CURRENT_CACE_REPRODUCIBLE_20260728_R2\02_SIMULATION_RESULTS\01_MC200_TT_LOW_W4\csv\job_codes\MC200_CMP_XM5_XM6_W8P2524_XM7_XM11_W16P8587_S093_LOW_W4.csv | 24238 | 24238 | af6182faca6a5b4d90f329c8a3dac179a37f80a33f537f8aeefc6c10aaf16271 | af6182faca6a5b4d90f329c8a3dac179a37f80a33f537f8aeefc6c10aaf16271 | EXACT_COPY
02_SIMULATION_RESULTS/01_MC200_TT_LOW_W4/csv/job_codes/MC200_CMP_XM5_XM6_W8P2524_XM7_XM11_W16P8587_S094_LOW_W4.csv | D:\PICO\A44_SAR_ADC_CURRENT_CACE_REPRODUCIBLE_20260728_R1\01_MC200_TT_LOW_W4\csv\job_codes\MC200_CMP_XM5_XM6_W8P2524_XM7_XM11_W16P8587_S094_LOW_W4.csv | D:\PICO\A44_SAR_ADC_CURRENT_CACE_REPRODUCIBLE_20260728_R2\02_SIMULATION_RESULTS\01_MC200_TT_LOW_W4\csv\job_codes\MC200_CMP_XM5_XM6_W8P2524_XM7_XM11_W16P8587_S094_LOW_W4.csv | 24253 | 24253 | 52b2608d9bbf73dc31f510d6c2d24b2a20213c2c951fc14d80ff6f6b0fdb02be | 52b2608d9bbf73dc31f510d6c2d24b2a20213c2c951fc14d80ff6f6b0fdb02be | EXACT_COPY
02_SIMULATION_RESULTS/01_MC200_TT_LOW_W4/csv/job_codes/MC200_CMP_XM5_XM6_W8P2524_XM7_XM11_W16P8587_S095_LOW_W4.csv | D:\PICO\A44_SAR_ADC_CURRENT_CACE_REPRODUCIBLE_20260728_R1\01_MC200_TT_LOW_W4\csv\job_codes\MC200_CMP_XM5_XM6_W8P2524_XM7_XM11_W16P8587_S095_LOW_W4.csv | D:\PICO\A44_SAR_ADC_CURRENT_CACE_REPRODUCIBLE_20260728_R2\02_SIMULATION_RESULTS\01_MC200_TT_LOW_W4\csv\job_codes\MC200_CMP_XM5_XM6_W8P2524_XM7_XM11_W16P8587_S095_LOW_W4.csv | 24249 | 24249 | 7b988cb6f2cf6be3731acc0dab6505cdf85f62ebc09cb60db21c685c3a3bf517 | 7b988cb6f2cf6be3731acc0dab6505cdf85f62ebc09cb60db21c685c3a3bf517 | EXACT_COPY
02_SIMULATION_RESULTS/01_MC200_TT_LOW_W4/csv/job_codes/MC200_CMP_XM5_XM6_W8P2524_XM7_XM11_W16P8587_S096_LOW_W4.csv | D:\PICO\A44_SAR_ADC_CURRENT_CACE_REPRODUCIBLE_20260728_R1\01_MC200_TT_LOW_W4\csv\job_codes\MC200_CMP_XM5_XM6_W8P2524_XM7_XM11_W16P8587_S096_LOW_W4.csv | D:\PICO\A44_SAR_ADC_CURRENT_CACE_REPRODUCIBLE_20260728_R2\02_SIMULATION_RESULTS\01_MC200_TT_LOW_W4\csv\job_codes\MC200_CMP_XM5_XM6_W8P2524_XM7_XM11_W16P8587_S096_LOW_W4.csv | 24255 | 24255 | b2965a511c76abaef85d4334fa48f69bc59b67373f699d06ca9957e7a176865a | b2965a511c76abaef85d4334fa48f69bc59b67373f699d06ca9957e7a176865a | EXACT_COPY
02_SIMULATION_RESULTS/01_MC200_TT_LOW_W4/csv/job_codes/MC200_CMP_XM5_XM6_W8P2524_XM7_XM11_W16P8587_S097_LOW_W4.csv | D:\PICO\A44_SAR_ADC_CURRENT_CACE_REPRODUCIBLE_20260728_R1\01_MC200_TT_LOW_W4\csv\job_codes\MC200_CMP_XM5_XM6_W8P2524_XM7_XM11_W16P8587_S097_LOW_W4.csv | D:\PICO\A44_SAR_ADC_CURRENT_CACE_REPRODUCIBLE_20260728_R2\02_SIMULATION_RESULTS\01_MC200_TT_LOW_W4\csv\job_codes\MC200_CMP_XM5_XM6_W8P2524_XM7_XM11_W16P8587_S097_LOW_W4.csv | 24242 | 24242 | 01ba531c79e5934bf017be0804f4c0c9aa0a1762800e4af5a902b393576f97e3 | 01ba531c79e5934bf017be0804f4c0c9aa0a1762800e4af5a902b393576f97e3 | EXACT_COPY
02_SIMULATION_RESULTS/01_MC200_TT_LOW_W4/csv/job_codes/MC200_CMP_XM5_XM6_W8P2524_XM7_XM11_W16P8587_S098_LOW_W4.csv | D:\PICO\A44_SAR_ADC_CURRENT_CACE_REPRODUCIBLE_20260728_R1\01_MC200_TT_LOW_W4\csv\job_codes\MC200_CMP_XM5_XM6_W8P2524_XM7_XM11_W16P8587_S098_LOW_W4.csv | D:\PICO\A44_SAR_ADC_CURRENT_CACE_REPRODUCIBLE_20260728_R2\02_SIMULATION_RESULTS\01_MC200_TT_LOW_W4\csv\job_codes\MC200_CMP_XM5_XM6_W8P2524_XM7_XM11_W16P8587_S098_LOW_W4.csv | 24248 | 24248 | 7ba6639e40aa481ab90cb80902cb8bcf0eceaa96db1e62bc44b5cca47bf19f18 | 7ba6639e40aa481ab90cb80902cb8bcf0eceaa96db1e62bc44b5cca47bf19f18 | EXACT_COPY
02_SIMULATION_RESULTS/01_MC200_TT_LOW_W4/csv/job_codes/MC200_CMP_XM5_XM6_W8P2524_XM7_XM11_W16P8587_S099_LOW_W4.csv | D:\PICO\A44_SAR_ADC_CURRENT_CACE_REPRODUCIBLE_20260728_R1\01_MC200_TT_LOW_W4\csv\job_codes\MC200_CMP_XM5_XM6_W8P2524_XM7_XM11_W16P8587_S099_LOW_W4.csv | D:\PICO\A44_SAR_ADC_CURRENT_CACE_REPRODUCIBLE_20260728_R2\02_SIMULATION_RESULTS\01_MC200_TT_LOW_W4\csv\job_codes\MC200_CMP_XM5_XM6_W8P2524_XM7_XM11_W16P8587_S099_LOW_W4.csv | 24259 | 24259 | f45400c867772ce51a48e75a59e8bfde73a3f1697ad16bc5d37a25ad6fa19583 | f45400c867772ce51a48e75a59e8bfde73a3f1697ad16bc5d37a25ad6fa19583 | EXACT_COPY
02_SIMULATION_RESULTS/01_MC200_TT_LOW_W4/csv/job_codes/MC200_CMP_XM5_XM6_W8P2524_XM7_XM11_W16P8587_S100_LOW_W4.csv | D:\PICO\A44_SAR_ADC_CURRENT_CACE_REPRODUCIBLE_20260728_R1\01_MC200_TT_LOW_W4\csv\job_codes\MC200_CMP_XM5_XM6_W8P2524_XM7_XM11_W16P8587_S100_LOW_W4.csv | D:\PICO\A44_SAR_ADC_CURRENT_CACE_REPRODUCIBLE_20260728_R2\02_SIMULATION_RESULTS\01_MC200_TT_LOW_W4\csv\job_codes\MC200_CMP_XM5_XM6_W8P2524_XM7_XM11_W16P8587_S100_LOW_W4.csv | 24319 | 24319 | 4b852b774a34dea3befddd6bc093a6e2e5d901585cd81e287e6ed3152e5d0e9e | 4b852b774a34dea3befddd6bc093a6e2e5d901585cd81e287e6ed3152e5d0e9e | EXACT_COPY
02_SIMULATION_RESULTS/01_MC200_TT_LOW_W4/csv/job_codes/MC200_CMP_XM5_XM6_W8P2524_XM7_XM11_W16P8587_S101_LOW_W4.csv | D:\PICO\A44_SAR_ADC_CURRENT_CACE_REPRODUCIBLE_20260728_R1\01_MC200_TT_LOW_W4\csv\job_codes\MC200_CMP_XM5_XM6_W8P2524_XM7_XM11_W16P8587_S101_LOW_W4.csv | D:\PICO\A44_SAR_ADC_CURRENT_CACE_REPRODUCIBLE_20260728_R2\02_SIMULATION_RESULTS\01_MC200_TT_LOW_W4\csv\job_codes\MC200_CMP_XM5_XM6_W8P2524_XM7_XM11_W16P8587_S101_LOW_W4.csv | 24311 | 24311 | 0f9473a1edeecc25ed28cd54153d0bfebb6dd9d24c2540b3d4f90aca3ab36591 | 0f9473a1edeecc25ed28cd54153d0bfebb6dd9d24c2540b3d4f90aca3ab36591 | EXACT_COPY
02_SIMULATION_RESULTS/01_MC200_TT_LOW_W4/csv/job_codes/MC200_CMP_XM5_XM6_W8P2524_XM7_XM11_W16P8587_S102_LOW_W4.csv | D:\PICO\A44_SAR_ADC_CURRENT_CACE_REPRODUCIBLE_20260728_R1\01_MC200_TT_LOW_W4\csv\job_codes\MC200_CMP_XM5_XM6_W8P2524_XM7_XM11_W16P8587_S102_LOW_W4.csv | D:\PICO\A44_SAR_ADC_CURRENT_CACE_REPRODUCIBLE_20260728_R2\02_SIMULATION_RESULTS\01_MC200_TT_LOW_W4\csv\job_codes\MC200_CMP_XM5_XM6_W8P2524_XM7_XM11_W16P8587_S102_LOW_W4.csv | 24325 | 24325 | 4f6a42c84d657115da61edc423a6cc9d5393613e58cd2a1f206876b1132f7120 | 4f6a42c84d657115da61edc423a6cc9d5393613e58cd2a1f206876b1132f7120 | EXACT_COPY
02_SIMULATION_RESULTS/01_MC200_TT_LOW_W4/csv/job_codes/MC200_CMP_XM5_XM6_W8P2524_XM7_XM11_W16P8587_S103_LOW_W4.csv | D:\PICO\A44_SAR_ADC_CURRENT_CACE_REPRODUCIBLE_20260728_R1\01_MC200_TT_LOW_W4\csv\job_codes\MC200_CMP_XM5_XM6_W8P2524_XM7_XM11_W16P8587_S103_LOW_W4.csv | D:\PICO\A44_SAR_ADC_CURRENT_CACE_REPRODUCIBLE_20260728_R2\02_SIMULATION_RESULTS\01_MC200_TT_LOW_W4\csv\job_codes\MC200_CMP_XM5_XM6_W8P2524_XM7_XM11_W16P8587_S103_LOW_W4.csv | 24316 | 24316 | ec50cc4dafef18a528bd1f0f00a0559a8ae6b9632339c7ee586033bc99c0b036 | ec50cc4dafef18a528bd1f0f00a0559a8ae6b9632339c7ee586033bc99c0b036 | EXACT_COPY
02_SIMULATION_RESULTS/01_MC200_TT_LOW_W4/csv/job_codes/MC200_CMP_XM5_XM6_W8P2524_XM7_XM11_W16P8587_S104_LOW_W4.csv | D:\PICO\A44_SAR_ADC_CURRENT_CACE_REPRODUCIBLE_20260728_R1\01_MC200_TT_LOW_W4\csv\job_codes\MC200_CMP_XM5_XM6_W8P2524_XM7_XM11_W16P8587_S104_LOW_W4.csv | D:\PICO\A44_SAR_ADC_CURRENT_CACE_REPRODUCIBLE_20260728_R2\02_SIMULATION_RESULTS\01_MC200_TT_LOW_W4\csv\job_codes\MC200_CMP_XM5_XM6_W8P2524_XM7_XM11_W16P8587_S104_LOW_W4.csv | 24313 | 24313 | 5e82b526d95c32da03c509cbc511b02317215073b028c28733c578aa1c101879 | 5e82b526d95c32da03c509cbc511b02317215073b028c28733c578aa1c101879 | EXACT_COPY
02_SIMULATION_RESULTS/01_MC200_TT_LOW_W4/csv/job_codes/MC200_CMP_XM5_XM6_W8P2524_XM7_XM11_W16P8587_S105_LOW_W4.csv | D:\PICO\A44_SAR_ADC_CURRENT_CACE_REPRODUCIBLE_20260728_R1\01_MC200_TT_LOW_W4\csv\job_codes\MC200_CMP_XM5_XM6_W8P2524_XM7_XM11_W16P8587_S105_LOW_W4.csv | D:\PICO\A44_SAR_ADC_CURRENT_CACE_REPRODUCIBLE_20260728_R2\02_SIMULATION_RESULTS\01_MC200_TT_LOW_W4\csv\job_codes\MC200_CMP_XM5_XM6_W8P2524_XM7_XM11_W16P8587_S105_LOW_W4.csv | 24316 | 24316 | 6da2a11bd65914a29fa0c9ef2d955100a13bbec9fa5a52620642b11869bc7ff4 | 6da2a11bd65914a29fa0c9ef2d955100a13bbec9fa5a52620642b11869bc7ff4 | EXACT_COPY
02_SIMULATION_RESULTS/01_MC200_TT_LOW_W4/csv/job_codes/MC200_CMP_XM5_XM6_W8P2524_XM7_XM11_W16P8587_S106_LOW_W4.csv | D:\PICO\A44_SAR_ADC_CURRENT_CACE_REPRODUCIBLE_20260728_R1\01_MC200_TT_LOW_W4\csv\job_codes\MC200_CMP_XM5_XM6_W8P2524_XM7_XM11_W16P8587_S106_LOW_W4.csv | D:\PICO\A44_SAR_ADC_CURRENT_CACE_REPRODUCIBLE_20260728_R2\02_SIMULATION_RESULTS\01_MC200_TT_LOW_W4\csv\job_codes\MC200_CMP_XM5_XM6_W8P2524_XM7_XM11_W16P8587_S106_LOW_W4.csv | 24322 | 24322 | 35cd19274b397c8f1509732d0877ca8e5a6e652129f0282008d7dc8f93421ebb | 35cd19274b397c8f1509732d0877ca8e5a6e652129f0282008d7dc8f93421ebb | EXACT_COPY
02_SIMULATION_RESULTS/01_MC200_TT_LOW_W4/csv/job_codes/MC200_CMP_XM5_XM6_W8P2524_XM7_XM11_W16P8587_S107_LOW_W4.csv | D:\PICO\A44_SAR_ADC_CURRENT_CACE_REPRODUCIBLE_20260728_R1\01_MC200_TT_LOW_W4\csv\job_codes\MC200_CMP_XM5_XM6_W8P2524_XM7_XM11_W16P8587_S107_LOW_W4.csv | D:\PICO\A44_SAR_ADC_CURRENT_CACE_REPRODUCIBLE_20260728_R2\02_SIMULATION_RESULTS\01_MC200_TT_LOW_W4\csv\job_codes\MC200_CMP_XM5_XM6_W8P2524_XM7_XM11_W16P8587_S107_LOW_W4.csv | 24305 | 24305 | e01e0f2603cb36153cf05566113465778c92c6a1e75106b95c92bb5f4407343e | e01e0f2603cb36153cf05566113465778c92c6a1e75106b95c92bb5f4407343e | EXACT_COPY
02_SIMULATION_RESULTS/01_MC200_TT_LOW_W4/csv/job_codes/MC200_CMP_XM5_XM6_W8P2524_XM7_XM11_W16P8587_S108_LOW_W4.csv | D:\PICO\A44_SAR_ADC_CURRENT_CACE_REPRODUCIBLE_20260728_R1\01_MC200_TT_LOW_W4\csv\job_codes\MC200_CMP_XM5_XM6_W8P2524_XM7_XM11_W16P8587_S108_LOW_W4.csv | D:\PICO\A44_SAR_ADC_CURRENT_CACE_REPRODUCIBLE_20260728_R2\02_SIMULATION_RESULTS\01_MC200_TT_LOW_W4\csv\job_codes\MC200_CMP_XM5_XM6_W8P2524_XM7_XM11_W16P8587_S108_LOW_W4.csv | 24324 | 24324 | fb05b82ed943dfcbfe75fb666bafef3f1f0670f10c36eddcc53cfc13418c2eaf | fb05b82ed943dfcbfe75fb666bafef3f1f0670f10c36eddcc53cfc13418c2eaf | EXACT_COPY
02_SIMULATION_RESULTS/01_MC200_TT_LOW_W4/csv/job_codes/MC200_CMP_XM5_XM6_W8P2524_XM7_XM11_W16P8587_S109_LOW_W4.csv | D:\PICO\A44_SAR_ADC_CURRENT_CACE_REPRODUCIBLE_20260728_R1\01_MC200_TT_LOW_W4\csv\job_codes\MC200_CMP_XM5_XM6_W8P2524_XM7_XM11_W16P8587_S109_LOW_W4.csv | D:\PICO\A44_SAR_ADC_CURRENT_CACE_REPRODUCIBLE_20260728_R2\02_SIMULATION_RESULTS\01_MC200_TT_LOW_W4\csv\job_codes\MC200_CMP_XM5_XM6_W8P2524_XM7_XM11_W16P8587_S109_LOW_W4.csv | 24331 | 24331 | b3ccf3ade60cdcad25dad6bb4ceb6f36342cfdfc163320f121fea5a4790dfac1 | b3ccf3ade60cdcad25dad6bb4ceb6f36342cfdfc163320f121fea5a4790dfac1 | EXACT_COPY
02_SIMULATION_RESULTS/01_MC200_TT_LOW_W4/csv/job_codes/MC200_CMP_XM5_XM6_W8P2524_XM7_XM11_W16P8587_S110_LOW_W4.csv | D:\PICO\A44_SAR_ADC_CURRENT_CACE_REPRODUCIBLE_20260728_R1\01_MC200_TT_LOW_W4\csv\job_codes\MC200_CMP_XM5_XM6_W8P2524_XM7_XM11_W16P8587_S110_LOW_W4.csv | D:\PICO\A44_SAR_ADC_CURRENT_CACE_REPRODUCIBLE_20260728_R2\02_SIMULATION_RESULTS\01_MC200_TT_LOW_W4\csv\job_codes\MC200_CMP_XM5_XM6_W8P2524_XM7_XM11_W16P8587_S110_LOW_W4.csv | 24325 | 24325 | 696f17eb1470953e052710eaac28336618c84f47901a351546dff71175a9a5c3 | 696f17eb1470953e052710eaac28336618c84f47901a351546dff71175a9a5c3 | EXACT_COPY
02_SIMULATION_RESULTS/01_MC200_TT_LOW_W4/csv/job_codes/MC200_CMP_XM5_XM6_W8P2524_XM7_XM11_W16P8587_S111_LOW_W4.csv | D:\PICO\A44_SAR_ADC_CURRENT_CACE_REPRODUCIBLE_20260728_R1\01_MC200_TT_LOW_W4\csv\job_codes\MC200_CMP_XM5_XM6_W8P2524_XM7_XM11_W16P8587_S111_LOW_W4.csv | D:\PICO\A44_SAR_ADC_CURRENT_CACE_REPRODUCIBLE_20260728_R2\02_SIMULATION_RESULTS\01_MC200_TT_LOW_W4\csv\job_codes\MC200_CMP_XM5_XM6_W8P2524_XM7_XM11_W16P8587_S111_LOW_W4.csv | 24333 | 24333 | a387137c17aaaa46e768b80ae02dcdc83735eb2c831360e50bd8ae4b88c25c89 | a387137c17aaaa46e768b80ae02dcdc83735eb2c831360e50bd8ae4b88c25c89 | EXACT_COPY
02_SIMULATION_RESULTS/01_MC200_TT_LOW_W4/csv/job_codes/MC200_CMP_XM5_XM6_W8P2524_XM7_XM11_W16P8587_S112_LOW_W4.csv | D:\PICO\A44_SAR_ADC_CURRENT_CACE_REPRODUCIBLE_20260728_R1\01_MC200_TT_LOW_W4\csv\job_codes\MC200_CMP_XM5_XM6_W8P2524_XM7_XM11_W16P8587_S112_LOW_W4.csv | D:\PICO\A44_SAR_ADC_CURRENT_CACE_REPRODUCIBLE_20260728_R2\02_SIMULATION_RESULTS\01_MC200_TT_LOW_W4\csv\job_codes\MC200_CMP_XM5_XM6_W8P2524_XM7_XM11_W16P8587_S112_LOW_W4.csv | 24320 | 24320 | d8d205fdc3704d5600befde7d38980a26c08037728efc2feb1da7a3da1a429a2 | d8d205fdc3704d5600befde7d38980a26c08037728efc2feb1da7a3da1a429a2 | EXACT_COPY
02_SIMULATION_RESULTS/01_MC200_TT_LOW_W4/csv/job_codes/MC200_CMP_XM5_XM6_W8P2524_XM7_XM11_W16P8587_S113_LOW_W4.csv | D:\PICO\A44_SAR_ADC_CURRENT_CACE_REPRODUCIBLE_20260728_R1\01_MC200_TT_LOW_W4\csv\job_codes\MC200_CMP_XM5_XM6_W8P2524_XM7_XM11_W16P8587_S113_LOW_W4.csv | D:\PICO\A44_SAR_ADC_CURRENT_CACE_REPRODUCIBLE_20260728_R2\02_SIMULATION_RESULTS\01_MC200_TT_LOW_W4\csv\job_codes\MC200_CMP_XM5_XM6_W8P2524_XM7_XM11_W16P8587_S113_LOW_W4.csv | 24319 | 24319 | 6f81065f75a0c47102b648b766e21ae00214799d00863a42f94ada2e948a6f15 | 6f81065f75a0c47102b648b766e21ae00214799d00863a42f94ada2e948a6f15 | EXACT_COPY
02_SIMULATION_RESULTS/01_MC200_TT_LOW_W4/csv/job_codes/MC200_CMP_XM5_XM6_W8P2524_XM7_XM11_W16P8587_S114_LOW_W4.csv | D:\PICO\A44_SAR_ADC_CURRENT_CACE_REPRODUCIBLE_20260728_R1\01_MC200_TT_LOW_W4\csv\job_codes\MC200_CMP_XM5_XM6_W8P2524_XM7_XM11_W16P8587_S114_LOW_W4.csv | D:\PICO\A44_SAR_ADC_CURRENT_CACE_REPRODUCIBLE_20260728_R2\02_SIMULATION_RESULTS\01_MC200_TT_LOW_W4\csv\job_codes\MC200_CMP_XM5_XM6_W8P2524_XM7_XM11_W16P8587_S114_LOW_W4.csv | 24321 | 24321 | 0208d2ce0627611184cc42e08105280b125ecd46dd8e565a7be5a4d3a7e2cb6f | 0208d2ce0627611184cc42e08105280b125ecd46dd8e565a7be5a4d3a7e2cb6f | EXACT_COPY
02_SIMULATION_RESULTS/01_MC200_TT_LOW_W4/csv/job_codes/MC200_CMP_XM5_XM6_W8P2524_XM7_XM11_W16P8587_S115_LOW_W4.csv | D:\PICO\A44_SAR_ADC_CURRENT_CACE_REPRODUCIBLE_20260728_R1\01_MC200_TT_LOW_W4\csv\job_codes\MC200_CMP_XM5_XM6_W8P2524_XM7_XM11_W16P8587_S115_LOW_W4.csv | D:\PICO\A44_SAR_ADC_CURRENT_CACE_REPRODUCIBLE_20260728_R2\02_SIMULATION_RESULTS\01_MC200_TT_LOW_W4\csv\job_codes\MC200_CMP_XM5_XM6_W8P2524_XM7_XM11_W16P8587_S115_LOW_W4.csv | 24320 | 24320 | 5c40bf280394158228c117a9709af22c1aa6d71888b4a91d7152ed6f0503bdaf | 5c40bf280394158228c117a9709af22c1aa6d71888b4a91d7152ed6f0503bdaf | EXACT_COPY
02_SIMULATION_RESULTS/01_MC200_TT_LOW_W4/csv/job_codes/MC200_CMP_XM5_XM6_W8P2524_XM7_XM11_W16P8587_S116_LOW_W4.csv | D:\PICO\A44_SAR_ADC_CURRENT_CACE_REPRODUCIBLE_20260728_R1\01_MC200_TT_LOW_W4\csv\job_codes\MC200_CMP_XM5_XM6_W8P2524_XM7_XM11_W16P8587_S116_LOW_W4.csv | D:\PICO\A44_SAR_ADC_CURRENT_CACE_REPRODUCIBLE_20260728_R2\02_SIMULATION_RESULTS\01_MC200_TT_LOW_W4\csv\job_codes\MC200_CMP_XM5_XM6_W8P2524_XM7_XM11_W16P8587_S116_LOW_W4.csv | 24317 | 24317 | 5b200395ae06f3cac8aff63bbc768e63bbd2e0896dd152abee71ede7aa14c9cd | 5b200395ae06f3cac8aff63bbc768e63bbd2e0896dd152abee71ede7aa14c9cd | EXACT_COPY
02_SIMULATION_RESULTS/01_MC200_TT_LOW_W4/csv/job_codes/MC200_CMP_XM5_XM6_W8P2524_XM7_XM11_W16P8587_S117_LOW_W4.csv | D:\PICO\A44_SAR_ADC_CURRENT_CACE_REPRODUCIBLE_20260728_R1\01_MC200_TT_LOW_W4\csv\job_codes\MC200_CMP_XM5_XM6_W8P2524_XM7_XM11_W16P8587_S117_LOW_W4.csv | D:\PICO\A44_SAR_ADC_CURRENT_CACE_REPRODUCIBLE_20260728_R2\02_SIMULATION_RESULTS\01_MC200_TT_LOW_W4\csv\job_codes\MC200_CMP_XM5_XM6_W8P2524_XM7_XM11_W16P8587_S117_LOW_W4.csv | 24301 | 24301 | 25b87b16f6255cf92016aa7e3529bde63e821932152f379d80c26e4c938a8284 | 25b87b16f6255cf92016aa7e3529bde63e821932152f379d80c26e4c938a8284 | EXACT_COPY
02_SIMULATION_RESULTS/01_MC200_TT_LOW_W4/csv/job_codes/MC200_CMP_XM5_XM6_W8P2524_XM7_XM11_W16P8587_S118_LOW_W4.csv | D:\PICO\A44_SAR_ADC_CURRENT_CACE_REPRODUCIBLE_20260728_R1\01_MC200_TT_LOW_W4\csv\job_codes\MC200_CMP_XM5_XM6_W8P2524_XM7_XM11_W16P8587_S118_LOW_W4.csv | D:\PICO\A44_SAR_ADC_CURRENT_CACE_REPRODUCIBLE_20260728_R2\02_SIMULATION_RESULTS\01_MC200_TT_LOW_W4\csv\job_codes\MC200_CMP_XM5_XM6_W8P2524_XM7_XM11_W16P8587_S118_LOW_W4.csv | 24326 | 24326 | 9e1d70c38dce20098d150cb4ac0a98b64b0ad930dc5cfa6bf4f1b98e2c3fd530 | 9e1d70c38dce20098d150cb4ac0a98b64b0ad930dc5cfa6bf4f1b98e2c3fd530 | EXACT_COPY
02_SIMULATION_RESULTS/01_MC200_TT_LOW_W4/csv/job_codes/MC200_CMP_XM5_XM6_W8P2524_XM7_XM11_W16P8587_S119_LOW_W4.csv | D:\PICO\A44_SAR_ADC_CURRENT_CACE_REPRODUCIBLE_20260728_R1\01_MC200_TT_LOW_W4\csv\job_codes\MC200_CMP_XM5_XM6_W8P2524_XM7_XM11_W16P8587_S119_LOW_W4.csv | D:\PICO\A44_SAR_ADC_CURRENT_CACE_REPRODUCIBLE_20260728_R2\02_SIMULATION_RESULTS\01_MC200_TT_LOW_W4\csv\job_codes\MC200_CMP_XM5_XM6_W8P2524_XM7_XM11_W16P8587_S119_LOW_W4.csv | 24316 | 24316 | a68836d177ecb319b21dff3e6f73a4c7da4afb109bfce5baa2e969cdd6226b09 | a68836d177ecb319b21dff3e6f73a4c7da4afb109bfce5baa2e969cdd6226b09 | EXACT_COPY
02_SIMULATION_RESULTS/01_MC200_TT_LOW_W4/csv/job_codes/MC200_CMP_XM5_XM6_W8P2524_XM7_XM11_W16P8587_S120_LOW_W4.csv | D:\PICO\A44_SAR_ADC_CURRENT_CACE_REPRODUCIBLE_20260728_R1\01_MC200_TT_LOW_W4\csv\job_codes\MC200_CMP_XM5_XM6_W8P2524_XM7_XM11_W16P8587_S120_LOW_W4.csv | D:\PICO\A44_SAR_ADC_CURRENT_CACE_REPRODUCIBLE_20260728_R2\02_SIMULATION_RESULTS\01_MC200_TT_LOW_W4\csv\job_codes\MC200_CMP_XM5_XM6_W8P2524_XM7_XM11_W16P8587_S120_LOW_W4.csv | 24314 | 24314 | 5b77f98c88d81f14cd7190969f9746534aeb1e179c01338b4bdcda748e022c14 | 5b77f98c88d81f14cd7190969f9746534aeb1e179c01338b4bdcda748e022c14 | EXACT_COPY
02_SIMULATION_RESULTS/01_MC200_TT_LOW_W4/csv/job_codes/MC200_CMP_XM5_XM6_W8P2524_XM7_XM11_W16P8587_S121_LOW_W4.csv | D:\PICO\A44_SAR_ADC_CURRENT_CACE_REPRODUCIBLE_20260728_R1\01_MC200_TT_LOW_W4\csv\job_codes\MC200_CMP_XM5_XM6_W8P2524_XM7_XM11_W16P8587_S121_LOW_W4.csv | D:\PICO\A44_SAR_ADC_CURRENT_CACE_REPRODUCIBLE_20260728_R2\02_SIMULATION_RESULTS\01_MC200_TT_LOW_W4\csv\job_codes\MC200_CMP_XM5_XM6_W8P2524_XM7_XM11_W16P8587_S121_LOW_W4.csv | 24322 | 24322 | 2c7201ba7dfb3335d6ff8d7b1564c69465fc8d69f2b9a42be00ea71d4a86b4fb | 2c7201ba7dfb3335d6ff8d7b1564c69465fc8d69f2b9a42be00ea71d4a86b4fb | EXACT_COPY
02_SIMULATION_RESULTS/01_MC200_TT_LOW_W4/csv/job_codes/MC200_CMP_XM5_XM6_W8P2524_XM7_XM11_W16P8587_S122_LOW_W4.csv | D:\PICO\A44_SAR_ADC_CURRENT_CACE_REPRODUCIBLE_20260728_R1\01_MC200_TT_LOW_W4\csv\job_codes\MC200_CMP_XM5_XM6_W8P2524_XM7_XM11_W16P8587_S122_LOW_W4.csv | D:\PICO\A44_SAR_ADC_CURRENT_CACE_REPRODUCIBLE_20260728_R2\02_SIMULATION_RESULTS\01_MC200_TT_LOW_W4\csv\job_codes\MC200_CMP_XM5_XM6_W8P2524_XM7_XM11_W16P8587_S122_LOW_W4.csv | 24316 | 24316 | 035505d3379baa0c2159d622cc6c50b8eaed6e1714b8e2ec6e19ec77a2a70b75 | 035505d3379baa0c2159d622cc6c50b8eaed6e1714b8e2ec6e19ec77a2a70b75 | EXACT_COPY
02_SIMULATION_RESULTS/01_MC200_TT_LOW_W4/csv/job_codes/MC200_CMP_XM5_XM6_W8P2524_XM7_XM11_W16P8587_S123_LOW_W4.csv | D:\PICO\A44_SAR_ADC_CURRENT_CACE_REPRODUCIBLE_20260728_R1\01_MC200_TT_LOW_W4\csv\job_codes\MC200_CMP_XM5_XM6_W8P2524_XM7_XM11_W16P8587_S123_LOW_W4.csv | D:\PICO\A44_SAR_ADC_CURRENT_CACE_REPRODUCIBLE_20260728_R2\02_SIMULATION_RESULTS\01_MC200_TT_LOW_W4\csv\job_codes\MC200_CMP_XM5_XM6_W8P2524_XM7_XM11_W16P8587_S123_LOW_W4.csv | 24327 | 24327 | 4b9c1d84e071b04cc800a98356cfd722ba45bf81b651f24777d34b8bed9f00eb | 4b9c1d84e071b04cc800a98356cfd722ba45bf81b651f24777d34b8bed9f00eb | EXACT_COPY
02_SIMULATION_RESULTS/01_MC200_TT_LOW_W4/csv/job_codes/MC200_CMP_XM5_XM6_W8P2524_XM7_XM11_W16P8587_S124_LOW_W4.csv | D:\PICO\A44_SAR_ADC_CURRENT_CACE_REPRODUCIBLE_20260728_R1\01_MC200_TT_LOW_W4\csv\job_codes\MC200_CMP_XM5_XM6_W8P2524_XM7_XM11_W16P8587_S124_LOW_W4.csv | D:\PICO\A44_SAR_ADC_CURRENT_CACE_REPRODUCIBLE_20260728_R2\02_SIMULATION_RESULTS\01_MC200_TT_LOW_W4\csv\job_codes\MC200_CMP_XM5_XM6_W8P2524_XM7_XM11_W16P8587_S124_LOW_W4.csv | 24321 | 24321 | 6a2d4954140fbb789b4eb681d68fc6f8ea729e46fa77cd3c6c3ccdf743bee062 | 6a2d4954140fbb789b4eb681d68fc6f8ea729e46fa77cd3c6c3ccdf743bee062 | EXACT_COPY
02_SIMULATION_RESULTS/01_MC200_TT_LOW_W4/csv/job_codes/MC200_CMP_XM5_XM6_W8P2524_XM7_XM11_W16P8587_S125_LOW_W4.csv | D:\PICO\A44_SAR_ADC_CURRENT_CACE_REPRODUCIBLE_20260728_R1\01_MC200_TT_LOW_W4\csv\job_codes\MC200_CMP_XM5_XM6_W8P2524_XM7_XM11_W16P8587_S125_LOW_W4.csv | D:\PICO\A44_SAR_ADC_CURRENT_CACE_REPRODUCIBLE_20260728_R2\02_SIMULATION_RESULTS\01_MC200_TT_LOW_W4\csv\job_codes\MC200_CMP_XM5_XM6_W8P2524_XM7_XM11_W16P8587_S125_LOW_W4.csv | 24326 | 24326 | b7693bc0290e33ae49e97bab64031a7fa8aad6a76ea317c11a8c4751755096b7 | b7693bc0290e33ae49e97bab64031a7fa8aad6a76ea317c11a8c4751755096b7 | EXACT_COPY
02_SIMULATION_RESULTS/01_MC200_TT_LOW_W4/csv/job_codes/MC200_CMP_XM5_XM6_W8P2524_XM7_XM11_W16P8587_S126_LOW_W4.csv | D:\PICO\A44_SAR_ADC_CURRENT_CACE_REPRODUCIBLE_20260728_R1\01_MC200_TT_LOW_W4\csv\job_codes\MC200_CMP_XM5_XM6_W8P2524_XM7_XM11_W16P8587_S126_LOW_W4.csv | D:\PICO\A44_SAR_ADC_CURRENT_CACE_REPRODUCIBLE_20260728_R2\02_SIMULATION_RESULTS\01_MC200_TT_LOW_W4\csv\job_codes\MC200_CMP_XM5_XM6_W8P2524_XM7_XM11_W16P8587_S126_LOW_W4.csv | 24319 | 24319 | 4408ef4a043fd714e218e97857daa90b6c76b531bee7a07999e72b78166aaebd | 4408ef4a043fd714e218e97857daa90b6c76b531bee7a07999e72b78166aaebd | EXACT_COPY
02_SIMULATION_RESULTS/01_MC200_TT_LOW_W4/csv/job_codes/MC200_CMP_XM5_XM6_W8P2524_XM7_XM11_W16P8587_S127_LOW_W4.csv | D:\PICO\A44_SAR_ADC_CURRENT_CACE_REPRODUCIBLE_20260728_R1\01_MC200_TT_LOW_W4\csv\job_codes\MC200_CMP_XM5_XM6_W8P2524_XM7_XM11_W16P8587_S127_LOW_W4.csv | D:\PICO\A44_SAR_ADC_CURRENT_CACE_REPRODUCIBLE_20260728_R2\02_SIMULATION_RESULTS\01_MC200_TT_LOW_W4\csv\job_codes\MC200_CMP_XM5_XM6_W8P2524_XM7_XM11_W16P8587_S127_LOW_W4.csv | 24325 | 24325 | edc465b046991295412564687112e9c490dacb74fa574cd243f587c464f25597 | edc465b046991295412564687112e9c490dacb74fa574cd243f587c464f25597 | EXACT_COPY
02_SIMULATION_RESULTS/01_MC200_TT_LOW_W4/csv/job_codes/MC200_CMP_XM5_XM6_W8P2524_XM7_XM11_W16P8587_S128_LOW_W4.csv | D:\PICO\A44_SAR_ADC_CURRENT_CACE_REPRODUCIBLE_20260728_R1\01_MC200_TT_LOW_W4\csv\job_codes\MC200_CMP_XM5_XM6_W8P2524_XM7_XM11_W16P8587_S128_LOW_W4.csv | D:\PICO\A44_SAR_ADC_CURRENT_CACE_REPRODUCIBLE_20260728_R2\02_SIMULATION_RESULTS\01_MC200_TT_LOW_W4\csv\job_codes\MC200_CMP_XM5_XM6_W8P2524_XM7_XM11_W16P8587_S128_LOW_W4.csv | 24316 | 24316 | 47a75a7911cccb6bd308fae0abf16c82a05a0034166edc206f6ad50b99d2402b | 47a75a7911cccb6bd308fae0abf16c82a05a0034166edc206f6ad50b99d2402b | EXACT_COPY
02_SIMULATION_RESULTS/01_MC200_TT_LOW_W4/csv/job_codes/MC200_CMP_XM5_XM6_W8P2524_XM7_XM11_W16P8587_S129_LOW_W4.csv | D:\PICO\A44_SAR_ADC_CURRENT_CACE_REPRODUCIBLE_20260728_R1\01_MC200_TT_LOW_W4\csv\job_codes\MC200_CMP_XM5_XM6_W8P2524_XM7_XM11_W16P8587_S129_LOW_W4.csv | D:\PICO\A44_SAR_ADC_CURRENT_CACE_REPRODUCIBLE_20260728_R2\02_SIMULATION_RESULTS\01_MC200_TT_LOW_W4\csv\job_codes\MC200_CMP_XM5_XM6_W8P2524_XM7_XM11_W16P8587_S129_LOW_W4.csv | 24324 | 24324 | 06d44b21b6cd008f212ed2b84f09d7a4a566f8bf352cf585b8b0ae6c24b50090 | 06d44b21b6cd008f212ed2b84f09d7a4a566f8bf352cf585b8b0ae6c24b50090 | EXACT_COPY
02_SIMULATION_RESULTS/01_MC200_TT_LOW_W4/csv/job_codes/MC200_CMP_XM5_XM6_W8P2524_XM7_XM11_W16P8587_S130_LOW_W4.csv | D:\PICO\A44_SAR_ADC_CURRENT_CACE_REPRODUCIBLE_20260728_R1\01_MC200_TT_LOW_W4\csv\job_codes\MC200_CMP_XM5_XM6_W8P2524_XM7_XM11_W16P8587_S130_LOW_W4.csv | D:\PICO\A44_SAR_ADC_CURRENT_CACE_REPRODUCIBLE_20260728_R2\02_SIMULATION_RESULTS\01_MC200_TT_LOW_W4\csv\job_codes\MC200_CMP_XM5_XM6_W8P2524_XM7_XM11_W16P8587_S130_LOW_W4.csv | 24317 | 24317 | c5b79366a51381bf4f2690213dcc63c0787d6473745e512d09191db1babdcc3c | c5b79366a51381bf4f2690213dcc63c0787d6473745e512d09191db1babdcc3c | EXACT_COPY
02_SIMULATION_RESULTS/01_MC200_TT_LOW_W4/csv/job_codes/MC200_CMP_XM5_XM6_W8P2524_XM7_XM11_W16P8587_S131_LOW_W4.csv | D:\PICO\A44_SAR_ADC_CURRENT_CACE_REPRODUCIBLE_20260728_R1\01_MC200_TT_LOW_W4\csv\job_codes\MC200_CMP_XM5_XM6_W8P2524_XM7_XM11_W16P8587_S131_LOW_W4.csv | D:\PICO\A44_SAR_ADC_CURRENT_CACE_REPRODUCIBLE_20260728_R2\02_SIMULATION_RESULTS\01_MC200_TT_LOW_W4\csv\job_codes\MC200_CMP_XM5_XM6_W8P2524_XM7_XM11_W16P8587_S131_LOW_W4.csv | 24324 | 24324 | 223cc1c2f3e38fa6f1fcfb078c3f297c0ff944931a3541c2c7fa79d4121bd2c6 | 223cc1c2f3e38fa6f1fcfb078c3f297c0ff944931a3541c2c7fa79d4121bd2c6 | EXACT_COPY
02_SIMULATION_RESULTS/01_MC200_TT_LOW_W4/csv/job_codes/MC200_CMP_XM5_XM6_W8P2524_XM7_XM11_W16P8587_S132_LOW_W4.csv | D:\PICO\A44_SAR_ADC_CURRENT_CACE_REPRODUCIBLE_20260728_R1\01_MC200_TT_LOW_W4\csv\job_codes\MC200_CMP_XM5_XM6_W8P2524_XM7_XM11_W16P8587_S132_LOW_W4.csv | D:\PICO\A44_SAR_ADC_CURRENT_CACE_REPRODUCIBLE_20260728_R2\02_SIMULATION_RESULTS\01_MC200_TT_LOW_W4\csv\job_codes\MC200_CMP_XM5_XM6_W8P2524_XM7_XM11_W16P8587_S132_LOW_W4.csv | 24329 | 24329 | 200d01bdb922aa4a5b34b2434d7ebca88c0029a8f095d054a02a9e7bb1c31ba5 | 200d01bdb922aa4a5b34b2434d7ebca88c0029a8f095d054a02a9e7bb1c31ba5 | EXACT_COPY
02_SIMULATION_RESULTS/01_MC200_TT_LOW_W4/csv/job_codes/MC200_CMP_XM5_XM6_W8P2524_XM7_XM11_W16P8587_S133_LOW_W4.csv | D:\PICO\A44_SAR_ADC_CURRENT_CACE_REPRODUCIBLE_20260728_R1\01_MC200_TT_LOW_W4\csv\job_codes\MC200_CMP_XM5_XM6_W8P2524_XM7_XM11_W16P8587_S133_LOW_W4.csv | D:\PICO\A44_SAR_ADC_CURRENT_CACE_REPRODUCIBLE_20260728_R2\02_SIMULATION_RESULTS\01_MC200_TT_LOW_W4\csv\job_codes\MC200_CMP_XM5_XM6_W8P2524_XM7_XM11_W16P8587_S133_LOW_W4.csv | 24321 | 24321 | 3cbd27b84bb3529aa268ec97192a16e95c97f424b33288c072b905718dc86b3c | 3cbd27b84bb3529aa268ec97192a16e95c97f424b33288c072b905718dc86b3c | EXACT_COPY
02_SIMULATION_RESULTS/01_MC200_TT_LOW_W4/csv/job_codes/MC200_CMP_XM5_XM6_W8P2524_XM7_XM11_W16P8587_S134_LOW_W4.csv | D:\PICO\A44_SAR_ADC_CURRENT_CACE_REPRODUCIBLE_20260728_R1\01_MC200_TT_LOW_W4\csv\job_codes\MC200_CMP_XM5_XM6_W8P2524_XM7_XM11_W16P8587_S134_LOW_W4.csv | D:\PICO\A44_SAR_ADC_CURRENT_CACE_REPRODUCIBLE_20260728_R2\02_SIMULATION_RESULTS\01_MC200_TT_LOW_W4\csv\job_codes\MC200_CMP_XM5_XM6_W8P2524_XM7_XM11_W16P8587_S134_LOW_W4.csv | 24320 | 24320 | 40c16349775abdab3b88362066ac7bc888044f12c25bc7210c7f93dc9122b3f4 | 40c16349775abdab3b88362066ac7bc888044f12c25bc7210c7f93dc9122b3f4 | EXACT_COPY
02_SIMULATION_RESULTS/01_MC200_TT_LOW_W4/csv/job_codes/MC200_CMP_XM5_XM6_W8P2524_XM7_XM11_W16P8587_S135_LOW_W4.csv | D:\PICO\A44_SAR_ADC_CURRENT_CACE_REPRODUCIBLE_20260728_R1\01_MC200_TT_LOW_W4\csv\job_codes\MC200_CMP_XM5_XM6_W8P2524_XM7_XM11_W16P8587_S135_LOW_W4.csv | D:\PICO\A44_SAR_ADC_CURRENT_CACE_REPRODUCIBLE_20260728_R2\02_SIMULATION_RESULTS\01_MC200_TT_LOW_W4\csv\job_codes\MC200_CMP_XM5_XM6_W8P2524_XM7_XM11_W16P8587_S135_LOW_W4.csv | 24325 | 24325 | 1196f65b07323cbae7c4b1ace5ef49464fb81f7059445651aaaacc137198574c | 1196f65b07323cbae7c4b1ace5ef49464fb81f7059445651aaaacc137198574c | EXACT_COPY
02_SIMULATION_RESULTS/01_MC200_TT_LOW_W4/csv/job_codes/MC200_CMP_XM5_XM6_W8P2524_XM7_XM11_W16P8587_S136_LOW_W4.csv | D:\PICO\A44_SAR_ADC_CURRENT_CACE_REPRODUCIBLE_20260728_R1\01_MC200_TT_LOW_W4\csv\job_codes\MC200_CMP_XM5_XM6_W8P2524_XM7_XM11_W16P8587_S136_LOW_W4.csv | D:\PICO\A44_SAR_ADC_CURRENT_CACE_REPRODUCIBLE_20260728_R2\02_SIMULATION_RESULTS\01_MC200_TT_LOW_W4\csv\job_codes\MC200_CMP_XM5_XM6_W8P2524_XM7_XM11_W16P8587_S136_LOW_W4.csv | 24318 | 24318 | 0fe7d32c48865b1fbd8c52188ed22c60d44c568f82df47828c49d13193a28636 | 0fe7d32c48865b1fbd8c52188ed22c60d44c568f82df47828c49d13193a28636 | EXACT_COPY
02_SIMULATION_RESULTS/01_MC200_TT_LOW_W4/csv/job_codes/MC200_CMP_XM5_XM6_W8P2524_XM7_XM11_W16P8587_S137_LOW_W4.csv | D:\PICO\A44_SAR_ADC_CURRENT_CACE_REPRODUCIBLE_20260728_R1\01_MC200_TT_LOW_W4\csv\job_codes\MC200_CMP_XM5_XM6_W8P2524_XM7_XM11_W16P8587_S137_LOW_W4.csv | D:\PICO\A44_SAR_ADC_CURRENT_CACE_REPRODUCIBLE_20260728_R2\02_SIMULATION_RESULTS\01_MC200_TT_LOW_W4\csv\job_codes\MC200_CMP_XM5_XM6_W8P2524_XM7_XM11_W16P8587_S137_LOW_W4.csv | 24322 | 24322 | d584dc5d05ce607a1703eb952b2c33832a3ce219e91127b61650d76b292435c3 | d584dc5d05ce607a1703eb952b2c33832a3ce219e91127b61650d76b292435c3 | EXACT_COPY
02_SIMULATION_RESULTS/01_MC200_TT_LOW_W4/csv/job_codes/MC200_CMP_XM5_XM6_W8P2524_XM7_XM11_W16P8587_S138_LOW_W4.csv | D:\PICO\A44_SAR_ADC_CURRENT_CACE_REPRODUCIBLE_20260728_R1\01_MC200_TT_LOW_W4\csv\job_codes\MC200_CMP_XM5_XM6_W8P2524_XM7_XM11_W16P8587_S138_LOW_W4.csv | D:\PICO\A44_SAR_ADC_CURRENT_CACE_REPRODUCIBLE_20260728_R2\02_SIMULATION_RESULTS\01_MC200_TT_LOW_W4\csv\job_codes\MC200_CMP_XM5_XM6_W8P2524_XM7_XM11_W16P8587_S138_LOW_W4.csv | 24322 | 24322 | f6cffa9a56053717ce590e6fb4695045de6e21995f356a5520a18da6e19a39f9 | f6cffa9a56053717ce590e6fb4695045de6e21995f356a5520a18da6e19a39f9 | EXACT_COPY
02_SIMULATION_RESULTS/01_MC200_TT_LOW_W4/csv/job_codes/MC200_CMP_XM5_XM6_W8P2524_XM7_XM11_W16P8587_S139_LOW_W4.csv | D:\PICO\A44_SAR_ADC_CURRENT_CACE_REPRODUCIBLE_20260728_R1\01_MC200_TT_LOW_W4\csv\job_codes\MC200_CMP_XM5_XM6_W8P2524_XM7_XM11_W16P8587_S139_LOW_W4.csv | D:\PICO\A44_SAR_ADC_CURRENT_CACE_REPRODUCIBLE_20260728_R2\02_SIMULATION_RESULTS\01_MC200_TT_LOW_W4\csv\job_codes\MC200_CMP_XM5_XM6_W8P2524_XM7_XM11_W16P8587_S139_LOW_W4.csv | 24322 | 24322 | c032a4fc0d7f34ed48b577a0710b15cb5ddf0ef644f63099305ce1542d59fb00 | c032a4fc0d7f34ed48b577a0710b15cb5ddf0ef644f63099305ce1542d59fb00 | EXACT_COPY
02_SIMULATION_RESULTS/01_MC200_TT_LOW_W4/csv/job_codes/MC200_CMP_XM5_XM6_W8P2524_XM7_XM11_W16P8587_S140_LOW_W4.csv | D:\PICO\A44_SAR_ADC_CURRENT_CACE_REPRODUCIBLE_20260728_R1\01_MC200_TT_LOW_W4\csv\job_codes\MC200_CMP_XM5_XM6_W8P2524_XM7_XM11_W16P8587_S140_LOW_W4.csv | D:\PICO\A44_SAR_ADC_CURRENT_CACE_REPRODUCIBLE_20260728_R2\02_SIMULATION_RESULTS\01_MC200_TT_LOW_W4\csv\job_codes\MC200_CMP_XM5_XM6_W8P2524_XM7_XM11_W16P8587_S140_LOW_W4.csv | 24323 | 24323 | c28f4a69046ce91bf51e98a60366877d41de4abe691165a468d5c4456bc39f89 | c28f4a69046ce91bf51e98a60366877d41de4abe691165a468d5c4456bc39f89 | EXACT_COPY
02_SIMULATION_RESULTS/01_MC200_TT_LOW_W4/csv/job_codes/MC200_CMP_XM5_XM6_W8P2524_XM7_XM11_W16P8587_S141_LOW_W4.csv | D:\PICO\A44_SAR_ADC_CURRENT_CACE_REPRODUCIBLE_20260728_R1\01_MC200_TT_LOW_W4\csv\job_codes\MC200_CMP_XM5_XM6_W8P2524_XM7_XM11_W16P8587_S141_LOW_W4.csv | D:\PICO\A44_SAR_ADC_CURRENT_CACE_REPRODUCIBLE_20260728_R2\02_SIMULATION_RESULTS\01_MC200_TT_LOW_W4\csv\job_codes\MC200_CMP_XM5_XM6_W8P2524_XM7_XM11_W16P8587_S141_LOW_W4.csv | 24317 | 24317 | 30113a377ebba73ffe11cbe8eb349f141ba94bf5a22cf4ae9e116aba68e60dcf | 30113a377ebba73ffe11cbe8eb349f141ba94bf5a22cf4ae9e116aba68e60dcf | EXACT_COPY
02_SIMULATION_RESULTS/01_MC200_TT_LOW_W4/csv/job_codes/MC200_CMP_XM5_XM6_W8P2524_XM7_XM11_W16P8587_S142_LOW_W4.csv | D:\PICO\A44_SAR_ADC_CURRENT_CACE_REPRODUCIBLE_20260728_R1\01_MC200_TT_LOW_W4\csv\job_codes\MC200_CMP_XM5_XM6_W8P2524_XM7_XM11_W16P8587_S142_LOW_W4.csv | D:\PICO\A44_SAR_ADC_CURRENT_CACE_REPRODUCIBLE_20260728_R2\02_SIMULATION_RESULTS\01_MC200_TT_LOW_W4\csv\job_codes\MC200_CMP_XM5_XM6_W8P2524_XM7_XM11_W16P8587_S142_LOW_W4.csv | 24325 | 24325 | 024be0c020dcf82240810d0a57a97de8d8de6ad43f1d2a62b8dfeb9b2a3a6bc8 | 024be0c020dcf82240810d0a57a97de8d8de6ad43f1d2a62b8dfeb9b2a3a6bc8 | EXACT_COPY
02_SIMULATION_RESULTS/01_MC200_TT_LOW_W4/csv/job_codes/MC200_CMP_XM5_XM6_W8P2524_XM7_XM11_W16P8587_S143_LOW_W4.csv | D:\PICO\A44_SAR_ADC_CURRENT_CACE_REPRODUCIBLE_20260728_R1\01_MC200_TT_LOW_W4\csv\job_codes\MC200_CMP_XM5_XM6_W8P2524_XM7_XM11_W16P8587_S143_LOW_W4.csv | D:\PICO\A44_SAR_ADC_CURRENT_CACE_REPRODUCIBLE_20260728_R2\02_SIMULATION_RESULTS\01_MC200_TT_LOW_W4\csv\job_codes\MC200_CMP_XM5_XM6_W8P2524_XM7_XM11_W16P8587_S143_LOW_W4.csv | 24333 | 24333 | f101274c62d1fb1fdc8b7a3203010298027d4411b6d85696592956175bfb3aca | f101274c62d1fb1fdc8b7a3203010298027d4411b6d85696592956175bfb3aca | EXACT_COPY
02_SIMULATION_RESULTS/01_MC200_TT_LOW_W4/csv/job_codes/MC200_CMP_XM5_XM6_W8P2524_XM7_XM11_W16P8587_S144_LOW_W4.csv | D:\PICO\A44_SAR_ADC_CURRENT_CACE_REPRODUCIBLE_20260728_R1\01_MC200_TT_LOW_W4\csv\job_codes\MC200_CMP_XM5_XM6_W8P2524_XM7_XM11_W16P8587_S144_LOW_W4.csv | D:\PICO\A44_SAR_ADC_CURRENT_CACE_REPRODUCIBLE_20260728_R2\02_SIMULATION_RESULTS\01_MC200_TT_LOW_W4\csv\job_codes\MC200_CMP_XM5_XM6_W8P2524_XM7_XM11_W16P8587_S144_LOW_W4.csv | 24324 | 24324 | 49c58335f020bd5dfdb558d247f49a448685d8b430881a856e94b38341d6a65e | 49c58335f020bd5dfdb558d247f49a448685d8b430881a856e94b38341d6a65e | EXACT_COPY
02_SIMULATION_RESULTS/01_MC200_TT_LOW_W4/csv/job_codes/MC200_CMP_XM5_XM6_W8P2524_XM7_XM11_W16P8587_S145_LOW_W4.csv | D:\PICO\A44_SAR_ADC_CURRENT_CACE_REPRODUCIBLE_20260728_R1\01_MC200_TT_LOW_W4\csv\job_codes\MC200_CMP_XM5_XM6_W8P2524_XM7_XM11_W16P8587_S145_LOW_W4.csv | D:\PICO\A44_SAR_ADC_CURRENT_CACE_REPRODUCIBLE_20260728_R2\02_SIMULATION_RESULTS\01_MC200_TT_LOW_W4\csv\job_codes\MC200_CMP_XM5_XM6_W8P2524_XM7_XM11_W16P8587_S145_LOW_W4.csv | 24318 | 24318 | 7f5cd7937342eb162fb03cdf572eb542e0f86bba6645952f6fca72841e518fcb | 7f5cd7937342eb162fb03cdf572eb542e0f86bba6645952f6fca72841e518fcb | EXACT_COPY
02_SIMULATION_RESULTS/01_MC200_TT_LOW_W4/csv/job_codes/MC200_CMP_XM5_XM6_W8P2524_XM7_XM11_W16P8587_S146_LOW_W4.csv | D:\PICO\A44_SAR_ADC_CURRENT_CACE_REPRODUCIBLE_20260728_R1\01_MC200_TT_LOW_W4\csv\job_codes\MC200_CMP_XM5_XM6_W8P2524_XM7_XM11_W16P8587_S146_LOW_W4.csv | D:\PICO\A44_SAR_ADC_CURRENT_CACE_REPRODUCIBLE_20260728_R2\02_SIMULATION_RESULTS\01_MC200_TT_LOW_W4\csv\job_codes\MC200_CMP_XM5_XM6_W8P2524_XM7_XM11_W16P8587_S146_LOW_W4.csv | 24322 | 24322 | fb2c0cecf0f7f7621a141368fd8897933370d928de1081dad5834a1ef0479696 | fb2c0cecf0f7f7621a141368fd8897933370d928de1081dad5834a1ef0479696 | EXACT_COPY
02_SIMULATION_RESULTS/01_MC200_TT_LOW_W4/csv/job_codes/MC200_CMP_XM5_XM6_W8P2524_XM7_XM11_W16P8587_S147_LOW_W4.csv | D:\PICO\A44_SAR_ADC_CURRENT_CACE_REPRODUCIBLE_20260728_R1\01_MC200_TT_LOW_W4\csv\job_codes\MC200_CMP_XM5_XM6_W8P2524_XM7_XM11_W16P8587_S147_LOW_W4.csv | D:\PICO\A44_SAR_ADC_CURRENT_CACE_REPRODUCIBLE_20260728_R2\02_SIMULATION_RESULTS\01_MC200_TT_LOW_W4\csv\job_codes\MC200_CMP_XM5_XM6_W8P2524_XM7_XM11_W16P8587_S147_LOW_W4.csv | 24320 | 24320 | 30d96e2463eaa8822976625d1555e4b607f53f4979653d1a261de9c9bdfcef79 | 30d96e2463eaa8822976625d1555e4b607f53f4979653d1a261de9c9bdfcef79 | EXACT_COPY
02_SIMULATION_RESULTS/01_MC200_TT_LOW_W4/csv/job_codes/MC200_CMP_XM5_XM6_W8P2524_XM7_XM11_W16P8587_S148_LOW_W4.csv | D:\PICO\A44_SAR_ADC_CURRENT_CACE_REPRODUCIBLE_20260728_R1\01_MC200_TT_LOW_W4\csv\job_codes\MC200_CMP_XM5_XM6_W8P2524_XM7_XM11_W16P8587_S148_LOW_W4.csv | D:\PICO\A44_SAR_ADC_CURRENT_CACE_REPRODUCIBLE_20260728_R2\02_SIMULATION_RESULTS\01_MC200_TT_LOW_W4\csv\job_codes\MC200_CMP_XM5_XM6_W8P2524_XM7_XM11_W16P8587_S148_LOW_W4.csv | 24319 | 24319 | bac852d80bf179d33036c1c832d358ecf191d87de0a53f0c345f2c220c92c659 | bac852d80bf179d33036c1c832d358ecf191d87de0a53f0c345f2c220c92c659 | EXACT_COPY
02_SIMULATION_RESULTS/01_MC200_TT_LOW_W4/csv/job_codes/MC200_CMP_XM5_XM6_W8P2524_XM7_XM11_W16P8587_S149_LOW_W4.csv | D:\PICO\A44_SAR_ADC_CURRENT_CACE_REPRODUCIBLE_20260728_R1\01_MC200_TT_LOW_W4\csv\job_codes\MC200_CMP_XM5_XM6_W8P2524_XM7_XM11_W16P8587_S149_LOW_W4.csv | D:\PICO\A44_SAR_ADC_CURRENT_CACE_REPRODUCIBLE_20260728_R2\02_SIMULATION_RESULTS\01_MC200_TT_LOW_W4\csv\job_codes\MC200_CMP_XM5_XM6_W8P2524_XM7_XM11_W16P8587_S149_LOW_W4.csv | 24320 | 24320 | 82e253951707b09e601e6b2726c1745db673b06bc9e58dbf3af892bb5efb2f9d | 82e253951707b09e601e6b2726c1745db673b06bc9e58dbf3af892bb5efb2f9d | EXACT_COPY
02_SIMULATION_RESULTS/01_MC200_TT_LOW_W4/csv/job_codes/MC200_CMP_XM5_XM6_W8P2524_XM7_XM11_W16P8587_S150_LOW_W4.csv | D:\PICO\A44_SAR_ADC_CURRENT_CACE_REPRODUCIBLE_20260728_R1\01_MC200_TT_LOW_W4\csv\job_codes\MC200_CMP_XM5_XM6_W8P2524_XM7_XM11_W16P8587_S150_LOW_W4.csv | D:\PICO\A44_SAR_ADC_CURRENT_CACE_REPRODUCIBLE_20260728_R2\02_SIMULATION_RESULTS\01_MC200_TT_LOW_W4\csv\job_codes\MC200_CMP_XM5_XM6_W8P2524_XM7_XM11_W16P8587_S150_LOW_W4.csv | 24327 | 24327 | cc8f9b5a7ccb890949b42bcac344b69492e01b0b6611960e98615bbfea06c567 | cc8f9b5a7ccb890949b42bcac344b69492e01b0b6611960e98615bbfea06c567 | EXACT_COPY
02_SIMULATION_RESULTS/01_MC200_TT_LOW_W4/csv/job_codes/MC200_CMP_XM5_XM6_W8P2524_XM7_XM11_W16P8587_S151_LOW_W4.csv | D:\PICO\A44_SAR_ADC_CURRENT_CACE_REPRODUCIBLE_20260728_R1\01_MC200_TT_LOW_W4\csv\job_codes\MC200_CMP_XM5_XM6_W8P2524_XM7_XM11_W16P8587_S151_LOW_W4.csv | D:\PICO\A44_SAR_ADC_CURRENT_CACE_REPRODUCIBLE_20260728_R2\02_SIMULATION_RESULTS\01_MC200_TT_LOW_W4\csv\job_codes\MC200_CMP_XM5_XM6_W8P2524_XM7_XM11_W16P8587_S151_LOW_W4.csv | 24326 | 24326 | 14401b840ac29d42dbea2b77292cf558d86aba15ed7b4d47911bbf763b869a04 | 14401b840ac29d42dbea2b77292cf558d86aba15ed7b4d47911bbf763b869a04 | EXACT_COPY
02_SIMULATION_RESULTS/01_MC200_TT_LOW_W4/csv/job_codes/MC200_CMP_XM5_XM6_W8P2524_XM7_XM11_W16P8587_S152_LOW_W4.csv | D:\PICO\A44_SAR_ADC_CURRENT_CACE_REPRODUCIBLE_20260728_R1\01_MC200_TT_LOW_W4\csv\job_codes\MC200_CMP_XM5_XM6_W8P2524_XM7_XM11_W16P8587_S152_LOW_W4.csv | D:\PICO\A44_SAR_ADC_CURRENT_CACE_REPRODUCIBLE_20260728_R2\02_SIMULATION_RESULTS\01_MC200_TT_LOW_W4\csv\job_codes\MC200_CMP_XM5_XM6_W8P2524_XM7_XM11_W16P8587_S152_LOW_W4.csv | 24314 | 24314 | 53528a962eb3803806846a90383065886a40fd3f50986a5aa2407d973e2bca7d | 53528a962eb3803806846a90383065886a40fd3f50986a5aa2407d973e2bca7d | EXACT_COPY
02_SIMULATION_RESULTS/01_MC200_TT_LOW_W4/csv/job_codes/MC200_CMP_XM5_XM6_W8P2524_XM7_XM11_W16P8587_S153_LOW_W4.csv | D:\PICO\A44_SAR_ADC_CURRENT_CACE_REPRODUCIBLE_20260728_R1\01_MC200_TT_LOW_W4\csv\job_codes\MC200_CMP_XM5_XM6_W8P2524_XM7_XM11_W16P8587_S153_LOW_W4.csv | D:\PICO\A44_SAR_ADC_CURRENT_CACE_REPRODUCIBLE_20260728_R2\02_SIMULATION_RESULTS\01_MC200_TT_LOW_W4\csv\job_codes\MC200_CMP_XM5_XM6_W8P2524_XM7_XM11_W16P8587_S153_LOW_W4.csv | 24333 | 24333 | 7d09eeb406f3ed258f957c456a9f10464e8a0f82f2b2a98ec573871ad0ad6281 | 7d09eeb406f3ed258f957c456a9f10464e8a0f82f2b2a98ec573871ad0ad6281 | EXACT_COPY
02_SIMULATION_RESULTS/01_MC200_TT_LOW_W4/csv/job_codes/MC200_CMP_XM5_XM6_W8P2524_XM7_XM11_W16P8587_S154_LOW_W4.csv | D:\PICO\A44_SAR_ADC_CURRENT_CACE_REPRODUCIBLE_20260728_R1\01_MC200_TT_LOW_W4\csv\job_codes\MC200_CMP_XM5_XM6_W8P2524_XM7_XM11_W16P8587_S154_LOW_W4.csv | D:\PICO\A44_SAR_ADC_CURRENT_CACE_REPRODUCIBLE_20260728_R2\02_SIMULATION_RESULTS\01_MC200_TT_LOW_W4\csv\job_codes\MC200_CMP_XM5_XM6_W8P2524_XM7_XM11_W16P8587_S154_LOW_W4.csv | 24327 | 24327 | 76b5926e2cfe20a1a9c516238e59848da0046ce25422b7c118b4c068fd33b5a9 | 76b5926e2cfe20a1a9c516238e59848da0046ce25422b7c118b4c068fd33b5a9 | EXACT_COPY
02_SIMULATION_RESULTS/01_MC200_TT_LOW_W4/csv/job_codes/MC200_CMP_XM5_XM6_W8P2524_XM7_XM11_W16P8587_S155_LOW_W4.csv | D:\PICO\A44_SAR_ADC_CURRENT_CACE_REPRODUCIBLE_20260728_R1\01_MC200_TT_LOW_W4\csv\job_codes\MC200_CMP_XM5_XM6_W8P2524_XM7_XM11_W16P8587_S155_LOW_W4.csv | D:\PICO\A44_SAR_ADC_CURRENT_CACE_REPRODUCIBLE_20260728_R2\02_SIMULATION_RESULTS\01_MC200_TT_LOW_W4\csv\job_codes\MC200_CMP_XM5_XM6_W8P2524_XM7_XM11_W16P8587_S155_LOW_W4.csv | 24314 | 24314 | 884d50ecf5e20f80deba9db9977272891efd460f7eaf5f2da5e292db1740d65a | 884d50ecf5e20f80deba9db9977272891efd460f7eaf5f2da5e292db1740d65a | EXACT_COPY
02_SIMULATION_RESULTS/01_MC200_TT_LOW_W4/csv/job_codes/MC200_CMP_XM5_XM6_W8P2524_XM7_XM11_W16P8587_S156_LOW_W4.csv | D:\PICO\A44_SAR_ADC_CURRENT_CACE_REPRODUCIBLE_20260728_R1\01_MC200_TT_LOW_W4\csv\job_codes\MC200_CMP_XM5_XM6_W8P2524_XM7_XM11_W16P8587_S156_LOW_W4.csv | D:\PICO\A44_SAR_ADC_CURRENT_CACE_REPRODUCIBLE_20260728_R2\02_SIMULATION_RESULTS\01_MC200_TT_LOW_W4\csv\job_codes\MC200_CMP_XM5_XM6_W8P2524_XM7_XM11_W16P8587_S156_LOW_W4.csv | 24317 | 24317 | 4581b1322bed04052c69ae6ed8dcbb173639cfdedea7d3508609d2bd76c9f5dd | 4581b1322bed04052c69ae6ed8dcbb173639cfdedea7d3508609d2bd76c9f5dd | EXACT_COPY
02_SIMULATION_RESULTS/01_MC200_TT_LOW_W4/csv/job_codes/MC200_CMP_XM5_XM6_W8P2524_XM7_XM11_W16P8587_S157_LOW_W4.csv | D:\PICO\A44_SAR_ADC_CURRENT_CACE_REPRODUCIBLE_20260728_R1\01_MC200_TT_LOW_W4\csv\job_codes\MC200_CMP_XM5_XM6_W8P2524_XM7_XM11_W16P8587_S157_LOW_W4.csv | D:\PICO\A44_SAR_ADC_CURRENT_CACE_REPRODUCIBLE_20260728_R2\02_SIMULATION_RESULTS\01_MC200_TT_LOW_W4\csv\job_codes\MC200_CMP_XM5_XM6_W8P2524_XM7_XM11_W16P8587_S157_LOW_W4.csv | 24329 | 24329 | 3971db67ef4f1f9520c145b55d542f2778fb315861a06baf30c3eb76b67aaf30 | 3971db67ef4f1f9520c145b55d542f2778fb315861a06baf30c3eb76b67aaf30 | EXACT_COPY
02_SIMULATION_RESULTS/01_MC200_TT_LOW_W4/csv/job_codes/MC200_CMP_XM5_XM6_W8P2524_XM7_XM11_W16P8587_S158_LOW_W4.csv | D:\PICO\A44_SAR_ADC_CURRENT_CACE_REPRODUCIBLE_20260728_R1\01_MC200_TT_LOW_W4\csv\job_codes\MC200_CMP_XM5_XM6_W8P2524_XM7_XM11_W16P8587_S158_LOW_W4.csv | D:\PICO\A44_SAR_ADC_CURRENT_CACE_REPRODUCIBLE_20260728_R2\02_SIMULATION_RESULTS\01_MC200_TT_LOW_W4\csv\job_codes\MC200_CMP_XM5_XM6_W8P2524_XM7_XM11_W16P8587_S158_LOW_W4.csv | 24326 | 24326 | 8469595d2dc118125f7dd8f0131201dab90c35e0eae89480ea6229123f68e996 | 8469595d2dc118125f7dd8f0131201dab90c35e0eae89480ea6229123f68e996 | EXACT_COPY
02_SIMULATION_RESULTS/01_MC200_TT_LOW_W4/csv/job_codes/MC200_CMP_XM5_XM6_W8P2524_XM7_XM11_W16P8587_S159_LOW_W4.csv | D:\PICO\A44_SAR_ADC_CURRENT_CACE_REPRODUCIBLE_20260728_R1\01_MC200_TT_LOW_W4\csv\job_codes\MC200_CMP_XM5_XM6_W8P2524_XM7_XM11_W16P8587_S159_LOW_W4.csv | D:\PICO\A44_SAR_ADC_CURRENT_CACE_REPRODUCIBLE_20260728_R2\02_SIMULATION_RESULTS\01_MC200_TT_LOW_W4\csv\job_codes\MC200_CMP_XM5_XM6_W8P2524_XM7_XM11_W16P8587_S159_LOW_W4.csv | 24318 | 24318 | 512537ac685896edb9bfe45edbd471e2f8c9fb00f9e40d3ce1c48153359ecea6 | 512537ac685896edb9bfe45edbd471e2f8c9fb00f9e40d3ce1c48153359ecea6 | EXACT_COPY
02_SIMULATION_RESULTS/01_MC200_TT_LOW_W4/csv/job_codes/MC200_CMP_XM5_XM6_W8P2524_XM7_XM11_W16P8587_S160_LOW_W4.csv | D:\PICO\A44_SAR_ADC_CURRENT_CACE_REPRODUCIBLE_20260728_R1\01_MC200_TT_LOW_W4\csv\job_codes\MC200_CMP_XM5_XM6_W8P2524_XM7_XM11_W16P8587_S160_LOW_W4.csv | D:\PICO\A44_SAR_ADC_CURRENT_CACE_REPRODUCIBLE_20260728_R2\02_SIMULATION_RESULTS\01_MC200_TT_LOW_W4\csv\job_codes\MC200_CMP_XM5_XM6_W8P2524_XM7_XM11_W16P8587_S160_LOW_W4.csv | 24314 | 24314 | fce29c042435dd3e98c7a3b75c445afbedaed0861627abdbe7a2040a6bda9618 | fce29c042435dd3e98c7a3b75c445afbedaed0861627abdbe7a2040a6bda9618 | EXACT_COPY
02_SIMULATION_RESULTS/01_MC200_TT_LOW_W4/csv/job_codes/MC200_CMP_XM5_XM6_W8P2524_XM7_XM11_W16P8587_S161_LOW_W4.csv | D:\PICO\A44_SAR_ADC_CURRENT_CACE_REPRODUCIBLE_20260728_R1\01_MC200_TT_LOW_W4\csv\job_codes\MC200_CMP_XM5_XM6_W8P2524_XM7_XM11_W16P8587_S161_LOW_W4.csv | D:\PICO\A44_SAR_ADC_CURRENT_CACE_REPRODUCIBLE_20260728_R2\02_SIMULATION_RESULTS\01_MC200_TT_LOW_W4\csv\job_codes\MC200_CMP_XM5_XM6_W8P2524_XM7_XM11_W16P8587_S161_LOW_W4.csv | 24319 | 24319 | 170acdd95933c88cb2f894718ea99fd33eedae9df46246cc8fb753fb3cdd0bb4 | 170acdd95933c88cb2f894718ea99fd33eedae9df46246cc8fb753fb3cdd0bb4 | EXACT_COPY
02_SIMULATION_RESULTS/01_MC200_TT_LOW_W4/csv/job_codes/MC200_CMP_XM5_XM6_W8P2524_XM7_XM11_W16P8587_S162_LOW_W4.csv | D:\PICO\A44_SAR_ADC_CURRENT_CACE_REPRODUCIBLE_20260728_R1\01_MC200_TT_LOW_W4\csv\job_codes\MC200_CMP_XM5_XM6_W8P2524_XM7_XM11_W16P8587_S162_LOW_W4.csv | D:\PICO\A44_SAR_ADC_CURRENT_CACE_REPRODUCIBLE_20260728_R2\02_SIMULATION_RESULTS\01_MC200_TT_LOW_W4\csv\job_codes\MC200_CMP_XM5_XM6_W8P2524_XM7_XM11_W16P8587_S162_LOW_W4.csv | 24321 | 24321 | e1038e0ef49c695918aefc540e1d007f871c5e990e926bb85f6934ee0626976d | e1038e0ef49c695918aefc540e1d007f871c5e990e926bb85f6934ee0626976d | EXACT_COPY
02_SIMULATION_RESULTS/01_MC200_TT_LOW_W4/csv/job_codes/MC200_CMP_XM5_XM6_W8P2524_XM7_XM11_W16P8587_S163_LOW_W4.csv | D:\PICO\A44_SAR_ADC_CURRENT_CACE_REPRODUCIBLE_20260728_R1\01_MC200_TT_LOW_W4\csv\job_codes\MC200_CMP_XM5_XM6_W8P2524_XM7_XM11_W16P8587_S163_LOW_W4.csv | D:\PICO\A44_SAR_ADC_CURRENT_CACE_REPRODUCIBLE_20260728_R2\02_SIMULATION_RESULTS\01_MC200_TT_LOW_W4\csv\job_codes\MC200_CMP_XM5_XM6_W8P2524_XM7_XM11_W16P8587_S163_LOW_W4.csv | 24319 | 24319 | 3b31d6dfa903e659414877f0c7c1eae0862379d3ba6efb6ec8d950f9fc2f2cbe | 3b31d6dfa903e659414877f0c7c1eae0862379d3ba6efb6ec8d950f9fc2f2cbe | EXACT_COPY
02_SIMULATION_RESULTS/01_MC200_TT_LOW_W4/csv/job_codes/MC200_CMP_XM5_XM6_W8P2524_XM7_XM11_W16P8587_S164_LOW_W4.csv | D:\PICO\A44_SAR_ADC_CURRENT_CACE_REPRODUCIBLE_20260728_R1\01_MC200_TT_LOW_W4\csv\job_codes\MC200_CMP_XM5_XM6_W8P2524_XM7_XM11_W16P8587_S164_LOW_W4.csv | D:\PICO\A44_SAR_ADC_CURRENT_CACE_REPRODUCIBLE_20260728_R2\02_SIMULATION_RESULTS\01_MC200_TT_LOW_W4\csv\job_codes\MC200_CMP_XM5_XM6_W8P2524_XM7_XM11_W16P8587_S164_LOW_W4.csv | 24320 | 24320 | 3f3196e7d11ecaa107f27e573d680e67c189d06efa2b94614f6e0578cf3872a2 | 3f3196e7d11ecaa107f27e573d680e67c189d06efa2b94614f6e0578cf3872a2 | EXACT_COPY
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
