tritone4801/chipathon-2026-A44-SAR-ADC/verification/a44_r2/04_PACKAGE_DOCS/METHOD_AND_PERFORMANCE_SUMMARY_CN.md

# 固定仿真方法、已完成内容和性能指标

## 1. 200 样本蒙特卡洛失配动态仿真

- 条件：典型工艺角、3.3 伏、27 摄氏度、低差分输入区间；
- 最大瞬态步长：50 皮秒；
- 样本：失配种子 1 至 200，事件噪声种子为 100000 加失配种子；
- 每个作业：68 帧；
- 第 0 至第 3 帧：首次转换和启动诊断；
- 第 4 至第 67 帧：正式稳态统计窗口，共 64 帧；
- 完成度：200/200，无执行异常；
- 硬动态判定：197 个通过，3 个未通过；
- 未通过种子：65、68、141；
- 信号噪声失真比第一、第五、第十百分位和中位数分别为
  46.8729、47.2961、47.4636 和 48.4065 分贝。

该结果只覆盖低差分输入区间，不能表述为双输入区间的芯片级良率。

结果位于
`02_SIMULATION_RESULTS/01_MC200_TT_LOW_W4`。

## 2. 三工艺电压温度角动态仿真，每角 20 个选定蒙特卡洛失配样本

该仿真采用与上一节相同的 68 帧动态方法、50 皮秒最大瞬态步长，以及
第 4 至第 67 帧正式稳态统计窗口。

- 典型工艺角、3.3 伏、27 摄氏度：19/20 硬动态通过，信号噪声失真比中位数为 48.4048 分贝；
- 慢速工艺角、3.0 伏、125 摄氏度：20/20 硬动态通过，信号噪声失真比中位数为 48.3026 分贝；
- 快速工艺角、3.6 伏、负 40 摄氏度：20/20 硬动态通过，信号噪声失真比中位数为 48.6010 分贝。

全部 60 个作业均完成。这些选定样本用于工艺角诊断，不代表 200 样本
总体、生产良率、晋级或签核结果。

结果位于
`02_SIMULATION_RESULTS/02_PVT3_MC20_LOW_W4`。

## 3. 完整 255 个码间转换静态传输曲线仿真

每条曲线完成 255 个码间转换搜索。种子 44 在典型工艺角、3.3 伏、
27 摄氏度下的曲线是唯一静态资格判定依据。

| 工艺角与工作条件 | 种子 | 最大绝对微分非线性 | 最大绝对积分非线性 | 缺失码 | 反转 | 用途 |
| --- | ---: | ---: | ---: | ---: | ---: | --- |
| 典型工艺角、3.3 伏、27 摄氏度 | 44 | 0.610351 个最低有效位 | 0.686645 个最低有效位 | 0 | 0 | 通过，唯一资格依据 |
| 典型工艺角、3.3 伏、27 摄氏度 | 116 | 0.422577 个最低有效位 | 0.358017 个最低有效位 | 0 | 0 | 仅诊断 |
| 典型工艺角、3.3 伏、27 摄氏度 | 180 | 0.469508 个最低有效位 | 0.451902 个最低有效位 | 0 | 0 | 仅诊断 |
| 典型工艺角、3.3 伏、27 摄氏度 | 106 | 0.146719 个最低有效位 | 0.093900 个最低有效位 | 0 | 0 | 仅诊断 |
| 慢速工艺角、3.0 伏、125 摄氏度 | 44 | 1.496350 个最低有效位 | 1.572634 个最低有效位 | 1 | 1 | 仅诊断 |
| 快速工艺角、3.6 伏、负 40 摄氏度 | 44 | 0.328772 个最低有效位 | 0.416836 个最低有效位 | 0 | 0 | 仅诊断 |

结果位于 `02_SIMULATION_RESULTS` 下的完整静态传输曲线仿真子目录。

## 4. Circuit Automatic Characterization Engine 与快速结果复现

- Circuit Automatic Characterization Engine 2.9 完成 Xschem 到 ngspice 的包预运行，最终电压为 1.250 伏，允许范围为 1.249 至 1.251 伏；
- 200 样本蒙特卡洛失配动态仿真比较 25 条记录；
- 三工艺电压温度角动态仿真比较 75 条记录；
- 6 条完整静态传输曲线比较 30 条记录；
- 合计 130/130 条记录一致。

## 5. 最终结论边界

所有规定仿真均已执行，但整体电气性能没有达到完整晋级要求：200 样本
蒙特卡洛失配动态仿真有 3 个硬动态失败。种子 44 的慢速工艺角静态曲线
保留为诊断信息，但不是静态资格判定依据。

成功完成仿真和快速结果复现不等于性能通过，也不构成寄生提取、版图、
硅片、生产良率、流片或签核结论。
