tritone4801/chipathon-2026-A44-SAR-ADC/verification/a44_r2/02_SIMULATION_RESULTS/06_RUN_OUTPUTS/FULL_20260728T182312Z/cace_runs/RUN_2026-07-28_20-24-57/parameters/A44_PACKAGE_CACE_PREFLIGHT/simulation_summary.md

# Simulation Summary for A44 package CACE and ngspice preflight

| run | index | final_v |
| :-- | ----: | ---: |
| run_0 | 0.000 | 1.250 |
