tritone4801/chipathon-2026-A44-SAR-ADC/verification/a44_r2/02_SIMULATION_RESULTS/02_PVT3_MC20_LOW_W4/plots/pvt3_mc20_ecdf.pdf

48.0 48.5 49.0 49.5 50.0 50.5 51.0 SNR (dB)

0.2

0.4

0.6

0.8

1.0

ECDF i/N

TT
SS FF

47.0 47.5 48.0 48.5 49.0 49.5 50.0 SNDR (dB)

0.2

0.4

0.6

0.8

1.0

ECDF i/N

7.5 | 7.6 | 7.7 | 7.8 | 7.9 | 8.0
Raw ENOB (bit)

0.2

0.4

0.6

0.8

1.0

ECDF i/N

### Selected MC20 descriptive ECDF by analog PVT (not yield)
