tritone4801/chipathon-2026-A44-SAR-ADC/verification/a44_r2/02_SIMULATION_RESULTS/02_PVT3_MC20_LOW_W4/plots/pvt3_mc20_paired_sndr_delta.pdf

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

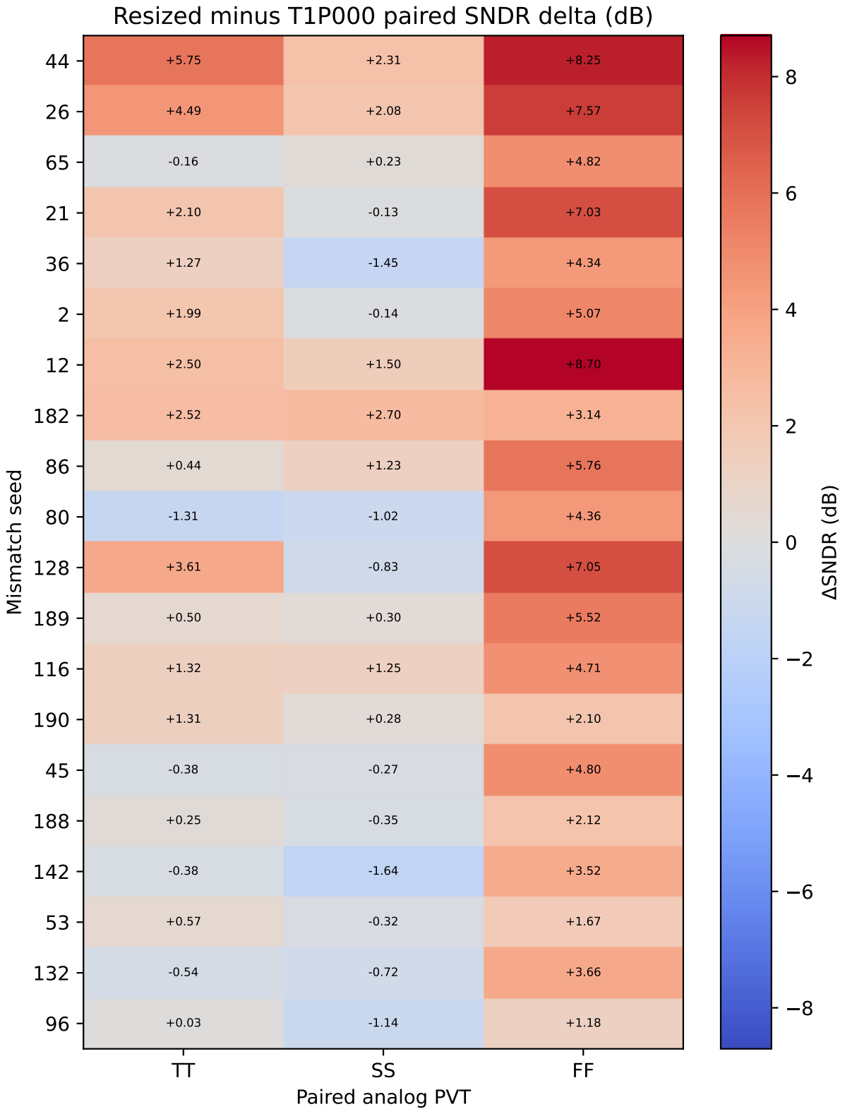
[picture p36: page 1]
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
