tritone4801/chipathon-2026-A44-SAR-ADC/verification/a44_r2/05_PACKAGE_AUDIT/package_manifest_sha256.csv

relative_path | size_bytes | sha256
01_CURRENT_CIRCUIT_FILES/.complete | 240 | c1cd09d2f70f27dc798addd1cd246fd4423c180aa771814d4be4ff156af49e4b
01_CURRENT_CIRCUIT_FILES/audits/CURRENT_HIERARCHY_AUDIT.json | 2987 | 2a60f1e4e1f823aa61b2cb6c7d6ec8456a17641fd5f2ac372255df30a92d58bc
01_CURRENT_CIRCUIT_FILES/indexes/CURRENT_FILE_INDEX.csv | 5896 | 77f3fa5e0e5efdcf1c0f8b6bed9ef8eec010664885cc4ead75937092d4e888ae
01_CURRENT_CIRCUIT_FILES/manifests/manifest_audit.json | 470 | c4be9d87f9702b695fb5f19a41eb000055f139fe3f5d95a5a9faa443a25dceae
01_CURRENT_CIRCUIT_FILES/manifests/package_manifest_sha256.csv | 2374 | 534542afca9931f86c1d78efd552a597fa0174e5448bd84a66c6253b2905b83b
01_CURRENT_CIRCUIT_FILES/README_CN.md | 2615 | b2cad58f3de03c70463b9dd3a00ea79079f19f58bc921a7941648b20e3d7a515
01_CURRENT_CIRCUIT_FILES/rtl/sar_logic_async_core_RTL.sv | 7383 | be43ce73959afb150e9987401eccf6aecb38c8e29d4ad5b780525b6b5e90afb9
01_CURRENT_CIRCUIT_FILES/spice/SAR_ADC_TOP_FIXED.spice | 876 | 275faef84fe26cd85b6ecb62bd0a7c1db050f186b07fb109dc650d82e52843cd
01_CURRENT_CIRCUIT_FILES/spice/subckts/CDAC_native_extracted.subckt.spice | 4365 | 6e98da540b1c765b0dcec4d1e10399142dc37b7f1c21960d289a83f07ec10ada
01_CURRENT_CIRCUIT_FILES/spice/subckts/Comparator_StrongARM_extracted.subckt.spice | 3906 | 53f26155df31b8d1f50dd1bc99a17a6530de29233c11faabe63906debd1b5b49
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
02_SIMULATION_RESULTS/01_MC200_TT_LOW_W4/csv/codes_all_13600.csv | 4800985 | d98c00ade9e955ca7861ed9f409c82e5069620885446426c6ebc20943769e11d
02_SIMULATION_RESULTS/01_MC200_TT_LOW_W4/csv/codes_fft_retained_12800.csv | 4522932 | 73e7fc9fe837a807ae020fb3fce77ba03edd81c19bc1de2c823a1486593f2d00
02_SIMULATION_RESULTS/01_MC200_TT_LOW_W4/csv/first_conversion_path_1600.csv | 981911 | bd4ae93883b0067e92b1d04d801d52df478812d21ffa185b3865fa9915783075
02_SIMULATION_RESULTS/01_MC200_TT_LOW_W4/csv/job_codes/MC200_CMP_XM5_XM6_W8P2524_XM7_XM11_W16P8587_S001_LOW_W4.csv | 24196 | 782bc5f5781a70bb8e686833378128166631ddf302ad67ea1dc92f8df2fd8f32
02_SIMULATION_RESULTS/01_MC200_TT_LOW_W4/csv/job_codes/MC200_CMP_XM5_XM6_W8P2524_XM7_XM11_W16P8587_S002_LOW_W4.csv | 24184 | 3206903252b3786023826dac7031edfc8c7af13113cdcf6c17b6fea744e3d351
02_SIMULATION_RESULTS/01_MC200_TT_LOW_W4/csv/job_codes/MC200_CMP_XM5_XM6_W8P2524_XM7_XM11_W16P8587_S003_LOW_W4.csv | 24182 | 98d8a5bf35222c2def78fd3b37780b867f5c916c8b9a730dc38fe4542a9a4b5a
02_SIMULATION_RESULTS/01_MC200_TT_LOW_W4/csv/job_codes/MC200_CMP_XM5_XM6_W8P2524_XM7_XM11_W16P8587_S004_LOW_W4.csv | 24196 | 1a34f1f66c43b89b26b0d8f9d16d948fbdd915fd2621a76f7a1d31a21c4a0d00
02_SIMULATION_RESULTS/01_MC200_TT_LOW_W4/csv/job_codes/MC200_CMP_XM5_XM6_W8P2524_XM7_XM11_W16P8587_S005_LOW_W4.csv | 24175 | d50deab48fc94d264ac3d3f642364c1a4699840f190c19b5f20fca861a5a8410
02_SIMULATION_RESULTS/01_MC200_TT_LOW_W4/csv/job_codes/MC200_CMP_XM5_XM6_W8P2524_XM7_XM11_W16P8587_S006_LOW_W4.csv | 24184 | 3740b4465e0692d6ec7bc272e3dfcefe21399f5703d96e8cf9b1294db6d12d42
02_SIMULATION_RESULTS/01_MC200_TT_LOW_W4/csv/job_codes/MC200_CMP_XM5_XM6_W8P2524_XM7_XM11_W16P8587_S007_LOW_W4.csv | 24177 | 14f725195501436cf1302a3293d6b1eb565c86948145b547021675e002887716
02_SIMULATION_RESULTS/01_MC200_TT_LOW_W4/csv/job_codes/MC200_CMP_XM5_XM6_W8P2524_XM7_XM11_W16P8587_S008_LOW_W4.csv | 24177 | 8549b0f38fd3f03bae9261c376f36d757e2848be5cdea9d764b3a8eed5f1e54d
02_SIMULATION_RESULTS/01_MC200_TT_LOW_W4/csv/job_codes/MC200_CMP_XM5_XM6_W8P2524_XM7_XM11_W16P8587_S009_LOW_W4.csv | 24189 | 15d0bfb474d6901c7218ca319d4532ad0adda9d7b11d51e6af1ccdfca02908b7
02_SIMULATION_RESULTS/01_MC200_TT_LOW_W4/csv/job_codes/MC200_CMP_XM5_XM6_W8P2524_XM7_XM11_W16P8587_S010_LOW_W4.csv | 24234 | a27d68dbd515a6f5ee6446efa887dcc91a7cf5233d5e9f5d7a9997704d1eb75c
02_SIMULATION_RESULTS/01_MC200_TT_LOW_W4/csv/job_codes/MC200_CMP_XM5_XM6_W8P2524_XM7_XM11_W16P8587_S011_LOW_W4.csv | 24243 | d74c2cf244f934bad7f2994f033c733a8f5c3f6275a14681fc8587da3a2332a4
02_SIMULATION_RESULTS/01_MC200_TT_LOW_W4/csv/job_codes/MC200_CMP_XM5_XM6_W8P2524_XM7_XM11_W16P8587_S012_LOW_W4.csv | 24255 | 2f73b170dc1ea678810be05da1b8ffb4faf50f49537d4d21775403d6c05a06c9
02_SIMULATION_RESULTS/01_MC200_TT_LOW_W4/csv/job_codes/MC200_CMP_XM5_XM6_W8P2524_XM7_XM11_W16P8587_S013_LOW_W4.csv | 24252 | 28703bd8d1cd18f6f5fc07a4ee4d4d32fef7a3303bac99431f84d2df63ca26c8
02_SIMULATION_RESULTS/01_MC200_TT_LOW_W4/csv/job_codes/MC200_CMP_XM5_XM6_W8P2524_XM7_XM11_W16P8587_S014_LOW_W4.csv | 24249 | 449291c642219a0226af510db51abc724ab893041d6841057f6315725963f4b0
02_SIMULATION_RESULTS/01_MC200_TT_LOW_W4/csv/job_codes/MC200_CMP_XM5_XM6_W8P2524_XM7_XM11_W16P8587_S015_LOW_W4.csv | 24255 | 35b32d1abe21df97068856155d895578e681b74f217414476015f069adb36bea
02_SIMULATION_RESULTS/01_MC200_TT_LOW_W4/csv/job_codes/MC200_CMP_XM5_XM6_W8P2524_XM7_XM11_W16P8587_S016_LOW_W4.csv | 24239 | 7fcbe467dcf1d494b388bd215ee2ec5b51dac2607b3d847a8eda7cb70f507b97
02_SIMULATION_RESULTS/01_MC200_TT_LOW_W4/csv/job_codes/MC200_CMP_XM5_XM6_W8P2524_XM7_XM11_W16P8587_S017_LOW_W4.csv | 24258 | 79c37a57d9c1f78f5a578ebca270ab13161ff1eeb4f38032b75d2f7b97faea7a
02_SIMULATION_RESULTS/01_MC200_TT_LOW_W4/csv/job_codes/MC200_CMP_XM5_XM6_W8P2524_XM7_XM11_W16P8587_S018_LOW_W4.csv | 24252 | a64a61c8d3c61858789ad284c601d19a3e9ae02bd14cbb9106b9f8e4cc0ea96b
02_SIMULATION_RESULTS/01_MC200_TT_LOW_W4/csv/job_codes/MC200_CMP_XM5_XM6_W8P2524_XM7_XM11_W16P8587_S019_LOW_W4.csv | 24250 | 5c4e1289cc86f388006eaf8771b9be639b749ed800e2a73b1ae492ae22cd1b21
02_SIMULATION_RESULTS/01_MC200_TT_LOW_W4/csv/job_codes/MC200_CMP_XM5_XM6_W8P2524_XM7_XM11_W16P8587_S020_LOW_W4.csv | 24259 | 1e5cfd0123c99ce704b3dc6539c0074cf5d75da8f03375b9a44162a957da3846
02_SIMULATION_RESULTS/01_MC200_TT_LOW_W4/csv/job_codes/MC200_CMP_XM5_XM6_W8P2524_XM7_XM11_W16P8587_S021_LOW_W4.csv | 24255 | 753403a45b242155bc3569cab53d3b20e43d23cd54de19a112dca540807a5ae3
02_SIMULATION_RESULTS/01_MC200_TT_LOW_W4/csv/job_codes/MC200_CMP_XM5_XM6_W8P2524_XM7_XM11_W16P8587_S022_LOW_W4.csv | 24251 | 0f528f3e1a9b6820a693978fa3e34d26fbe095d9cb363df07357a448763771b4
02_SIMULATION_RESULTS/01_MC200_TT_LOW_W4/csv/job_codes/MC200_CMP_XM5_XM6_W8P2524_XM7_XM11_W16P8587_S023_LOW_W4.csv | 24254 | b2f48cbd085bff6648a818f99fabb5fa5fe55dd5228b41b02fb345030f798ec0
02_SIMULATION_RESULTS/01_MC200_TT_LOW_W4/csv/job_codes/MC200_CMP_XM5_XM6_W8P2524_XM7_XM11_W16P8587_S024_LOW_W4.csv | 24258 | 04a846adbde6a813937a00e3d419aeee8f7875d9f9e9035f9acd4c0a30852330
02_SIMULATION_RESULTS/01_MC200_TT_LOW_W4/csv/job_codes/MC200_CMP_XM5_XM6_W8P2524_XM7_XM11_W16P8587_S025_LOW_W4.csv | 24251 | cb9080c2f8c49b0e075cfbea4bf13e57f8644751d0f288e886b3f8b0b8f8b29a
02_SIMULATION_RESULTS/01_MC200_TT_LOW_W4/csv/job_codes/MC200_CMP_XM5_XM6_W8P2524_XM7_XM11_W16P8587_S026_LOW_W4.csv | 24258 | 57f069a2866b0779297de5039f968159f8590997c3c2003f965ae551969c7b1e
02_SIMULATION_RESULTS/01_MC200_TT_LOW_W4/csv/job_codes/MC200_CMP_XM5_XM6_W8P2524_XM7_XM11_W16P8587_S027_LOW_W4.csv | 24249 | 489ecb3f5bc5ce7a3699133bd9135b0c95f1a6787ad39bff68470fc4da55f6ab
02_SIMULATION_RESULTS/01_MC200_TT_LOW_W4/csv/job_codes/MC200_CMP_XM5_XM6_W8P2524_XM7_XM11_W16P8587_S028_LOW_W4.csv | 24244 | 58c32b0e2b51ef11cf888625c2018f99f87d7a837f2ba8aa35ddc9eb3d92142c
02_SIMULATION_RESULTS/01_MC200_TT_LOW_W4/csv/job_codes/MC200_CMP_XM5_XM6_W8P2524_XM7_XM11_W16P8587_S029_LOW_W4.csv | 24258 | e3929fee880ae1bdedb8175d18642ba9fadb19d3456a3ee7af3cad7ae6bcd7fe
02_SIMULATION_RESULTS/01_MC200_TT_LOW_W4/csv/job_codes/MC200_CMP_XM5_XM6_W8P2524_XM7_XM11_W16P8587_S030_LOW_W4.csv | 24257 | 9ef623ec8c02da155560e7fd1776b61ae1bff8987849f3aa4975e68721acd9cd
02_SIMULATION_RESULTS/01_MC200_TT_LOW_W4/csv/job_codes/MC200_CMP_XM5_XM6_W8P2524_XM7_XM11_W16P8587_S031_LOW_W4.csv | 24264 | 5fcd64aa752199e7392bd4ac87b44948f0f9d6eb698f5117a4eb4806bb40c779
02_SIMULATION_RESULTS/01_MC200_TT_LOW_W4/csv/job_codes/MC200_CMP_XM5_XM6_W8P2524_XM7_XM11_W16P8587_S032_LOW_W4.csv | 24249 | df858fe5b610209ef99252fbe9c76c038b1ab54fd3df9b7a904a94de33316b3f
02_SIMULATION_RESULTS/01_MC200_TT_LOW_W4/csv/job_codes/MC200_CMP_XM5_XM6_W8P2524_XM7_XM11_W16P8587_S033_LOW_W4.csv | 24245 | 281a89fc60d3acc10c6be69ba06a365aeeeda504474c8f8fecefca0803d49513
02_SIMULATION_RESULTS/01_MC200_TT_LOW_W4/csv/job_codes/MC200_CMP_XM5_XM6_W8P2524_XM7_XM11_W16P8587_S034_LOW_W4.csv | 24240 | 09c4bb32a7e1bc08267b695a4d77f4688817c3e57b05987e5a8765eff29142ca
02_SIMULATION_RESULTS/01_MC200_TT_LOW_W4/csv/job_codes/MC200_CMP_XM5_XM6_W8P2524_XM7_XM11_W16P8587_S035_LOW_W4.csv | 24258 | c2b0164a9bf4f5009b4ec2dce6ee58bc15b9f0f467be8a7cedd176e544a533b6
02_SIMULATION_RESULTS/01_MC200_TT_LOW_W4/csv/job_codes/MC200_CMP_XM5_XM6_W8P2524_XM7_XM11_W16P8587_S036_LOW_W4.csv | 24261 | 5e4f157aaaa9cd8e4682f5c5c665f6633857974d81e6ff6ad7e50fdd906bb3e4
02_SIMULATION_RESULTS/01_MC200_TT_LOW_W4/csv/job_codes/MC200_CMP_XM5_XM6_W8P2524_XM7_XM11_W16P8587_S037_LOW_W4.csv | 24252 | 319c382e38b7c539e7e2a442461df3f4bdb1f8ecc619d87677c2846259a5f3a2
02_SIMULATION_RESULTS/01_MC200_TT_LOW_W4/csv/job_codes/MC200_CMP_XM5_XM6_W8P2524_XM7_XM11_W16P8587_S038_LOW_W4.csv | 24248 | 3e1b80c7589c8c9135a794c620c79c22bad2b2679d8b965e5c3a4016095eb084
02_SIMULATION_RESULTS/01_MC200_TT_LOW_W4/csv/job_codes/MC200_CMP_XM5_XM6_W8P2524_XM7_XM11_W16P8587_S039_LOW_W4.csv | 24249 | be53cdf73a1d9fd320d730443fc7f7cbf7192f16a12fcfb1fcc496addec79f95
02_SIMULATION_RESULTS/01_MC200_TT_LOW_W4/csv/job_codes/MC200_CMP_XM5_XM6_W8P2524_XM7_XM11_W16P8587_S040_LOW_W4.csv | 24250 | 549ab7d6c504d7089c048e4f91bfeae761a7e6ed4a48bf7a8424e76ab3bf94ad
02_SIMULATION_RESULTS/01_MC200_TT_LOW_W4/csv/job_codes/MC200_CMP_XM5_XM6_W8P2524_XM7_XM11_W16P8587_S041_LOW_W4.csv | 24254 | 7c741378584ace4a79fedc84dd45dcff1ff24487d8effc37ce857c696ea5c1ed
02_SIMULATION_RESULTS/01_MC200_TT_LOW_W4/csv/job_codes/MC200_CMP_XM5_XM6_W8P2524_XM7_XM11_W16P8587_S042_LOW_W4.csv | 24249 | 06beea45b033c6545e49fa1c06742c5afa73e1ad65405a450a66744e1d500b74
02_SIMULATION_RESULTS/01_MC200_TT_LOW_W4/csv/job_codes/MC200_CMP_XM5_XM6_W8P2524_XM7_XM11_W16P8587_S043_LOW_W4.csv | 24257 | 46c6bd2736a07fef8997285aa9282acb65deabbed1f9583709d0249af7ab82d7
02_SIMULATION_RESULTS/01_MC200_TT_LOW_W4/csv/job_codes/MC200_CMP_XM5_XM6_W8P2524_XM7_XM11_W16P8587_S044_LOW_W4.csv | 24258 | c8541526442c056441adb744c133dfbffe0ca883db9af7d6c43ef67952159922
02_SIMULATION_RESULTS/01_MC200_TT_LOW_W4/csv/job_codes/MC200_CMP_XM5_XM6_W8P2524_XM7_XM11_W16P8587_S045_LOW_W4.csv | 24246 | 0f49e7313e9002b7225ff58d5630551ba0a3b1916f43b63f132263204fd2153f
02_SIMULATION_RESULTS/01_MC200_TT_LOW_W4/csv/job_codes/MC200_CMP_XM5_XM6_W8P2524_XM7_XM11_W16P8587_S046_LOW_W4.csv | 24247 | 71bb0119e9c4d699a3c0386f58f197632948fe98805822a675c2d803fa150aaf
02_SIMULATION_RESULTS/01_MC200_TT_LOW_W4/csv/job_codes/MC200_CMP_XM5_XM6_W8P2524_XM7_XM11_W16P8587_S047_LOW_W4.csv | 24246 | 60624d5613489e3c145214bd19da66698f778b2dc4237f6343d9c3271ebfb4a9
02_SIMULATION_RESULTS/01_MC200_TT_LOW_W4/csv/job_codes/MC200_CMP_XM5_XM6_W8P2524_XM7_XM11_W16P8587_S048_LOW_W4.csv | 24248 | b562d914b1a566f97277f2ddcc071a4c9ad99726ea71d162d9e9dfc4b2c4e77a
02_SIMULATION_RESULTS/01_MC200_TT_LOW_W4/csv/job_codes/MC200_CMP_XM5_XM6_W8P2524_XM7_XM11_W16P8587_S049_LOW_W4.csv | 24251 | 989c36fe10eb45b92ec6e72e534c77c60aeee8204afdb437328e9b7169f397b3
02_SIMULATION_RESULTS/01_MC200_TT_LOW_W4/csv/job_codes/MC200_CMP_XM5_XM6_W8P2524_XM7_XM11_W16P8587_S050_LOW_W4.csv | 24249 | fc2ba2ceaa6bea1472fa588221f38ca80cf24abbdee0d49138ac8bc8e7c1e561
02_SIMULATION_RESULTS/01_MC200_TT_LOW_W4/csv/job_codes/MC200_CMP_XM5_XM6_W8P2524_XM7_XM11_W16P8587_S051_LOW_W4.csv | 24249 | 113635a878cd3e0f26d446d270e225b3d66992bb6efb11a49ce3c54701cf1bf4
02_SIMULATION_RESULTS/01_MC200_TT_LOW_W4/csv/job_codes/MC200_CMP_XM5_XM6_W8P2524_XM7_XM11_W16P8587_S052_LOW_W4.csv | 24253 | eec83a510102c5b1cfaf957bbdde7daff7a347b39c929e0381943e99adff8295
02_SIMULATION_RESULTS/01_MC200_TT_LOW_W4/csv/job_codes/MC200_CMP_XM5_XM6_W8P2524_XM7_XM11_W16P8587_S053_LOW_W4.csv | 24258 | da379f4e6a4501eb0dd05ecea8dd9c89fbb80017332d394972b17fe6823b6691
02_SIMULATION_RESULTS/01_MC200_TT_LOW_W4/csv/job_codes/MC200_CMP_XM5_XM6_W8P2524_XM7_XM11_W16P8587_S054_LOW_W4.csv | 24260 | 923c8b2a41954e2b148662b740fc0528131cd2e89c747d4ff9a44abcc76df586
02_SIMULATION_RESULTS/01_MC200_TT_LOW_W4/csv/job_codes/MC200_CMP_XM5_XM6_W8P2524_XM7_XM11_W16P8587_S055_LOW_W4.csv | 24258 | 8fd978a47cb2b4fb4aed528abbd4764af0a93de56aa63e7de6de94dacf671991
02_SIMULATION_RESULTS/01_MC200_TT_LOW_W4/csv/job_codes/MC200_CMP_XM5_XM6_W8P2524_XM7_XM11_W16P8587_S056_LOW_W4.csv | 24261 | 66fd22911742bbc672fa7d92c4119bade96c441528508ed8da487de3833fef54
02_SIMULATION_RESULTS/01_MC200_TT_LOW_W4/csv/job_codes/MC200_CMP_XM5_XM6_W8P2524_XM7_XM11_W16P8587_S057_LOW_W4.csv | 24249 | bb1b924709132b76c90b37cc0acb3532da98361c07d478d98e58fb2df29ac685
02_SIMULATION_RESULTS/01_MC200_TT_LOW_W4/csv/job_codes/MC200_CMP_XM5_XM6_W8P2524_XM7_XM11_W16P8587_S058_LOW_W4.csv | 24243 | dbbe8509e959b9ab39846ed5abe1ae0eae717c0c78720408952a4e0096e8ecbe
02_SIMULATION_RESULTS/01_MC200_TT_LOW_W4/csv/job_codes/MC200_CMP_XM5_XM6_W8P2524_XM7_XM11_W16P8587_S059_LOW_W4.csv | 24258 | fe19f6d00e23591896ee38ff92a17c5ce1471665e31d09e1f7037ca670eeea83
02_SIMULATION_RESULTS/01_MC200_TT_LOW_W4/csv/job_codes/MC200_CMP_XM5_XM6_W8P2524_XM7_XM11_W16P8587_S060_LOW_W4.csv | 24249 | 56a04cee9cd85583438532854ab41243bf3d8761e2573e5f02c87d6d1aaee88b
02_SIMULATION_RESULTS/01_MC200_TT_LOW_W4/csv/job_codes/MC200_CMP_XM5_XM6_W8P2524_XM7_XM11_W16P8587_S061_LOW_W4.csv | 24248 | c27c7abab36e9702f96fb89c17064f0e114b0a7c0ed50fe8e8764d895f4793be
02_SIMULATION_RESULTS/01_MC200_TT_LOW_W4/csv/job_codes/MC200_CMP_XM5_XM6_W8P2524_XM7_XM11_W16P8587_S062_LOW_W4.csv | 24249 | 52741eb2335bbd37faa35afaa9ab5e52e7e54748062504358fe91140bc350885
02_SIMULATION_RESULTS/01_MC200_TT_LOW_W4/csv/job_codes/MC200_CMP_XM5_XM6_W8P2524_XM7_XM11_W16P8587_S063_LOW_W4.csv | 24260 | a183436ee4fbdf3cc8976ed86510691906ac8bad1311e014c2b2ae9887a92dce
02_SIMULATION_RESULTS/01_MC200_TT_LOW_W4/csv/job_codes/MC200_CMP_XM5_XM6_W8P2524_XM7_XM11_W16P8587_S064_LOW_W4.csv | 24255 | 33cf92c46f64c5221f52d7441f48247c20d337a35f1050999b80054e6a071f69
02_SIMULATION_RESULTS/01_MC200_TT_LOW_W4/csv/job_codes/MC200_CMP_XM5_XM6_W8P2524_XM7_XM11_W16P8587_S065_LOW_W4.csv | 24246 | 7ef627cab0eafbdbe0b6724748344659fe7dab946f248af4b119380ffa544f85
02_SIMULATION_RESULTS/01_MC200_TT_LOW_W4/csv/job_codes/MC200_CMP_XM5_XM6_W8P2524_XM7_XM11_W16P8587_S066_LOW_W4.csv | 24249 | 5b38d04069feb700433c46bc914cea256e27096cbfa15e2e1f218afa40c368ef
02_SIMULATION_RESULTS/01_MC200_TT_LOW_W4/csv/job_codes/MC200_CMP_XM5_XM6_W8P2524_XM7_XM11_W16P8587_S067_LOW_W4.csv | 24259 | 0e6a9c427e1686b98d9e57a971e99629fd8167b37004b6c40cae7143337764c6
02_SIMULATION_RESULTS/01_MC200_TT_LOW_W4/csv/job_codes/MC200_CMP_XM5_XM6_W8P2524_XM7_XM11_W16P8587_S068_LOW_W4.csv | 24246 | 12147e58cccffdefa63508ae90fe532b2f12e64a97a50cfb0515389c86c475cd
02_SIMULATION_RESULTS/01_MC200_TT_LOW_W4/csv/job_codes/MC200_CMP_XM5_XM6_W8P2524_XM7_XM11_W16P8587_S069_LOW_W4.csv | 24243 | e362e6a6ad0a606f995524bd8918ec3d1cbec667c443e04ff2f3c8a648ab70b7
02_SIMULATION_RESULTS/01_MC200_TT_LOW_W4/csv/job_codes/MC200_CMP_XM5_XM6_W8P2524_XM7_XM11_W16P8587_S070_LOW_W4.csv | 24258 | 97cff17596b55c35c4d2ac5962461a9df58e74fa0a9853fccfad2b20ead80e48
02_SIMULATION_RESULTS/01_MC200_TT_LOW_W4/csv/job_codes/MC200_CMP_XM5_XM6_W8P2524_XM7_XM11_W16P8587_S071_LOW_W4.csv | 24256 | 26d11e046370816fb6e49564d824114ec44ae568f48820368c066c4591ebe05d
02_SIMULATION_RESULTS/01_MC200_TT_LOW_W4/csv/job_codes/MC200_CMP_XM5_XM6_W8P2524_XM7_XM11_W16P8587_S072_LOW_W4.csv | 24261 | c663fbbff0e6287bcc67cc8cac83ddfd5b8a210339531b50caceb87af3b8bea6
02_SIMULATION_RESULTS/01_MC200_TT_LOW_W4/csv/job_codes/MC200_CMP_XM5_XM6_W8P2524_XM7_XM11_W16P8587_S073_LOW_W4.csv | 24251 | 212caff3474a4e16d98f88cc0e2b61df26c0a06c3655beb3c1561a16306449c1
02_SIMULATION_RESULTS/01_MC200_TT_LOW_W4/csv/job_codes/MC200_CMP_XM5_XM6_W8P2524_XM7_XM11_W16P8587_S074_LOW_W4.csv | 24255 | 269cb4541cdd1ff57a18fd9f7ab1d04df02903e35f4ad70a36bf0726ef08ee87
02_SIMULATION_RESULTS/01_MC200_TT_LOW_W4/csv/job_codes/MC200_CMP_XM5_XM6_W8P2524_XM7_XM11_W16P8587_S075_LOW_W4.csv | 24257 | 248c39a87dae1610753c3cd86057c56e1226f8c39e7adb17b747263369053b03
02_SIMULATION_RESULTS/01_MC200_TT_LOW_W4/csv/job_codes/MC200_CMP_XM5_XM6_W8P2524_XM7_XM11_W16P8587_S076_LOW_W4.csv | 24250 | 03a5b941039339aef9d1908ae3965d4a69b3f60f80ccddca5ed5bb3b1dbb9ef5
02_SIMULATION_RESULTS/01_MC200_TT_LOW_W4/csv/job_codes/MC200_CMP_XM5_XM6_W8P2524_XM7_XM11_W16P8587_S077_LOW_W4.csv | 24253 | e619d16515cb3a809098e5d48f7dfea956bdea716c540fba19a03125c79372ce
02_SIMULATION_RESULTS/01_MC200_TT_LOW_W4/csv/job_codes/MC200_CMP_XM5_XM6_W8P2524_XM7_XM11_W16P8587_S078_LOW_W4.csv | 24254 | 96634235fa7366df83e95618a36cda852581f02563f8ce9e787175161b694192
02_SIMULATION_RESULTS/01_MC200_TT_LOW_W4/csv/job_codes/MC200_CMP_XM5_XM6_W8P2524_XM7_XM11_W16P8587_S079_LOW_W4.csv | 24251 | c4656d53c808ed6e5c5790d87a463f20a141c46be58b2193eb884879f36c4c2d
02_SIMULATION_RESULTS/01_MC200_TT_LOW_W4/csv/job_codes/MC200_CMP_XM5_XM6_W8P2524_XM7_XM11_W16P8587_S080_LOW_W4.csv | 24252 | 5bcbe2fd4b4c6d90b9130e0beed1de022fd9162abb6e9270ef8ed6657b5d38a6
02_SIMULATION_RESULTS/01_MC200_TT_LOW_W4/csv/job_codes/MC200_CMP_XM5_XM6_W8P2524_XM7_XM11_W16P8587_S081_LOW_W4.csv | 24249 | 8b9bad035c4bab4eed35b9831fd80d45d4ebfb52196bcb21badc4dfb1d835879
02_SIMULATION_RESULTS/01_MC200_TT_LOW_W4/csv/job_codes/MC200_CMP_XM5_XM6_W8P2524_XM7_XM11_W16P8587_S082_LOW_W4.csv | 24252 | dffdc2a1716dd8df44ff08aa03e7279d3c234593bb699f1c30ccc794a87efc7c
02_SIMULATION_RESULTS/01_MC200_TT_LOW_W4/csv/job_codes/MC200_CMP_XM5_XM6_W8P2524_XM7_XM11_W16P8587_S083_LOW_W4.csv | 24250 | 4df10e86020d932d377a603c11b2560977457654c4caeb85f11bc42b771c3a4d
02_SIMULATION_RESULTS/01_MC200_TT_LOW_W4/csv/job_codes/MC200_CMP_XM5_XM6_W8P2524_XM7_XM11_W16P8587_S084_LOW_W4.csv | 24250 | e54566d84b480f71588f3a5d69c6c16931208d92692c261e84d581d37671a14c
02_SIMULATION_RESULTS/01_MC200_TT_LOW_W4/csv/job_codes/MC200_CMP_XM5_XM6_W8P2524_XM7_XM11_W16P8587_S085_LOW_W4.csv | 24247 | 3b473b24ecbf7bf155c4a9bf559bb536503dbb4a39b2ea7c61368e0ae8a56f42
02_SIMULATION_RESULTS/01_MC200_TT_LOW_W4/csv/job_codes/MC200_CMP_XM5_XM6_W8P2524_XM7_XM11_W16P8587_S086_LOW_W4.csv | 24249 | 9bd228ba7723850b5cd54cb4a999000b7e179f19df22385e28f22e316c40d3a6
02_SIMULATION_RESULTS/01_MC200_TT_LOW_W4/csv/job_codes/MC200_CMP_XM5_XM6_W8P2524_XM7_XM11_W16P8587_S087_LOW_W4.csv | 24254 | 793675317ca82ae5996f38e7e464bfd200bcd19f484a905450c94ca190c7a634
02_SIMULATION_RESULTS/01_MC200_TT_LOW_W4/csv/job_codes/MC200_CMP_XM5_XM6_W8P2524_XM7_XM11_W16P8587_S088_LOW_W4.csv | 24258 | f4aaf86483c19cb4992b96030dfb09bf1b62274c471e7d54c8aca207b258f54f
02_SIMULATION_RESULTS/01_MC200_TT_LOW_W4/csv/job_codes/MC200_CMP_XM5_XM6_W8P2524_XM7_XM11_W16P8587_S089_LOW_W4.csv | 24246 | cc3df2dacdb76957246fcc5ac9966e860abcf6d0e2b14e011572a87a051466ed
02_SIMULATION_RESULTS/01_MC200_TT_LOW_W4/csv/job_codes/MC200_CMP_XM5_XM6_W8P2524_XM7_XM11_W16P8587_S090_LOW_W4.csv | 24239 | ed355e8a67adfe0cf6f4d36d890370545b820585a7cbd3672e259821518e5109
02_SIMULATION_RESULTS/01_MC200_TT_LOW_W4/csv/job_codes/MC200_CMP_XM5_XM6_W8P2524_XM7_XM11_W16P8587_S091_LOW_W4.csv | 24245 | 9aa303aa29466e78ba1b0bc52f7a23ff1717b09f181617323c186fcf455b449c
02_SIMULATION_RESULTS/01_MC200_TT_LOW_W4/csv/job_codes/MC200_CMP_XM5_XM6_W8P2524_XM7_XM11_W16P8587_S092_LOW_W4.csv | 24256 | 3fa5c0a43dc911d0e2688a3d31e77e5f6ab58d093c1cae0a9c33d171665d5542
02_SIMULATION_RESULTS/01_MC200_TT_LOW_W4/csv/job_codes/MC200_CMP_XM5_XM6_W8P2524_XM7_XM11_W16P8587_S093_LOW_W4.csv | 24238 | af6182faca6a5b4d90f329c8a3dac179a37f80a33f537f8aeefc6c10aaf16271
02_SIMULATION_RESULTS/01_MC200_TT_LOW_W4/csv/job_codes/MC200_CMP_XM5_XM6_W8P2524_XM7_XM11_W16P8587_S094_LOW_W4.csv | 24253 | 52b2608d9bbf73dc31f510d6c2d24b2a20213c2c951fc14d80ff6f6b0fdb02be
02_SIMULATION_RESULTS/01_MC200_TT_LOW_W4/csv/job_codes/MC200_CMP_XM5_XM6_W8P2524_XM7_XM11_W16P8587_S095_LOW_W4.csv | 24249 | 7b988cb6f2cf6be3731acc0dab6505cdf85f62ebc09cb60db21c685c3a3bf517
02_SIMULATION_RESULTS/01_MC200_TT_LOW_W4/csv/job_codes/MC200_CMP_XM5_XM6_W8P2524_XM7_XM11_W16P8587_S096_LOW_W4.csv | 24255 | b2965a511c76abaef85d4334fa48f69bc59b67373f699d06ca9957e7a176865a
02_SIMULATION_RESULTS/01_MC200_TT_LOW_W4/csv/job_codes/MC200_CMP_XM5_XM6_W8P2524_XM7_XM11_W16P8587_S097_LOW_W4.csv | 24242 | 01ba531c79e5934bf017be0804f4c0c9aa0a1762800e4af5a902b393576f97e3
02_SIMULATION_RESULTS/01_MC200_TT_LOW_W4/csv/job_codes/MC200_CMP_XM5_XM6_W8P2524_XM7_XM11_W16P8587_S098_LOW_W4.csv | 24248 | 7ba6639e40aa481ab90cb80902cb8bcf0eceaa96db1e62bc44b5cca47bf19f18
02_SIMULATION_RESULTS/01_MC200_TT_LOW_W4/csv/job_codes/MC200_CMP_XM5_XM6_W8P2524_XM7_XM11_W16P8587_S099_LOW_W4.csv | 24259 | f45400c867772ce51a48e75a59e8bfde73a3f1697ad16bc5d37a25ad6fa19583
02_SIMULATION_RESULTS/01_MC200_TT_LOW_W4/csv/job_codes/MC200_CMP_XM5_XM6_W8P2524_XM7_XM11_W16P8587_S100_LOW_W4.csv | 24319 | 4b852b774a34dea3befddd6bc093a6e2e5d901585cd81e287e6ed3152e5d0e9e
02_SIMULATION_RESULTS/01_MC200_TT_LOW_W4/csv/job_codes/MC200_CMP_XM5_XM6_W8P2524_XM7_XM11_W16P8587_S101_LOW_W4.csv | 24311 | 0f9473a1edeecc25ed28cd54153d0bfebb6dd9d24c2540b3d4f90aca3ab36591
02_SIMULATION_RESULTS/01_MC200_TT_LOW_W4/csv/job_codes/MC200_CMP_XM5_XM6_W8P2524_XM7_XM11_W16P8587_S102_LOW_W4.csv | 24325 | 4f6a42c84d657115da61edc423a6cc9d5393613e58cd2a1f206876b1132f7120
02_SIMULATION_RESULTS/01_MC200_TT_LOW_W4/csv/job_codes/MC200_CMP_XM5_XM6_W8P2524_XM7_XM11_W16P8587_S103_LOW_W4.csv | 24316 | ec50cc4dafef18a528bd1f0f00a0559a8ae6b9632339c7ee586033bc99c0b036
02_SIMULATION_RESULTS/01_MC200_TT_LOW_W4/csv/job_codes/MC200_CMP_XM5_XM6_W8P2524_XM7_XM11_W16P8587_S104_LOW_W4.csv | 24313 | 5e82b526d95c32da03c509cbc511b02317215073b028c28733c578aa1c101879
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
