tritone4801/chipathon-2026-A44-SAR-ADC/verification/a44_r2/02_SIMULATION_RESULTS/03_FULL255_STATIC/cases/S044_TT/plots/seed44_tt_full_static_transfer_curve.png

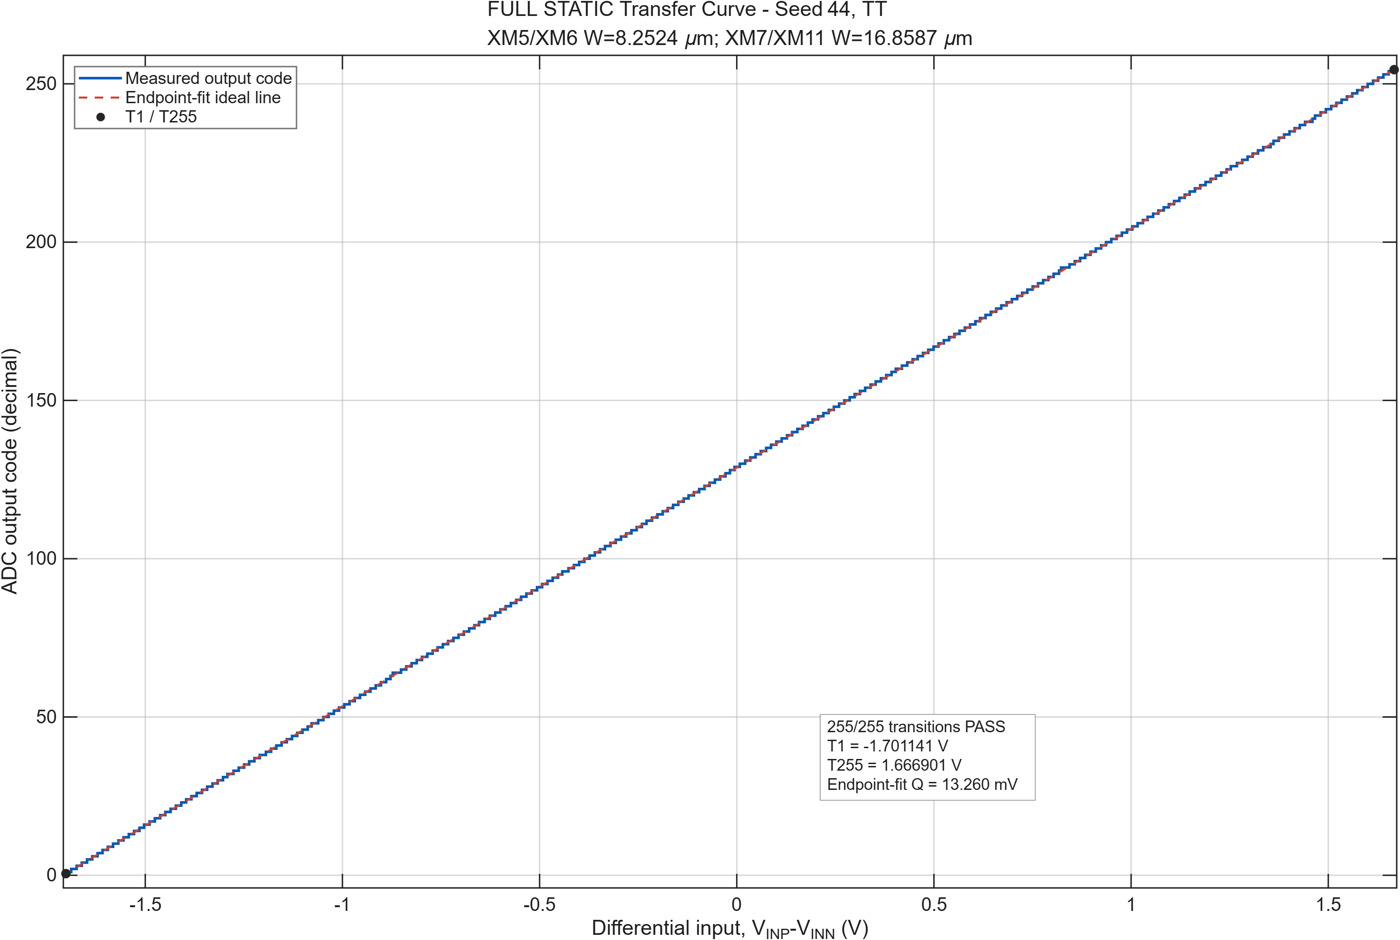
verification/a44_r2/02_SIMULATION_RESULTS/03_FULL255_STATIC/cases/S044_TT/plots/seed44_tt_full_static_transfer_curve.png
