tritone4801/chipathon-2026-A44-SAR-ADC/verification/a44_r2/02_SIMULATION_RESULTS/04_CROSS_CAMPAIGN_SUMMARY/plots/full255_static_dnl_inl_summary.png

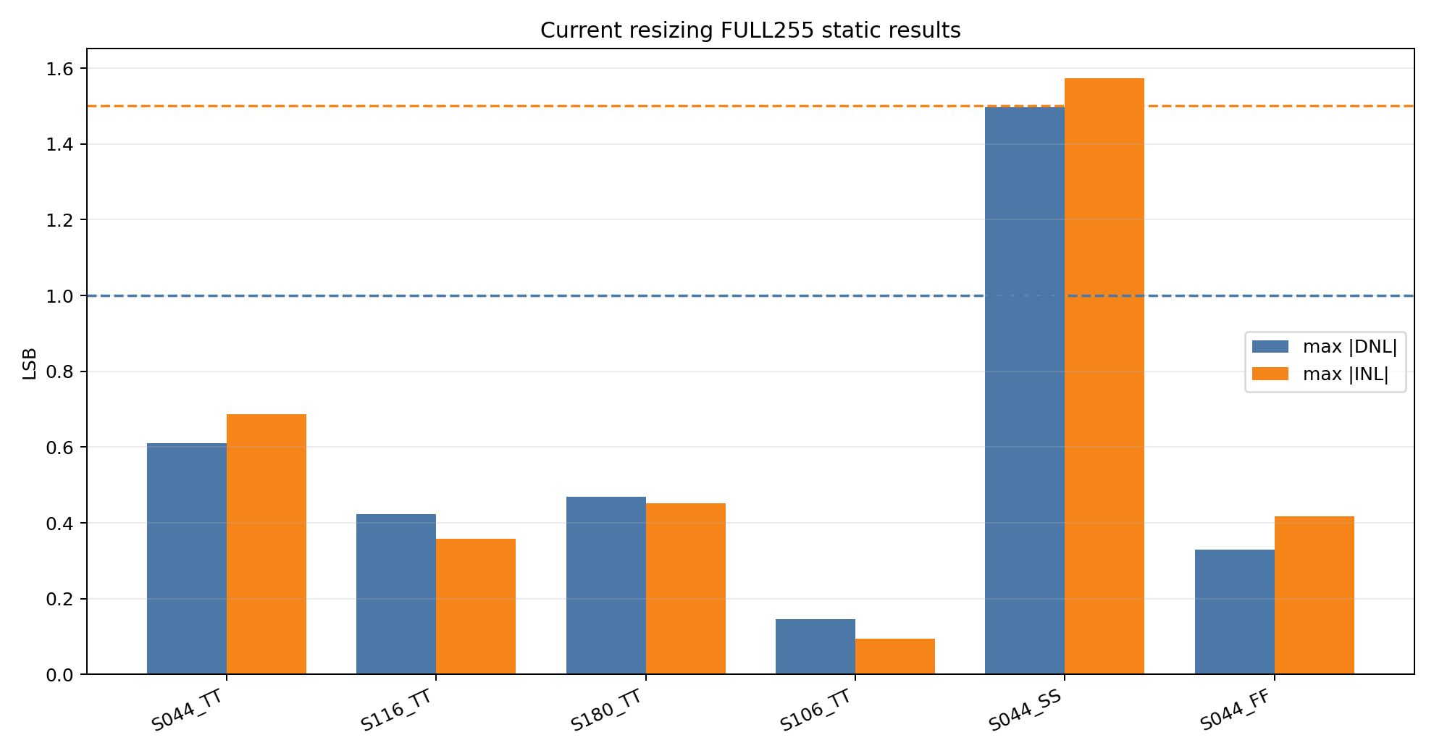
verification/a44_r2/02_SIMULATION_RESULTS/04_CROSS_CAMPAIGN_SUMMARY/plots/full255_static_dnl_inl_summary.png
