tritone4801/chipathon-2026-A44-SAR-ADC/verification/ideal_sar/results/plots/adc_output_code_time_low_frequency.png

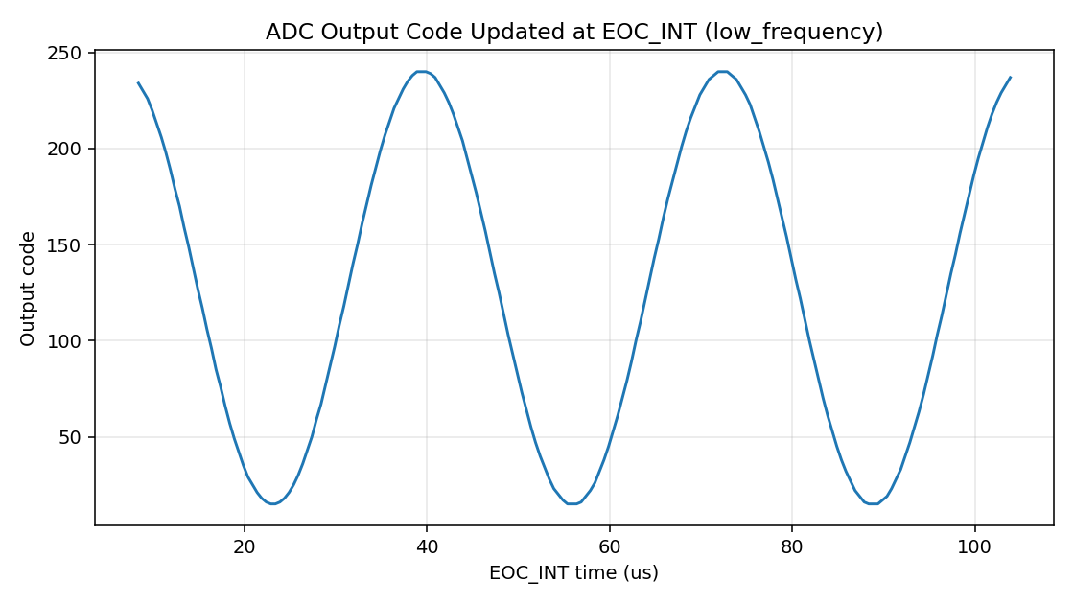
verification/ideal_sar/results/plots/adc_output_code_time_low_frequency.png
