tritone4801/chipathon-2026-A44-SAR-ADC/verification/ideal_sar/results/plots/adc_quantization_error_time.png

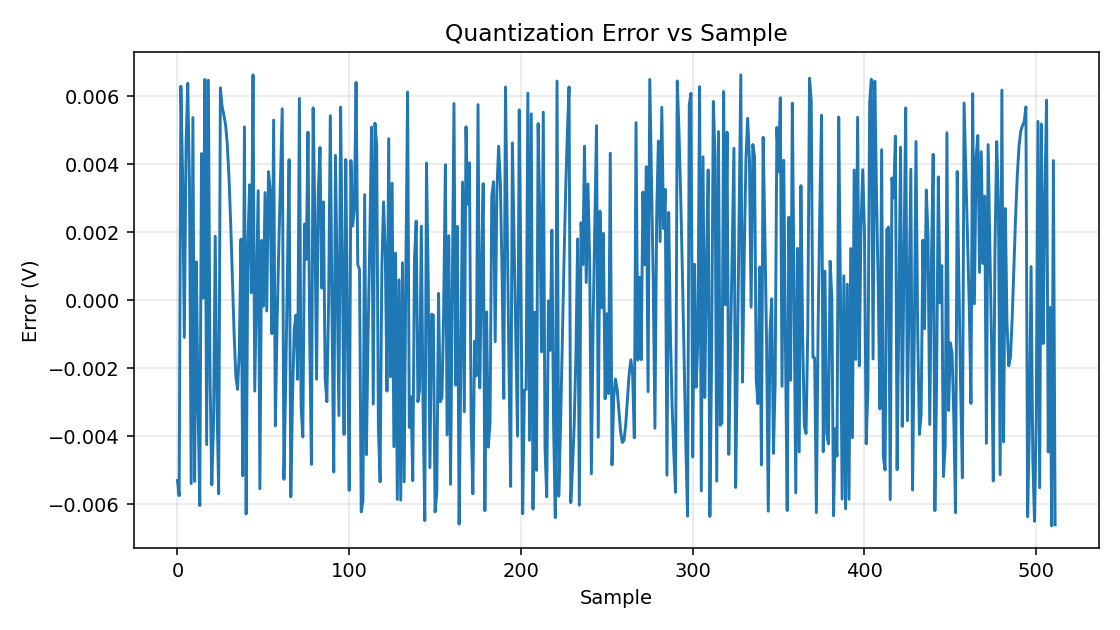
verification/ideal_sar/results/plots/adc_quantization_error_time.png
