tritone4801/chipathon-2026-A44-SAR-ADC/verification/ideal_sar/results/plots/adc_sqnr_vs_frequency.png

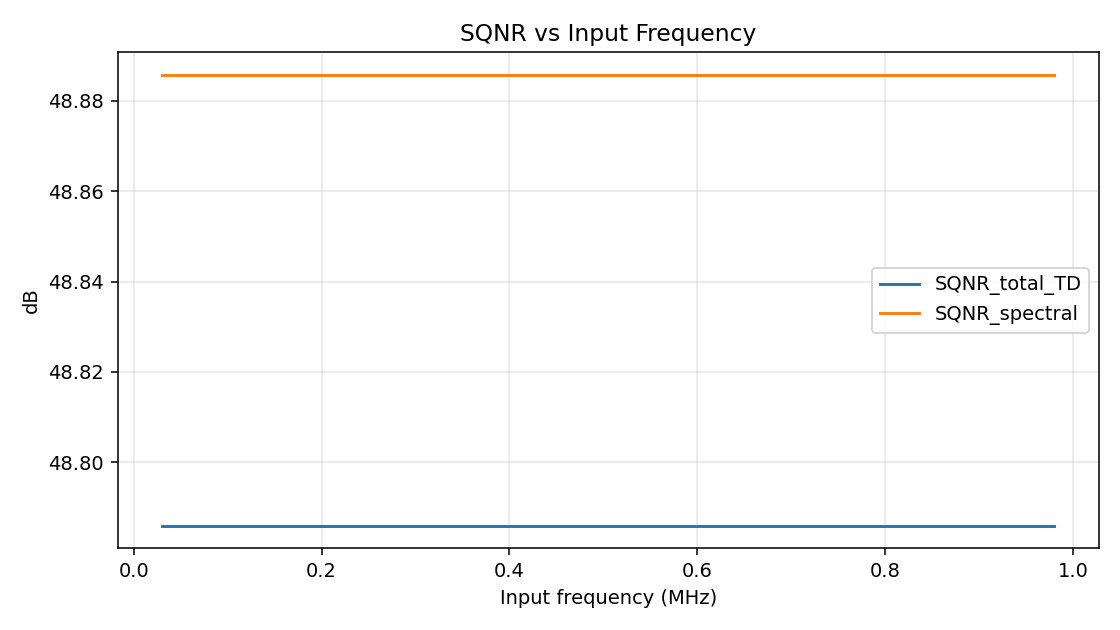
verification/ideal_sar/results/plots/adc_sqnr_vs_frequency.png
