tritone4801/chipathon-2026-A44-SAR-ADC/verification/ideal_sar/results/plots/dac_transfer.png

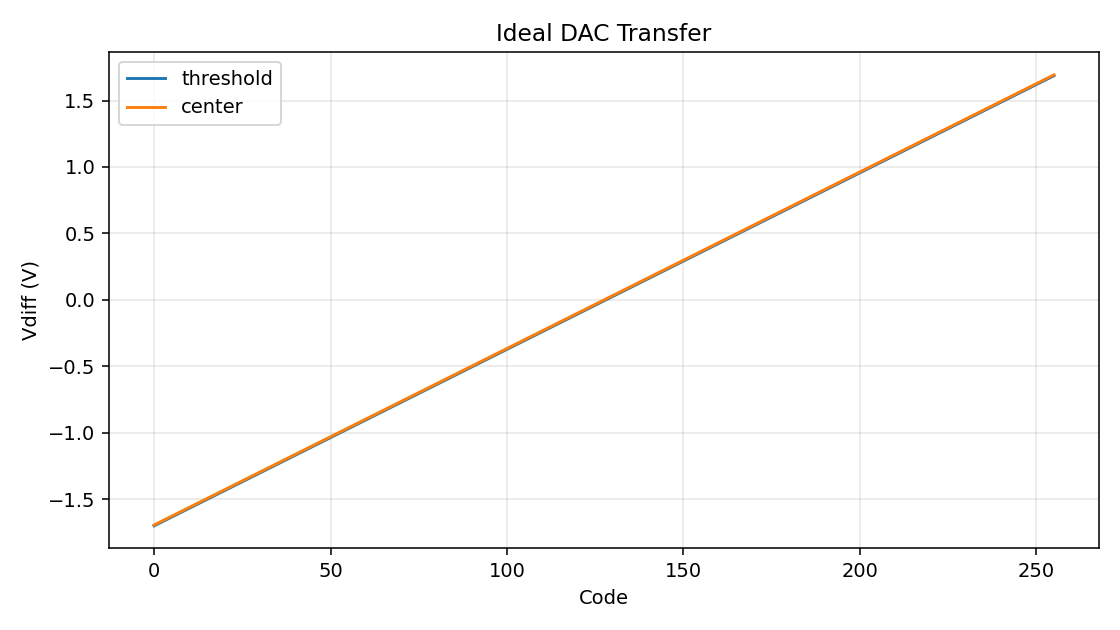
verification/ideal_sar/results/plots/dac_transfer.png
