tritone4801/chipathon-2026-A44-SAR-ADC/verification/ideal_sar/results/plots/fault_injection_status.png

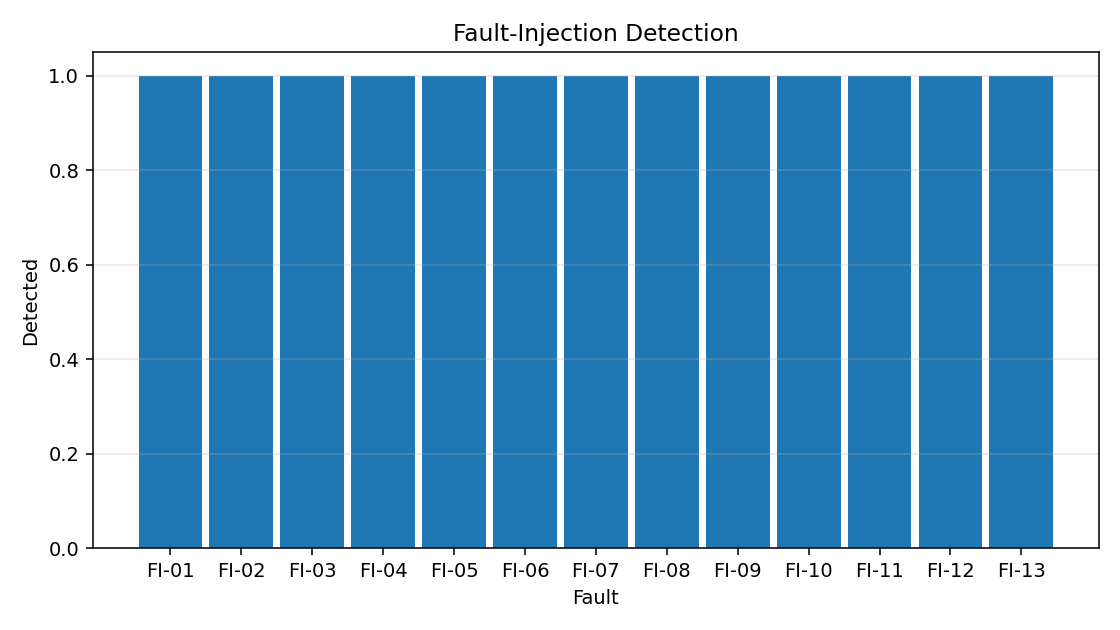
verification/ideal_sar/results/plots/fault_injection_status.png
