tritone4801/chipathon-2026-A44-SAR-ADC/verification/ideal_sar/results/plots/inl_endpoint_bestfit.png

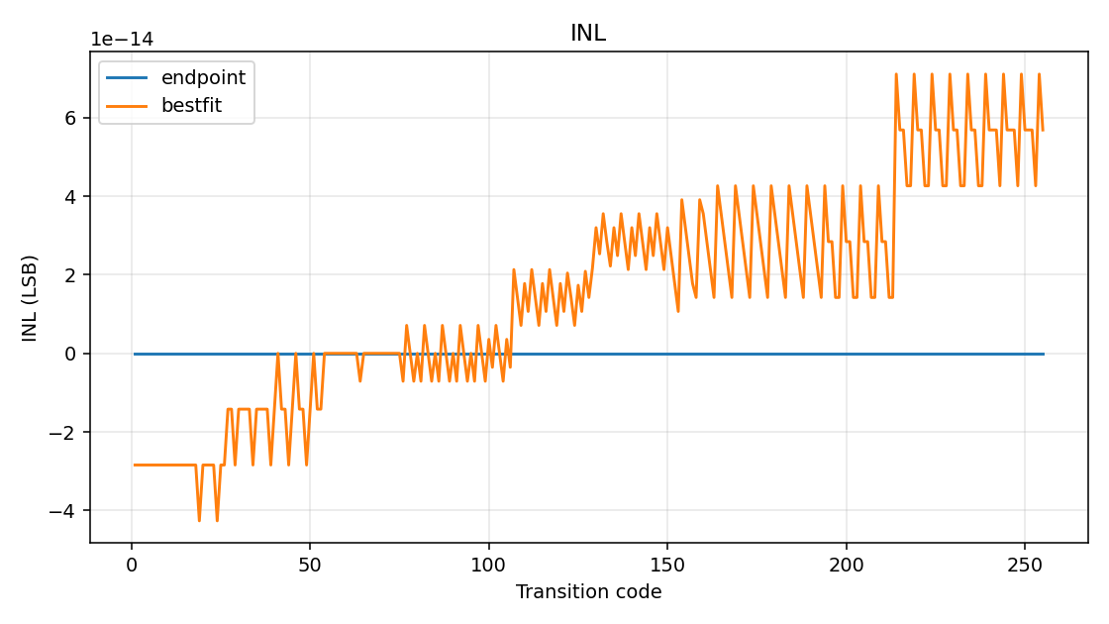
verification/ideal_sar/results/plots/inl_endpoint_bestfit.png
