tritone4801/chipathon-2026-A44-SAR-ADC/verification/ideal_sar/results/plots/quantization_error_histogram.png

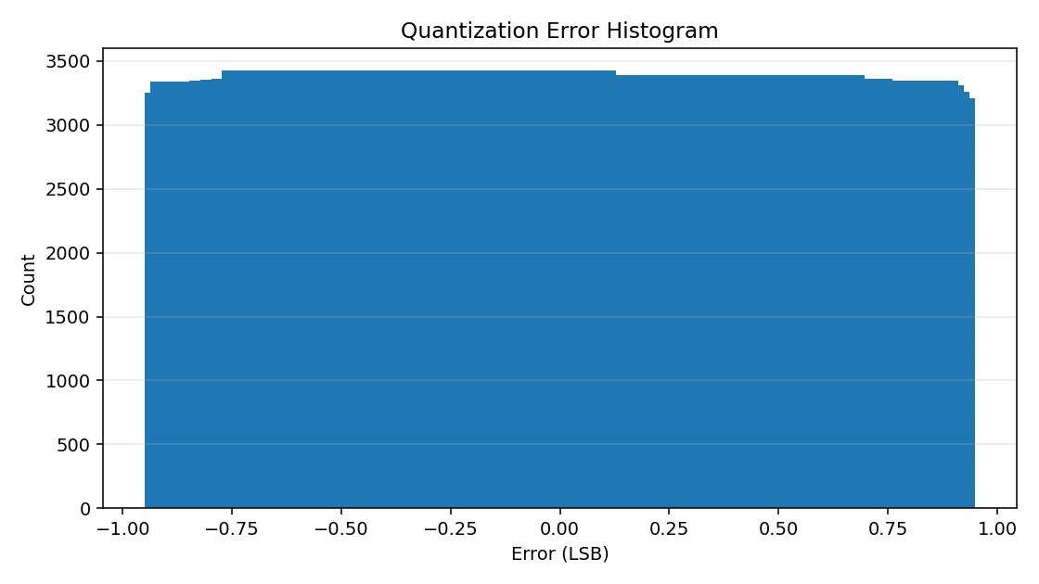
verification/ideal_sar/results/plots/quantization_error_histogram.png
