tritone4801/chipathon-2026-A44-SAR-ADC/verification/ideal_sar/results/plots/ramp_histogram.png

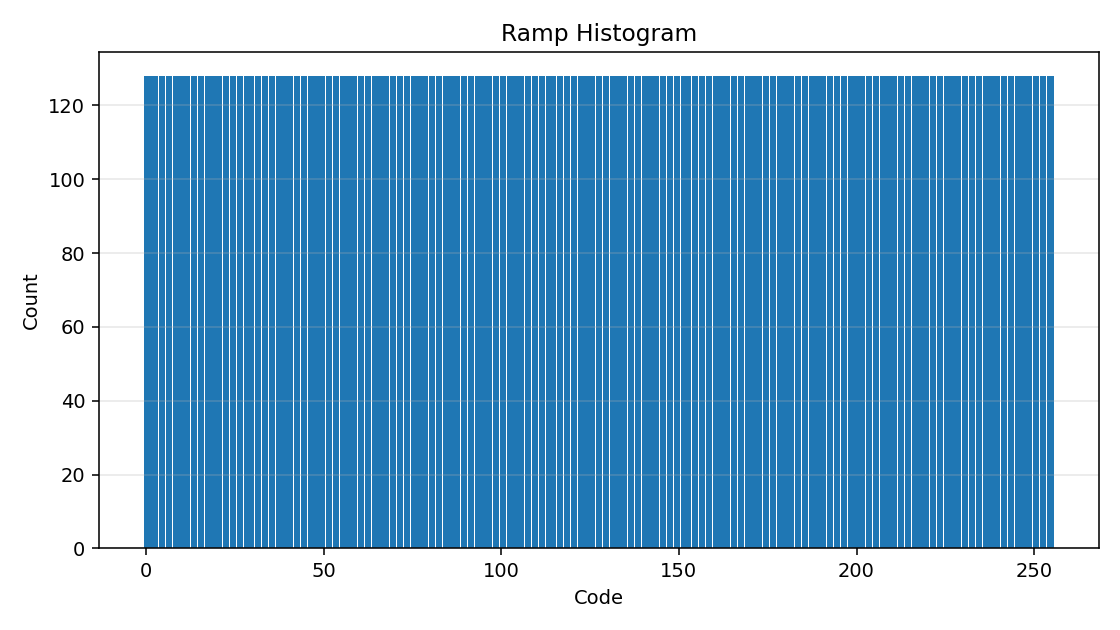
verification/ideal_sar/results/plots/ramp_histogram.png
