tritone4801/chipathon-2026-A44-SAR-ADC/verification/ideal_sar/results/plots/sine_histogram.png

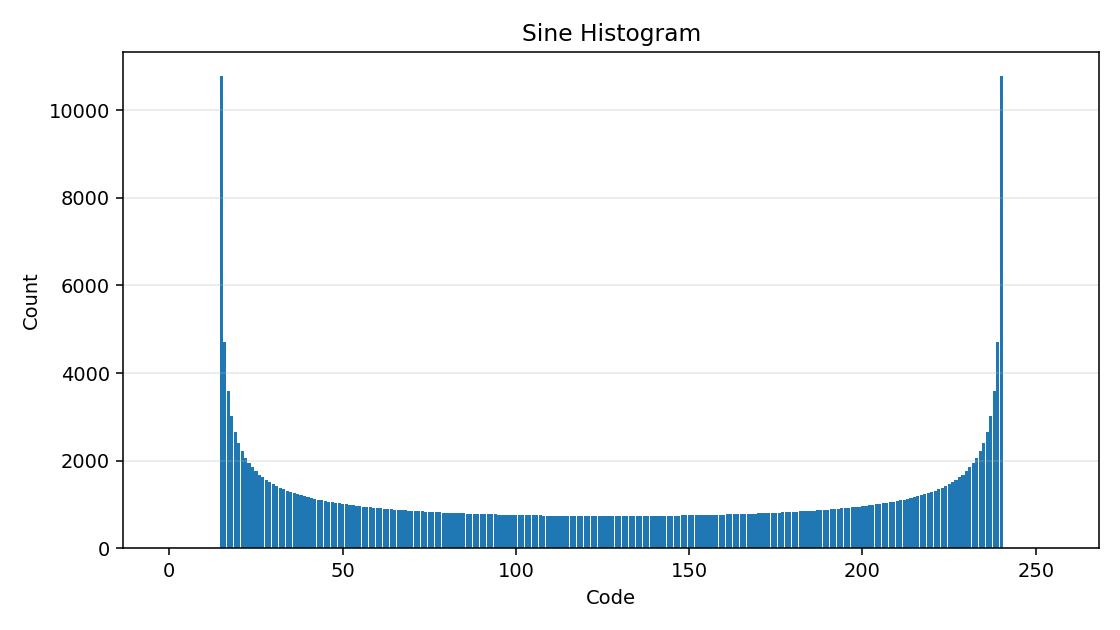
verification/ideal_sar/results/plots/sine_histogram.png
