tritone4801/chipathon-2026-A44-SAR-ADC/verification/ideal_sar/results/plots/transfer_curve.png

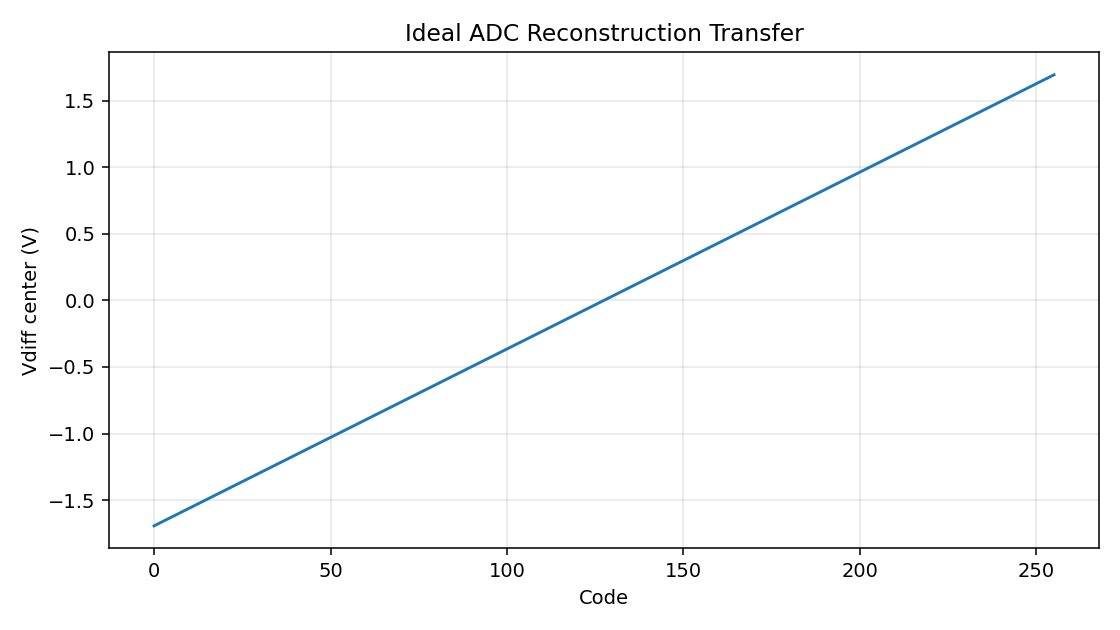
verification/ideal_sar/results/plots/transfer_curve.png
