tritone4801/chipathon-2026-A44-SAR-ADC/verification/a44_layout_history/pre_q2_20260903/README.md

# Preserved layout selection before Q2

These files are the layout selection at commit `52275beb778f55634d91da56488f93de2e98b827`.
Paths inside the copied metadata describe that earlier checkout. They do not select the current Q2 layout.
The original source checkout and its uncommitted presentation update remain unchanged outside this worktree.
