tritone4801/chipathon-2026-A44-SAR-ADC/verification/a44_r2/02_SIMULATION_RESULTS/01_MC200_TT_LOW_W4/source_snapshot/prior_model_audits/mc_failure_report.md

# Monte Carlo mismatch simulation Failure / Stop-Condition Report

- Generated UTC: `2026-07-01T23:57:59+00:00`
- Source files modified: `none`

- `MIM_LOCAL_MISMATCH_UNAVAILABLE`: `CLASSIFIED_LIMITATION`; related report `reports/mim_mismatch_capability.md`; claim not made: GF180 process-typical CDAC MIM mismatch signoff
- `COMPARATOR_OFFSET_EXTRACTION_FAIL`: `UNAVAILABLE_MODEL_LIMITATION_NO_OFFSET_DISTRIBUTION`; related report `reports/comparator_offset_mc_report.md`; claim not made: comparator Vos Monte Carlo mismatch simulation distribution
- `COMPARATOR_TRANSIENT_NOISE_UNAVAILABLE`: `NATIVE_TRANSIENT_NOISE_NOT_CLOSED`; related report `reports/comparator_noise_probability_report.md`; claim not made: StrongARM native transient-noise input-referred signoff
- `TOP_SELECTED_REPLAY_BLOCKED`: `CDAC_T2_SURROGATE_DONE_TOP_NOT_RUN`; related report `reports/top_selected_worst_seed_replay.md`; claim not made: selected TOP statistical worst-seed replay
- `PVT_TIMING_FAIL`: `FAIL_REVIEW`; related report `reports/pvt_mc_screening.md`; claim not made: process-voltage-temperature and Monte Carlo mismatch interaction simulation robustness / process-voltage-temperature signoff

These are validation stop/limitation classifications, not production design edits.
