tritone4801/chipathon-2026-A44-SAR-ADC/verification/a44_layout_history/pre_q2_20260903/layout/MODULE_NAMING_MAP.csv

role | canonical_public_stem | bbox_w_um | bbox_h_um | area_um2 | def_or_frozen_hierarchy_contract_name | published_gds | internal_cell_renamed | conflict_resolution
PROJECT_TOP | A44_A | 1110 | 1110 | 1232100 | A44_A | ../gds/A44_A.gds | false | DEF DESIGN name wins and remains exact
CORE | A44_SAR_ADC_CORE_1000 | 1000 | 1000 | 1000000 | A44_SAR_ADC_CORE_1000_R3_DUMMY_FILL_REPAIR | ../gds/A44_SAR_ADC_CORE_1000.gds | false | DEF direct macro contract wins; public basename drops revision and repair suffixes
CDAC_E | A44_SAR_ADC_CDAC_E_390X399P7 | 390 | 399.7 | 155883 | A44_CDAC_UNIT_E_R7 -> A44_CDAC_UNIT_E_R8_M6 | ../gds/components/A44_SAR_ADC_CDAC_E_390X399P7.gds | false | Frozen compatibility wrapper and current implementation hierarchy are retained
CDAC_W | A44_SAR_ADC_CDAC_W_390X399P7 | 390 | 399.7 | 155883 | A44_CDAC_UNIT_W_R7 -> A44_CDAC_UNIT_W_R8_M6 | ../gds/components/A44_SAR_ADC_CDAC_W_390X399P7.gds | false | Frozen compatibility wrapper and current implementation hierarchy are retained
COMPARATOR | A44_SAR_ADC_COMPARATOR_168X100 | 168 | 100 | 16800 | A44_COMP_PEX_ECO1_SD_REQUIRED_G6_FULL_R9 | ../gds/components/A44_SAR_ADC_COMPARATOR_168X100.gds | false | Public basename keeps function and bbox only
SAR_LOGIC | A44_SAR_ADC_SAR_LOGIC_240X240 | 240 | 240 | 57600 | SAR_LOGIC_ACTUAL_RTL_SS | ../gds/components/A44_SAR_ADC_SAR_LOGIC_240X240.gds | false | Public basename adds A44 prefix and bbox while frozen cell contract remains exact
CLKS_BUFFER | A44_SAR_ADC_CLKS_BUFFER_120X60 | 120 | 60 | 7200 | A44_CLKS_BUFFER_R1 | ../gds/components/A44_SAR_ADC_CLKS_BUFFER_120X60.gds | false | Public basename keeps function and bbox only
