tritone4801/chipathon-2026-A44-SAR-ADC/verification/a44_r2/02_SIMULATION_RESULTS/06_RUN_OUTPUTS/DEBUG_DYNAMIC_PDK_FIX/dynamic_first5_comparison.csv

campaign | phase | job_id | pvt | mismatch_seed | noise_seed | frame_index | expected_commanded_vid_v | actual_commanded_vid_v | commanded_input_match | expected_code | actual_code | code_match | expected_valid | actual_valid | valid_match | returncode | simulation_aborted | row_pass | early_stop | deck | log
01_MC200_TT_LOW_W4 | P4_EVENT_NOISE_MC200_LOW | MC200_CMP_XM5_XM6_W8P2524_XM7_XM11_W16P8587_S001_LOW_W4 | TT_3P3_27C | 1 | 100001 | 0 | 1.2827642395654932 | 1.2827642395654932 | True | 224 | 224 | True | True | True | True | 0 | False | True | PREFIX_LIMITED_AFTER_5_FRAMES | /foss/designs/A44_SAR_ADC_CURRENT_CACE_REPRODUCIBLE_20260728_R1/06_RUN_OUTPUTS/DEBUG_DYNAMIC_PDK_FIX/P4_EVENT_NOISE_MC200_LOW/MC200_CMP_XM5_XM6_W8P2524_XM7_XM11_W16P8587_S001_LOW_W4/jobs/prefix5.spice | /foss/designs/A44_SAR_ADC_CURRENT_CACE_REPRODUCIBLE_20260728_R1/06_RUN_OUTPUTS/DEBUG_DYNAMIC_PDK_FIX/P4_EVENT_NOISE_MC200_LOW/MC200_CMP_XM5_XM6_W8P2524_XM7_XM11_W16P8587_S001_LOW_W4/logs/prefix5.log
01_MC200_TT_LOW_W4 | P4_EVENT_NOISE_MC200_LOW | MC200_CMP_XM5_XM6_W8P2524_XM7_XM11_W16P8587_S001_LOW_W4 | TT_3P3_27C | 1 | 100001 | 1 | 1.4847728581698183 | 1.4847728581698183 | True | 240 | 240 | True | True | True | True | 0 | False | True | PREFIX_LIMITED_AFTER_5_FRAMES | /foss/designs/A44_SAR_ADC_CURRENT_CACE_REPRODUCIBLE_20260728_R1/06_RUN_OUTPUTS/DEBUG_DYNAMIC_PDK_FIX/P4_EVENT_NOISE_MC200_LOW/MC200_CMP_XM5_XM6_W8P2524_XM7_XM11_W16P8587_S001_LOW_W4/jobs/prefix5.spice | /foss/designs/A44_SAR_ADC_CURRENT_CACE_REPRODUCIBLE_20260728_R1/06_RUN_OUTPUTS/DEBUG_DYNAMIC_PDK_FIX/P4_EVENT_NOISE_MC200_LOW/MC200_CMP_XM5_XM6_W8P2524_XM7_XM11_W16P8587_S001_LOW_W4/logs/prefix5.log
01_MC200_TT_LOW_W4 | P4_EVENT_NOISE_MC200_LOW | MC200_CMP_XM5_XM6_W8P2524_XM7_XM11_W16P8587_S001_LOW_W4 | TT_3P3_27C | 1 | 100001 | 2 | 1.0128098982242102 | 1.0128098982242102 | True | 204 | 204 | True | True | True | True | 0 | False | True | PREFIX_LIMITED_AFTER_5_FRAMES | /foss/designs/A44_SAR_ADC_CURRENT_CACE_REPRODUCIBLE_20260728_R1/06_RUN_OUTPUTS/DEBUG_DYNAMIC_PDK_FIX/P4_EVENT_NOISE_MC200_LOW/MC200_CMP_XM5_XM6_W8P2524_XM7_XM11_W16P8587_S001_LOW_W4/jobs/prefix5.spice | /foss/designs/A44_SAR_ADC_CURRENT_CACE_REPRODUCIBLE_20260728_R1/06_RUN_OUTPUTS/DEBUG_DYNAMIC_PDK_FIX/P4_EVENT_NOISE_MC200_LOW/MC200_CMP_XM5_XM6_W8P2524_XM7_XM11_W16P8587_S001_LOW_W4/logs/prefix5.log
01_MC200_TT_LOW_W4 | P4_EVENT_NOISE_MC200_LOW | MC200_CMP_XM5_XM6_W8P2524_XM7_XM11_W16P8587_S001_LOW_W4 | TT_3P3_27C | 1 | 100001 | 3 | 0.08091612070784752 | 0.08091612070784752 | True | 134 | 134 | True | True | True | True | 0 | False | True | PREFIX_LIMITED_AFTER_5_FRAMES | /foss/designs/A44_SAR_ADC_CURRENT_CACE_REPRODUCIBLE_20260728_R1/06_RUN_OUTPUTS/DEBUG_DYNAMIC_PDK_FIX/P4_EVENT_NOISE_MC200_LOW/MC200_CMP_XM5_XM6_W8P2524_XM7_XM11_W16P8587_S001_LOW_W4/jobs/prefix5.spice | /foss/designs/A44_SAR_ADC_CURRENT_CACE_REPRODUCIBLE_20260728_R1/06_RUN_OUTPUTS/DEBUG_DYNAMIC_PDK_FIX/P4_EVENT_NOISE_MC200_LOW/MC200_CMP_XM5_XM6_W8P2524_XM7_XM11_W16P8587_S001_LOW_W4/logs/prefix5.log
01_MC200_TT_LOW_W4 | P4_EVENT_NOISE_MC200_LOW | MC200_CMP_XM5_XM6_W8P2524_XM7_XM11_W16P8587_S001_LOW_W4 | TT_3P3_27C | 1 | 100001 | 4 | -0.8874809752386567 | -0.8874809752386567 | True | 61 | 61 | True | True | True | True | 0 | False | True | PREFIX_LIMITED_AFTER_5_FRAMES | /foss/designs/A44_SAR_ADC_CURRENT_CACE_REPRODUCIBLE_20260728_R1/06_RUN_OUTPUTS/DEBUG_DYNAMIC_PDK_FIX/P4_EVENT_NOISE_MC200_LOW/MC200_CMP_XM5_XM6_W8P2524_XM7_XM11_W16P8587_S001_LOW_W4/jobs/prefix5.spice | /foss/designs/A44_SAR_ADC_CURRENT_CACE_REPRODUCIBLE_20260728_R1/06_RUN_OUTPUTS/DEBUG_DYNAMIC_PDK_FIX/P4_EVENT_NOISE_MC200_LOW/MC200_CMP_XM5_XM6_W8P2524_XM7_XM11_W16P8587_S001_LOW_W4/logs/prefix5.log
