tritone4801/chipathon-2026-A44-SAR-ADC/verification/a44_r2/02_SIMULATION_RESULTS/03_FULL255_STATIC/cases/S044_TT/plots/seed44_tt_full_static_transfer_curve.pdf

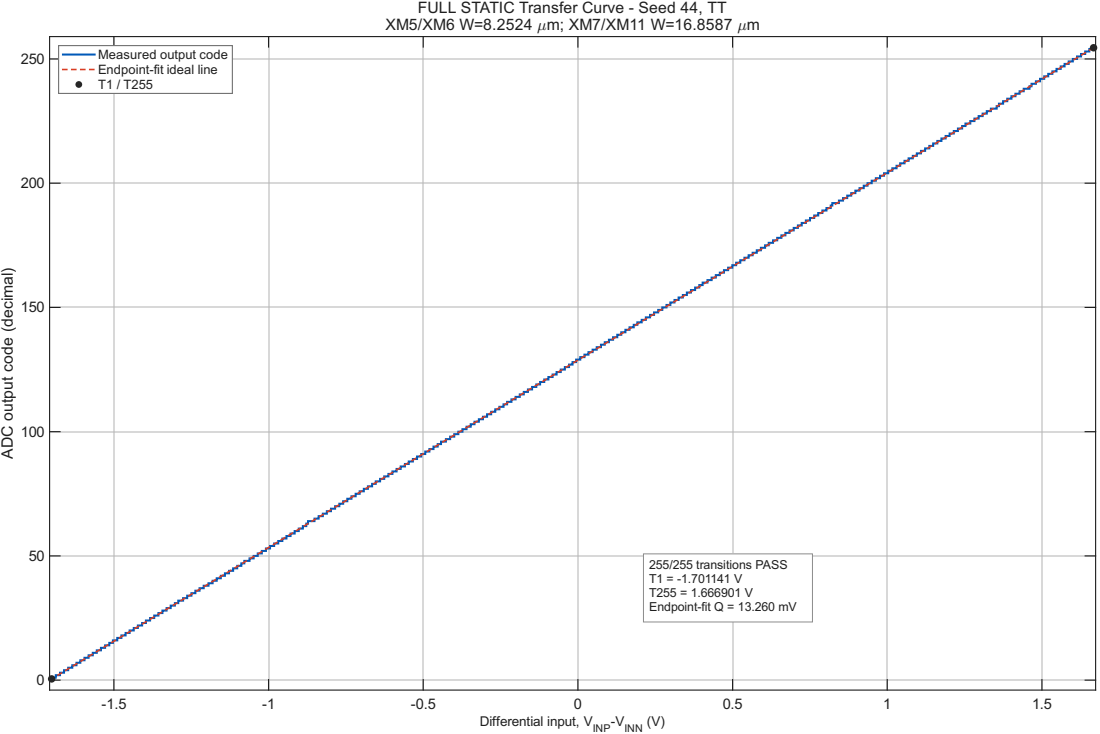
[picture p64: page 1]
-VINN; utp; cim; 255/255 transitions PASS T1 = -1.701141 V T255 = 1.666901 V Endpoint-fit Q = 13.260 mV

FULL STATIC Transfer Curve - Seed 44, TT

Measured output code
Endpoint-fit ideal line T1 / T255

Differential input, VINP
