tritone4801/chipathon-2026-A44-SAR-ADC/verification/a44_q2_analog_esd/verilog/SAR_LOGIC_ACTUAL_RTL_SS.pnl.v

module SAR_LOGIC_ACTUAL_RTL_SS (CLKS,
    CMPCK,
    DCMPN,
    DCMPP,
    VDD,
    VSS,
    DCTRLN,
    DCTRLP,
    DOUT);
 input CLKS;
 output CMPCK;
 input DCMPN;
 input DCMPP;
 inout VDD;
 inout VSS;
 output [7:1] DCTRLN;
 output [7:1] DCTRLP;
 output [7:0] DOUT;

 wire _000_;
 wire _001_;
 wire net40;
 wire net41;
 wire net42;
 wire net43;
 wire net44;
 wire net45;
 wire net46;
 wire net47;
 wire net48;
 wire net49;
 wire net50;
 wire net51;
 wire net52;
 wire net53;
 wire net54;
 wire net55;
 wire net56;
 wire net57;
 wire net58;
 wire net59;
 wire net60;
 wire net61;
 wire net62;
 wire net63;
 wire net64;
 wire net65;
 wire net66;
 wire net67;
 wire net68;
 wire net69;
 wire net70;
 wire CLKS_regs;
 wire _034_;
 wire _035_;
 wire _036_;
 wire _037_;
 wire _038_;
 wire _039_;
 wire _040_;
 wire _041_;
 wire _042_;
 wire _043_;
 wire _044_;
 wire _045_;
 wire _046_;
 wire _047_;
 wire _048_;
 wire _049_;
 wire _050_;
 wire _051_;
 wire _052_;
 wire _053_;
 wire _054_;
 wire _055_;
 wire _056_;
 wire _057_;
 wire _058_;
 wire _059_;
 wire _060_;
 wire _061_;
 wire _062_;
 wire _063_;
 wire _064_;
 wire _065_;
 wire _066_;
 wire _067_;
 wire _068_;
 wire _069_;
 wire _070_;
 wire _071_;
 wire _072_;
 wire _073_;
 wire _074_;
 wire _075_;
 wire _076_;
 wire _077_;
 wire _078_;
 wire _079_;
 wire _080_;
 wire _081_;
 wire _082_;
 wire _083_;
 wire _084_;
 wire _085_;
 wire _086_;
 wire _087_;
 wire _088_;
 wire _089_;
 wire _090_;
 wire _091_;
 wire _092_;
 wire _093_;
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
    .VSS(VSS));
 gf180mcu_fd_sc_mcu7t5v0__filltie TAP_TAPCELL_ROW_25_231 (.VDD(VDD),
    .VSS(VSS));
 gf180mcu_fd_sc_mcu7t5v0__filltie TAP_TAPCELL_ROW_25_232 (.VDD(VDD),
    .VSS(VSS));
 gf180mcu_fd_sc_mcu7t5v0__filltie TAP_TAPCELL_ROW_25_233 (.VDD(VDD),
    .VSS(VSS));
 gf180mcu_fd_sc_mcu7t5v0__filltie TAP_TAPCELL_ROW_25_234 (.VDD(VDD),
    .VSS(VSS));
 gf180mcu_fd_sc_mcu7t5v0__filltie TAP_TAPCELL_ROW_26_235 (.VDD(VDD),
    .VSS(VSS));
 gf180mcu_fd_sc_mcu7t5v0__filltie TAP_TAPCELL_ROW_26_236 (.VDD(VDD),
    .VSS(VSS));
 gf180mcu_fd_sc_mcu7t5v0__filltie TAP_TAPCELL_ROW_26_237 (.VDD(VDD),
    .VSS(VSS));
 gf180mcu_fd_sc_mcu7t5v0__filltie TAP_TAPCELL_ROW_26_238 (.VDD(VDD),
    .VSS(VSS));
 gf180mcu_fd_sc_mcu7t5v0__filltie TAP_TAPCELL_ROW_26_239 (.VDD(VDD),
    .VSS(VSS));
 gf180mcu_fd_sc_mcu7t5v0__filltie TAP_TAPCELL_ROW_27_240 (.VDD(VDD),
    .VSS(VSS));
 gf180mcu_fd_sc_mcu7t5v0__filltie TAP_TAPCELL_ROW_27_241 (.VDD(VDD),
    .VSS(VSS));
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
