tritone4801/chipathon-2026-A44-SAR-ADC/verification/ideal_sar/models/ideal_comparator.py

"""Ideal comparator for SAR threshold decisions."""


def decide(vdiff, threshold):
    """Return 1 when the input is greater than or equal to the threshold."""

    return 1 if vdiff >= threshold else 0
