tritone4801/chipathon-2026-A44-SAR-ADC/(commit log)

2026-07-04 Add A44 schematic review progress and results
    [dynamic_metrics_midband.csv, dynamic_metrics_near_nyquist.csv, metrics_summary.csv]
2026-07-28 Add audited A44 R2 package and current tracker
    [A44_FAST64_D3_MC10_PLAN_MANIFEST_V10.csv, A44_FAST64_D3_MC10_RUNTIME_ESTIMATE_V10.csv, A44_FAST64_D3_MC10_SELECTED_SEEDS_V10.csv, A44_FAST64_D3_ONLY_RUNTIME_ESTIMATE_V7.csv, A44_FAST64_SPECTRUM_PLOT_STYLE_V7.csv, A44_SAR_ADC_Project_Tracker_20260728_R2.xlsx, BASELINE_AND_VERIFICATION_FIRST5.csv, CACE_AND_TOOLS_INDEX.csv]
2026-07-28 Align repository structure with simple_SAR_ADC
    [adc_dac_reconstruction_low_frequency.csv, adc_input_output_time_low_frequency.csv, adc_input_output_time_near_nyquist.csv, adc_output_spectrum_low_frequency.csv, adc_output_spectrum_near_nyquist.csv, common_mode_invariance.csv, continuous_conversion_accounting_10000.csv, coverage_matrix.csv]
2026-08-15 Publish current A44 layout review
2026-08-15 Add A44 pad pin specification
2026-08-16 Publish W5P29 schematic baseline
    [A44_C16_SWITCH.sch, A44_C1_SWITCH.sch, A44_C2_SWITCH.sch, A44_C32_SWITCH.sch, A44_C4_SWITCH.sch, A44_C64_SWITCH.sch, A44_C8_SWITCH.sch, A44_CAP_SWITCH.sch]
2026-08-16 Clarify W5P29 schematic deltas
2026-08-23 fix: declare ground-first A44 interface
2026-08-29 Publish current cap x1/3 CDAC baseline
    [A44_C1_SWITCH.sch, A44_CDAC_UNIT_TRANS_DRIVER.sch, ACQUISITION_RESULTS.csv, MC100_OFFSET_PER_SEED.csv, SIMULATION_COVERAGE_CURRENT_VS_OLD.csv]
2026-08-29 Fix A44 layout binding to official DEF
    Bind the repository root to the DEF-aligned A44_A top, publish the current C6/R8-M6 CORE and bbox-normalized component files, and add fresh Magic/KLayout DRC plus GDS/DEF LVS evidence.
    [MODULE_NAMING_MAP.csv, PIN_ALIGNMENT.csv]
2026-09-03 Update A44 layout to the Q2 analog ESD implementation
    Refresh TOP, CORE and component GDS, routed DEF, LEF, native Magic cells and layout images. Bind the current analog ESD circuit reference through lvs_config.json and update the implementation, naming and image maps.
    Record the layout changes and retain the earlier GitHub layout selection. Documentation describes the implementation without adding qualification thresholds or result claims.
    [A44_SECONDARY_ESD_M2_SCHEM.sch, MODULE_NAMING_MAP.csv]
2026-09-05 Update A44 GDS and layout views from saved PG repair
    [MODULE_NAMING_MAP.csv]
2026-09-06 Use powered SAR gate netlist for mixed-signal LVS
2026-09-08 Publish current-driven PG layout repair
